tekkura/sr-cad/pcb/robot/usb-pd-module/ALTIUM_EMBEDDED_MODELS/LED 0603 Orange.STEP

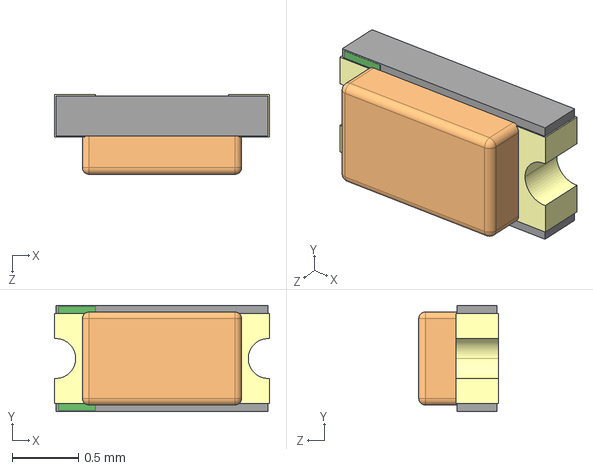
[picture p1: CAD file, 2026-01-23]
pcb/robot/usb-pd-module/ALTIUM_EMBEDDED_MODELS/LED 0603 Orange.STEP
1.62 x 0.8 x 0.6 mm
