tekkura/sr-cad/pcb/robot/usb-pd-module/ALTIUM_EMBEDDED_MODELS/Keystone_5012.stp

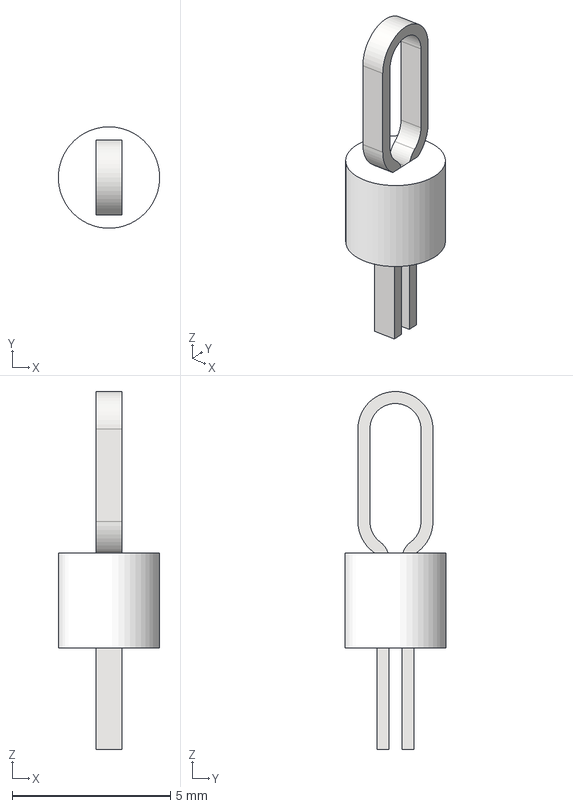
[picture p2: CAD file, 2026-01-23]
pcb/robot/usb-pd-module/ALTIUM_EMBEDDED_MODELS/Keystone_5012.stp
3.20 x 3.20 x 11.3 mm
