tekkura/sr-cad/pcb/robot/usb-pd-module/ALTIUM_EMBEDDED_MODELS/RES_0402.step

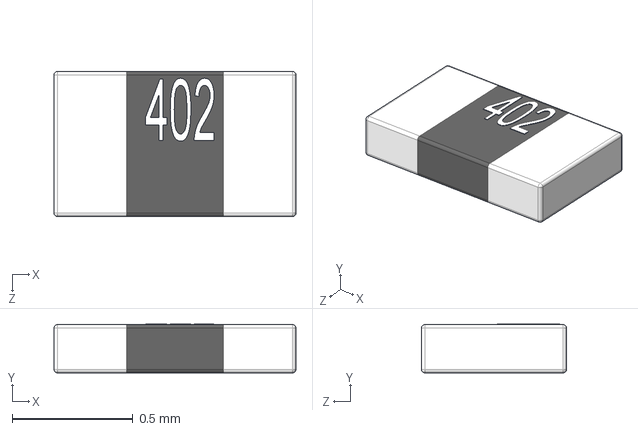
[picture p3: CAD file, 2026-01-23]
pcb/robot/usb-pd-module/ALTIUM_EMBEDDED_MODELS/RES_0402.step
1.00 x 0.202 x 0.6 mm
