tekkura/sr-cad/pcb/robot/usb-pd-module/ALTIUM_EMBEDDED_MODELS/SOIC-8.step

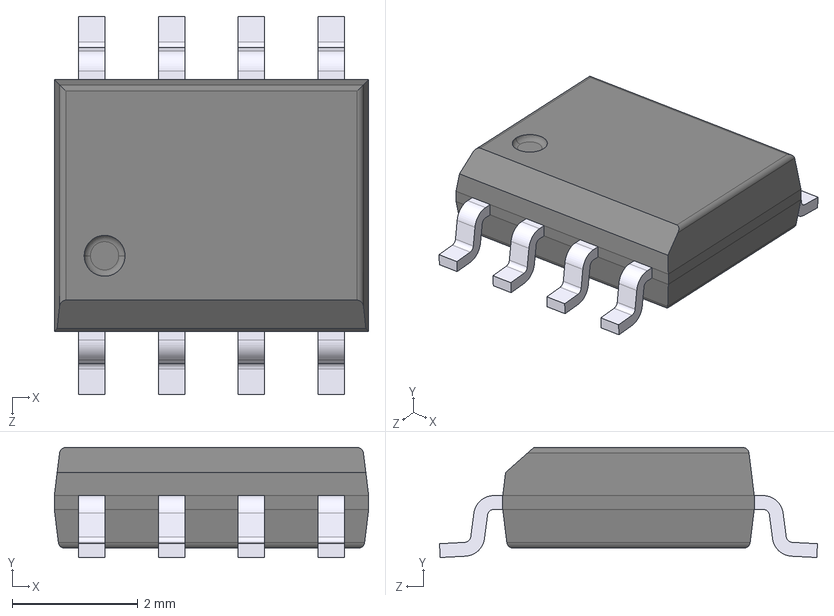
[picture p4: CAD file, 2026-01-23]
pcb/robot/usb-pd-module/ALTIUM_EMBEDDED_MODELS/SOIC-8.step
5.00 x 1.75 x 6.01 mm
User Library-SOIC-8_SOIC-8_Body_1
User Library-SOIC-8_SOIC-8_Pins_1
