tekkura/sr-cad/pcb/robot/usb-pd-module/ALTIUM_EMBEDDED_MODELS/On-Shore_ED555_2DS.stp

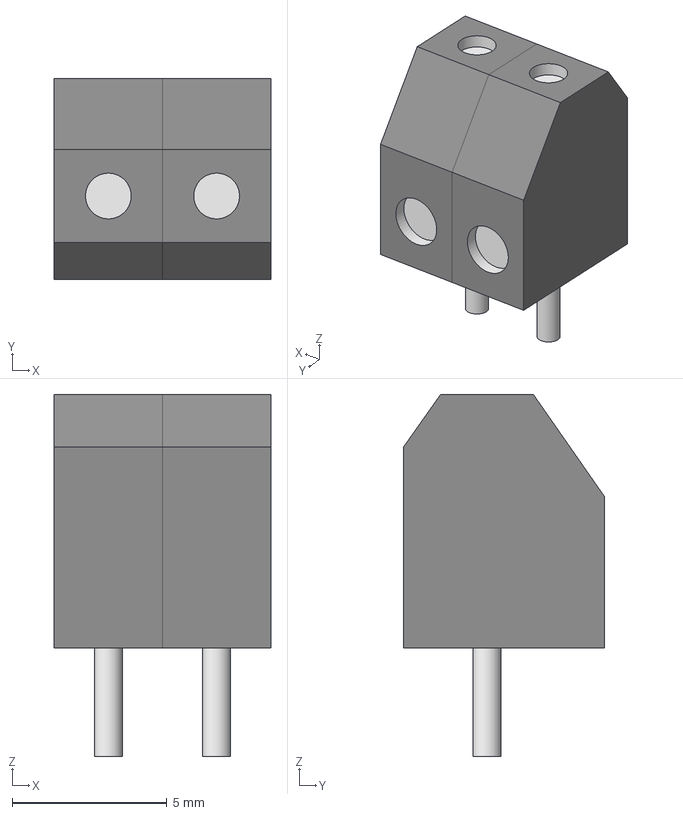
[picture p5: CAD file, 2026-01-23]
pcb/robot/usb-pd-module/ALTIUM_EMBEDDED_MODELS/On-Shore_ED555_2DS.stp
7.00 x 6.50 x 11.7 mm
