tekkura/sr-cad/pcb/robot/usb-pd-module/ALTIUM_EMBEDDED_MODELS/SOD-123.stp

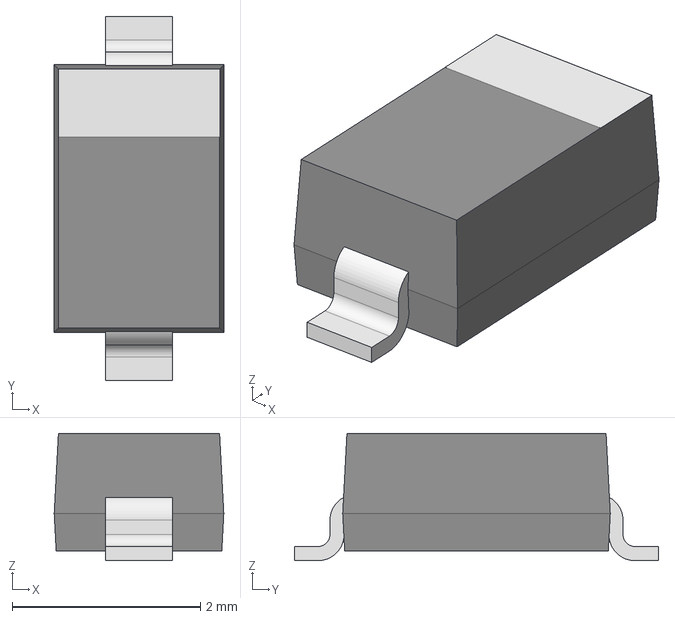
[picture p6: CAD file, 2026-01-23]
pcb/robot/usb-pd-module/ALTIUM_EMBEDDED_MODELS/SOD-123.stp
1.80 x 3.86 x 1.35 mm
