tekkura/sr-cad/pcb/robot/usb-pd-module/ALTIUM_EMBEDDED_MODELS/DQG0008A.stp

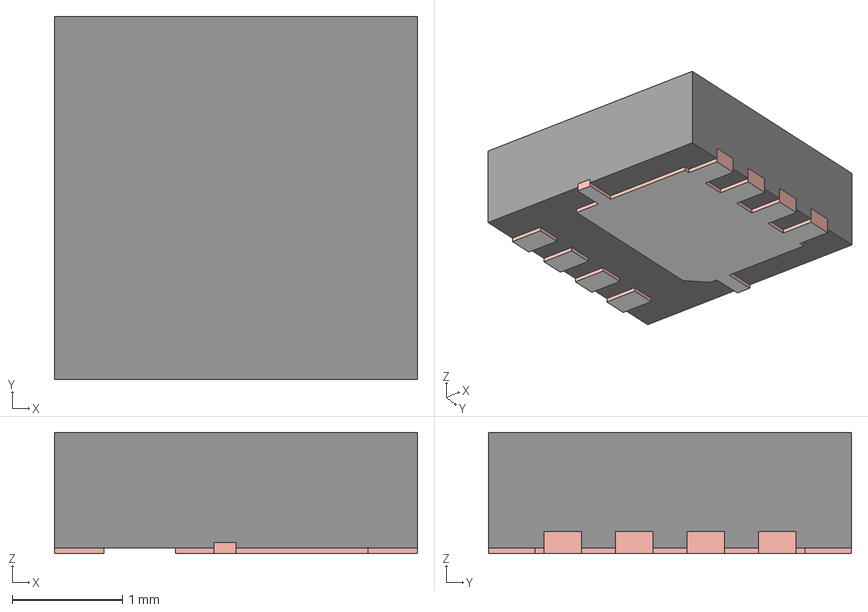
[picture p8: CAD file, 2026-01-23]
pcb/robot/usb-pd-module/ALTIUM_EMBEDDED_MODELS/DQG0008A.stp
3.30 x 3.30 x 1.10 mm
