tekkura/sr-cad/pcb/robot/usb-pd-module/ALTIUM_EMBEDDED_MODELS/SOT-23-5.step

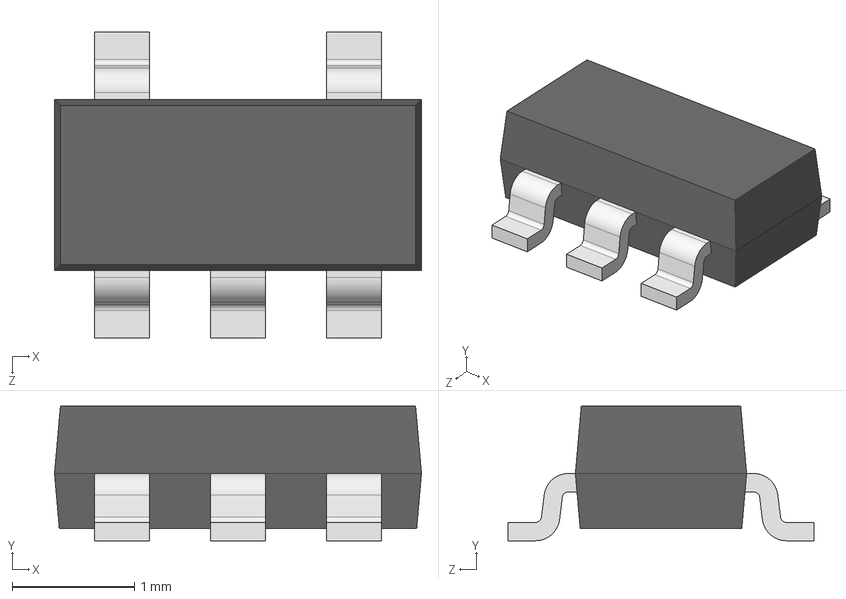
[picture p9: CAD file, 2026-01-23]
pcb/robot/usb-pd-module/ALTIUM_EMBEDDED_MODELS/SOT-23-5.step
3.00 x 1.10 x 2.50 mm
