tekkura/sr-cad/pcb/robot/usb-pd-module/ALTIUM_EMBEDDED_MODELS/CAP_C_0603.step

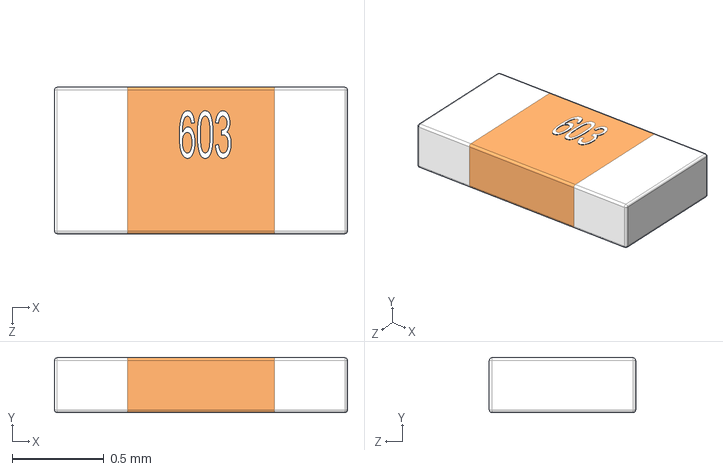
[picture p11: CAD file, 2026-01-23]
pcb/robot/usb-pd-module/ALTIUM_EMBEDDED_MODELS/CAP_C_0603.step
1.60 x 0.302 x 0.8 mm
