tekkura/sr-cad/pcb/robot/usb-pd-module/ALTIUM_EMBEDDED_MODELS/Res_TE_CRGP0402F33R_eec.STEP

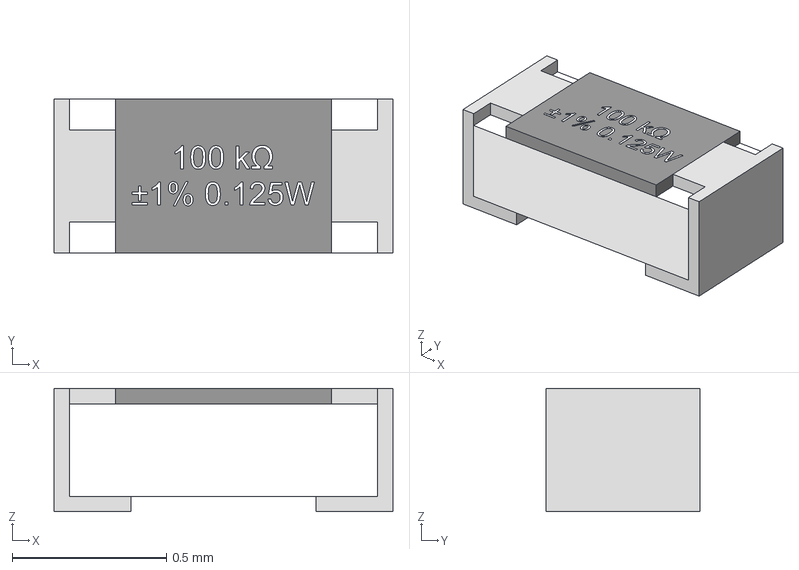
[picture p12: CAD file, 2026-01-23]
pcb/robot/usb-pd-module/ALTIUM_EMBEDDED_MODELS/Res_TE_CRGP0402F33R_eec.STEP
1.10 x 0.5 x 0.4 mm
terminals
top
value
