tekkura/sr-cad/pcb/robot/usb-pd-module/ALTIUM_EMBEDDED_MODELS/3M_2510-6002.stp

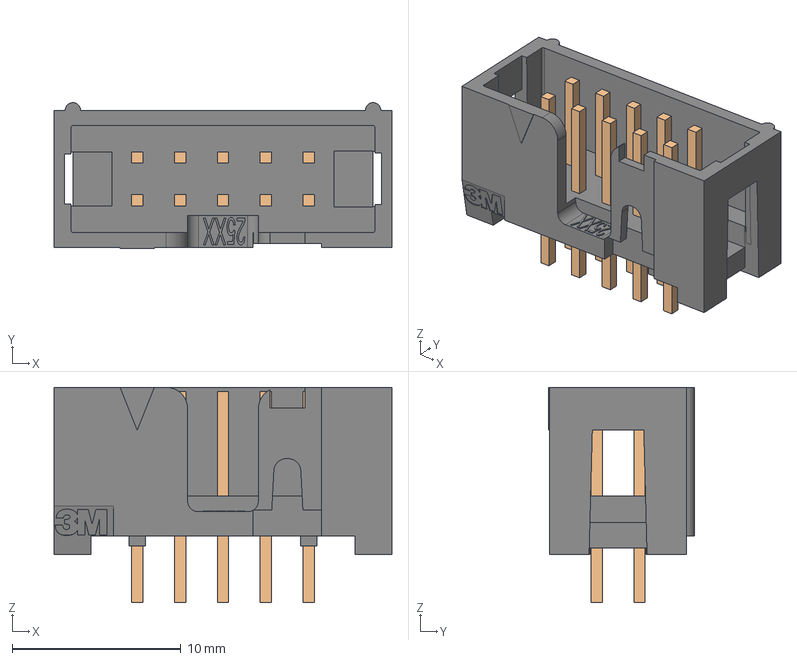
[picture p13: CAD file, 2026-01-23]
pcb/robot/usb-pd-module/ALTIUM_EMBEDDED_MODELS/3M_2510-6002.stp
20.0 x 8.64 x 12.8 mm
