tekkura/sr-cad/pcb/robot/usb-pd-module/ALTIUM_EMBEDDED_MODELS/Lite-On_LTST_C190.stp

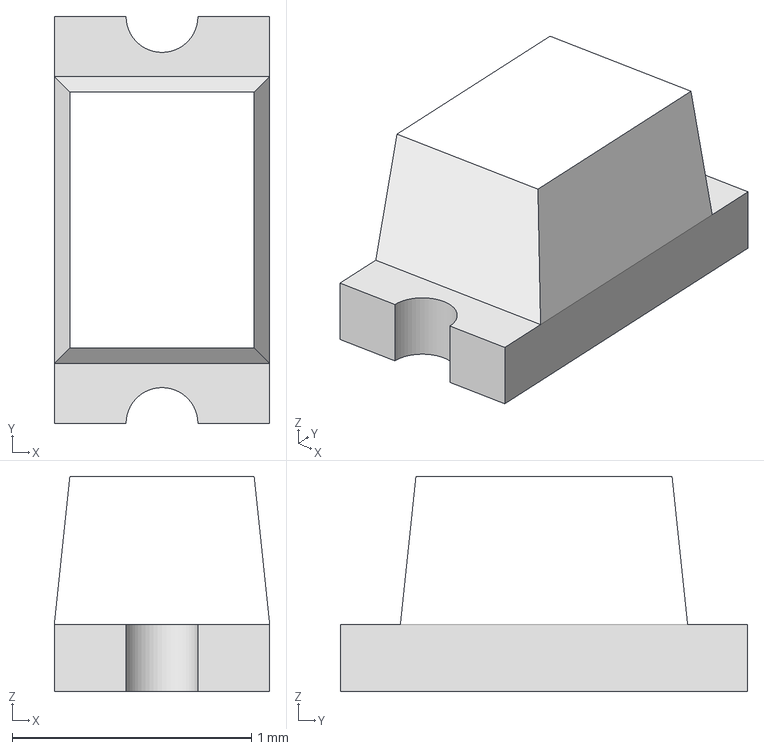
[picture p14: CAD file, 2026-01-23]
pcb/robot/usb-pd-module/ALTIUM_EMBEDDED_MODELS/Lite-On_LTST_C190.stp
0.9 x 1.70 x 0.9 mm
