tekkura/sr-cad/pcb/robot/usb-pd-module/ALTIUM_EMBEDDED_MODELS/Res_Vishay_CRCW06033M90FKEC_eec.STEP

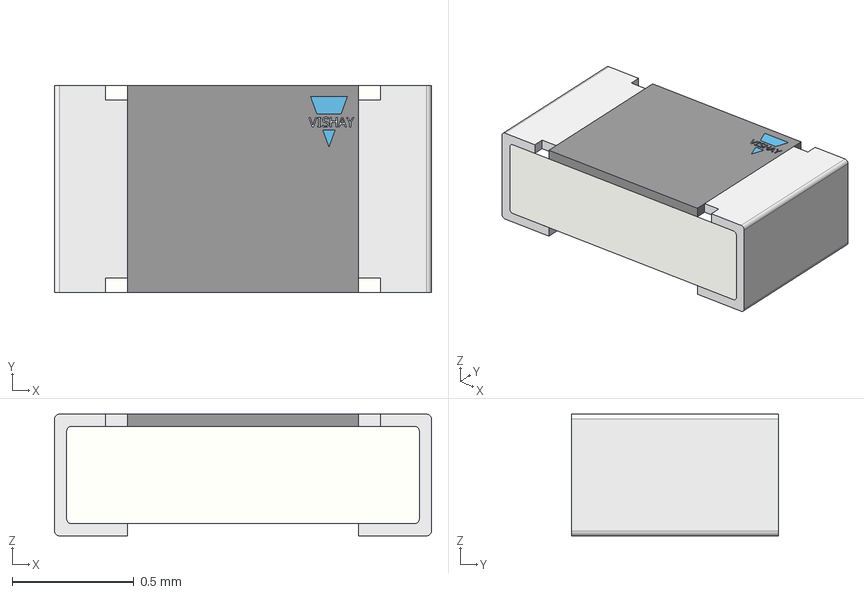
[picture p15: CAD file, 2026-01-23]
pcb/robot/usb-pd-module/ALTIUM_EMBEDDED_MODELS/Res_Vishay_CRCW06033M90FKEC_eec.STEP
1.55 x 0.85 x 0.5 mm
