tekkura/sr-cad/pcb/robot/usb-pd-module/ALTIUM_EMBEDDED_MODELS/Keystone_5000.stp

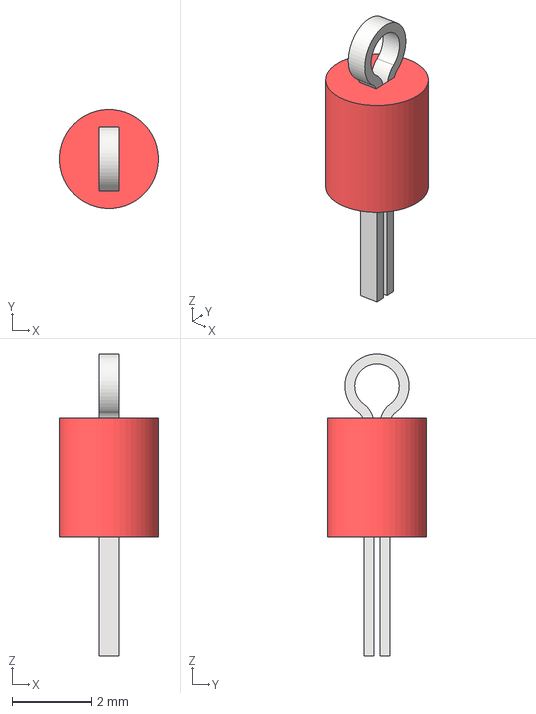
[picture p16: CAD file, 2026-01-23]
pcb/robot/usb-pd-module/ALTIUM_EMBEDDED_MODELS/Keystone_5000.stp
2.50 x 2.50 x 7.62 mm
