tekkura/sr-cad/pcb/robot/usb-pd-module/ALTIUM_EMBEDDED_MODELS/Conn_Harwin_M20-9990246_eec.STEP

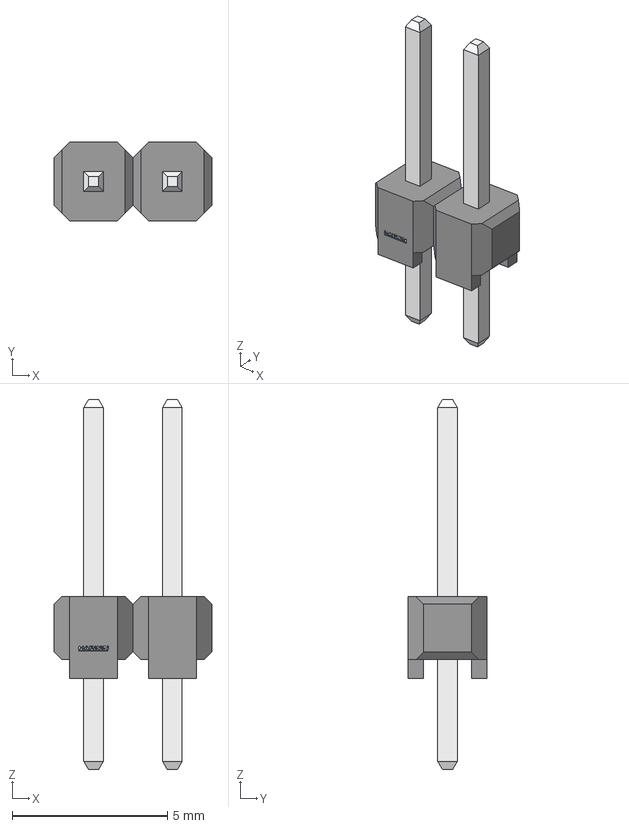
[picture p17: CAD file, 2026-01-23]
pcb/robot/usb-pd-module/ALTIUM_EMBEDDED_MODELS/Conn_Harwin_M20-9990246_eec.STEP
5.08 x 2.54 x 11.9 mm
