tekkura/sr-cad/pcb/robot/usb-pd-module/ALTIUM_EMBEDDED_MODELS/HDR_M_254_1x3.step

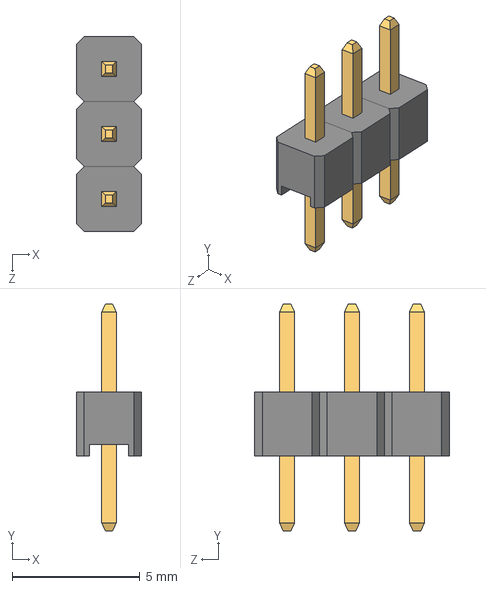
[picture p18: CAD file, 2026-01-23]
pcb/robot/usb-pd-module/ALTIUM_EMBEDDED_MODELS/HDR_M_254_1x3.step
2.54 x 8.88 x 7.62 mm
