tekkura/sr-cad/pcb/robot/usb-pd-module/ALTIUM_EMBEDDED_MODELS/DNH0008A.stp

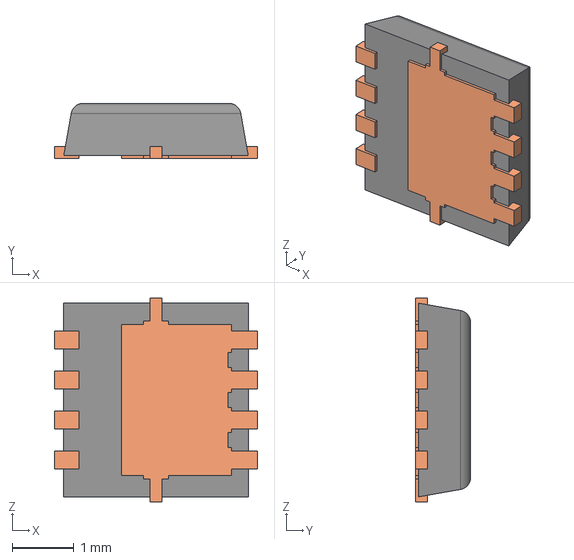
[picture p20: CAD file, 2026-01-23]
pcb/robot/usb-pd-module/ALTIUM_EMBEDDED_MODELS/DNH0008A.stp
3.30 x 0.9 x 3.31 mm
