tekkura/sr-cad/pcb/robot/usb-pd-module/ALTIUM_EMBEDDED_MODELS/ED1204DS.stp

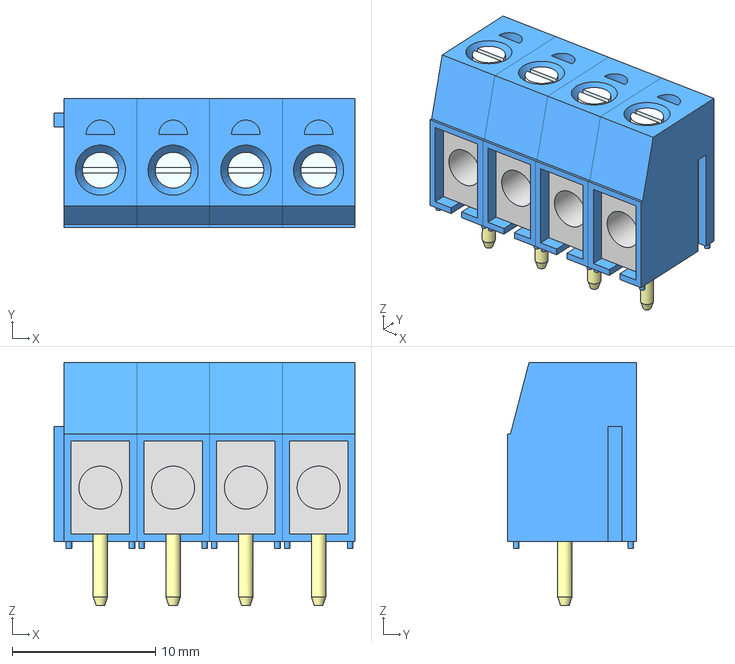
[picture p21: CAD file, 2026-01-23]
pcb/robot/usb-pd-module/ALTIUM_EMBEDDED_MODELS/ED1204DS.stp
21.0 x 9.00 x 17.0 mm
