tekkura/sr-cad/pcb/robot/usb-pd-module/ALTIUM_EMBEDDED_MODELS/3M_SJ5003Transparent.stp

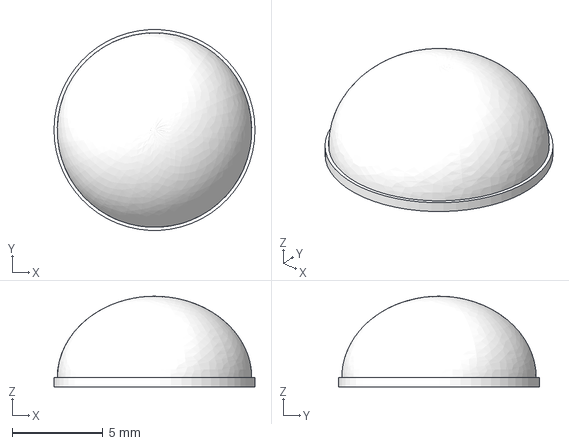
[picture p22: CAD file, 2026-01-23]
pcb/robot/usb-pd-module/ALTIUM_EMBEDDED_MODELS/3M_SJ5003Transparent.stp
11.1 x 11.1 x 5.00 mm
