tekkura/sr-cad/pcb/robot/usb-pd-module/ALTIUM_EMBEDDED_MODELS/SOD-323.stp

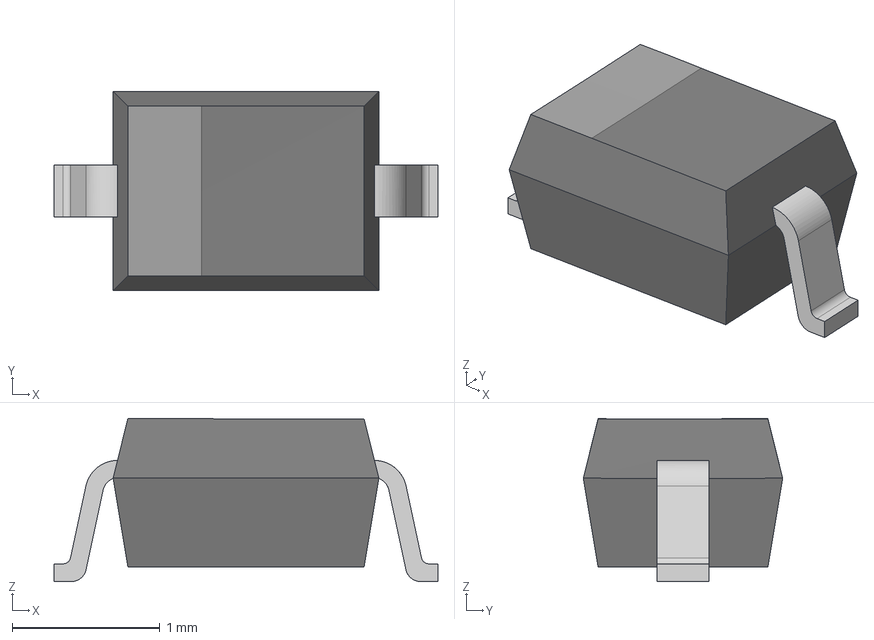
[picture p23: CAD file, 2026-01-23]
pcb/robot/usb-pd-module/ALTIUM_EMBEDDED_MODELS/SOD-323.stp
2.60 x 1.35 x 1.10 mm
