tekkura/sr-cad/pcb/robot/usb-pd-module/ALTIUM_EMBEDDED_MODELS/Conn_Samtec_SNT-100-BK-G_eec.STEP

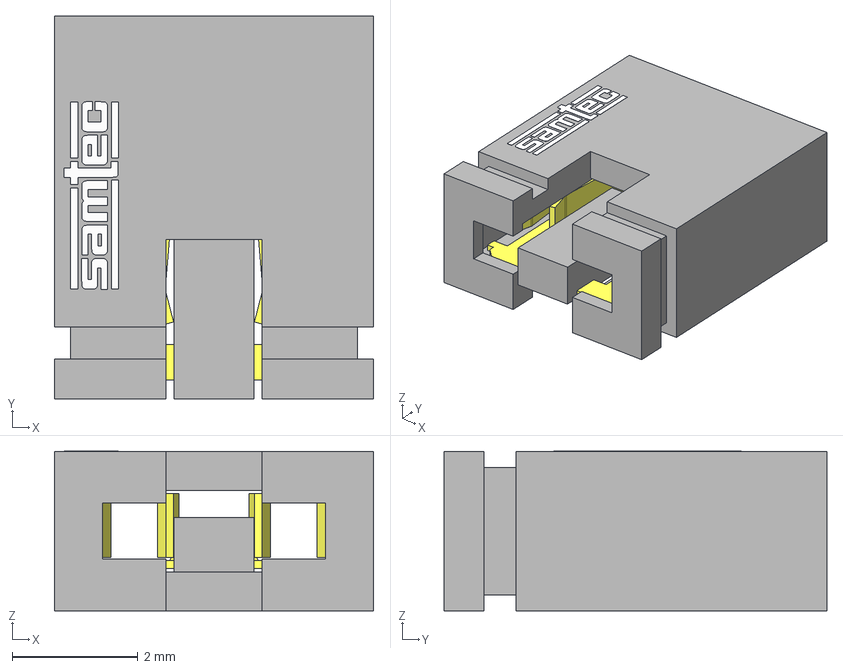
[picture p25: CAD file, 2026-01-23]
pcb/robot/usb-pd-module/ALTIUM_EMBEDDED_MODELS/Conn_Samtec_SNT-100-BK-G_eec.STEP
5.08 x 6.10 x 2.54 mm
SNT-100-BK_body
SNT-100_pins
Samtec
