tekkura/sr-cad/pcb/robot/usb-pd-module/ALTIUM_EMBEDDED_MODELS/Molex_22-05-3041.stp

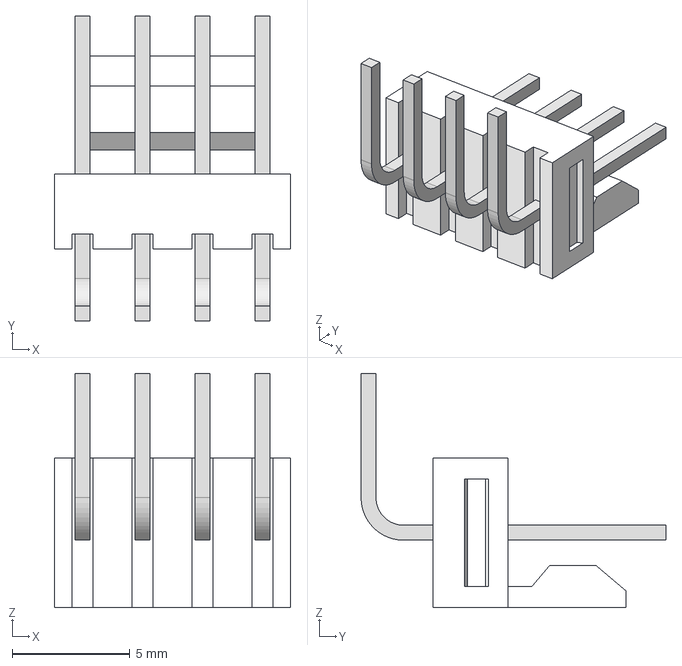
[picture p26: CAD file, 2026-01-23]
pcb/robot/usb-pd-module/ALTIUM_EMBEDDED_MODELS/Molex_22-05-3041.stp
10.0 x 12.9 x 9.93 mm
