tekkura/sr-cad/pcb/robot/usb-pd-module/ALTIUM_EMBEDDED_MODELS/keystone_5016.stp

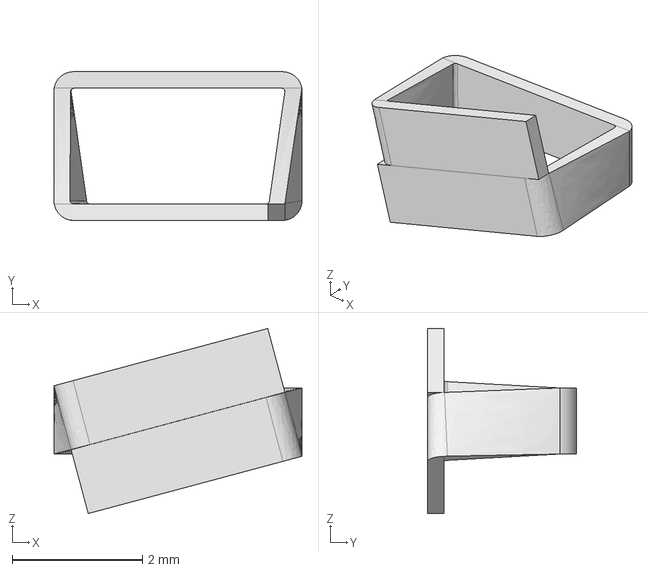
[picture p27: CAD file, 2026-01-23]
pcb/robot/usb-pd-module/ALTIUM_EMBEDDED_MODELS/keystone_5016.stp
3.81 x 2.29 x 2.85 mm
