tekkura/sr-cad/pcb/robot/usb-pd-module/ALTIUM_EMBEDDED_MODELS/ED1202DS.stp

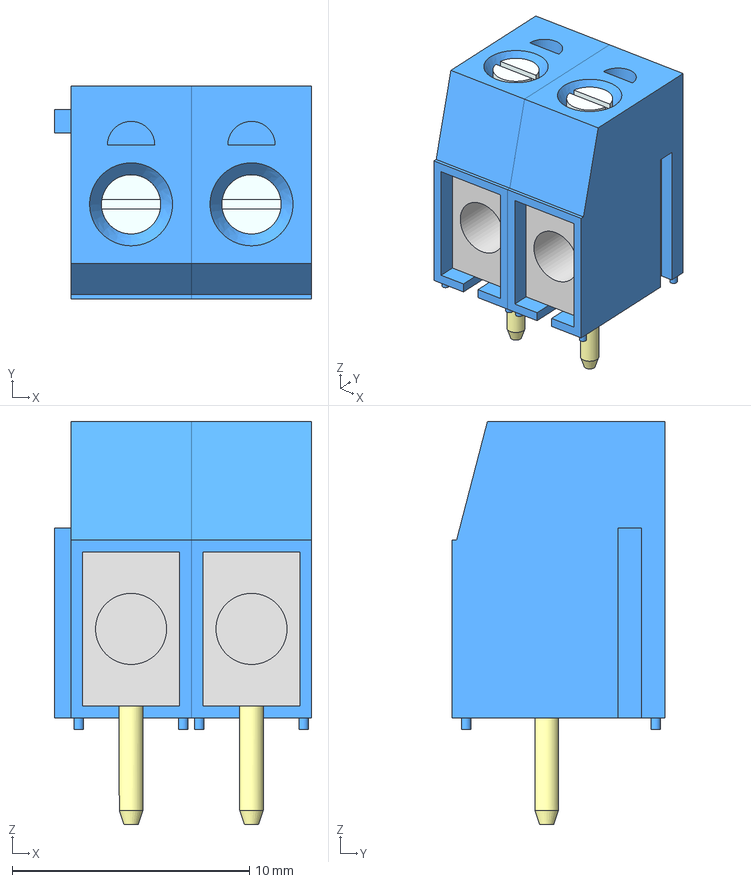
[picture p28: CAD file, 2026-01-23]
pcb/robot/usb-pd-module/ALTIUM_EMBEDDED_MODELS/ED1202DS.stp
10.9 x 9.00 x 17.0 mm
