tekkura/sr-cad/pcb/robot/usb-pd-module/ALTIUM_EMBEDDED_MODELS/DBZ0003A.stp

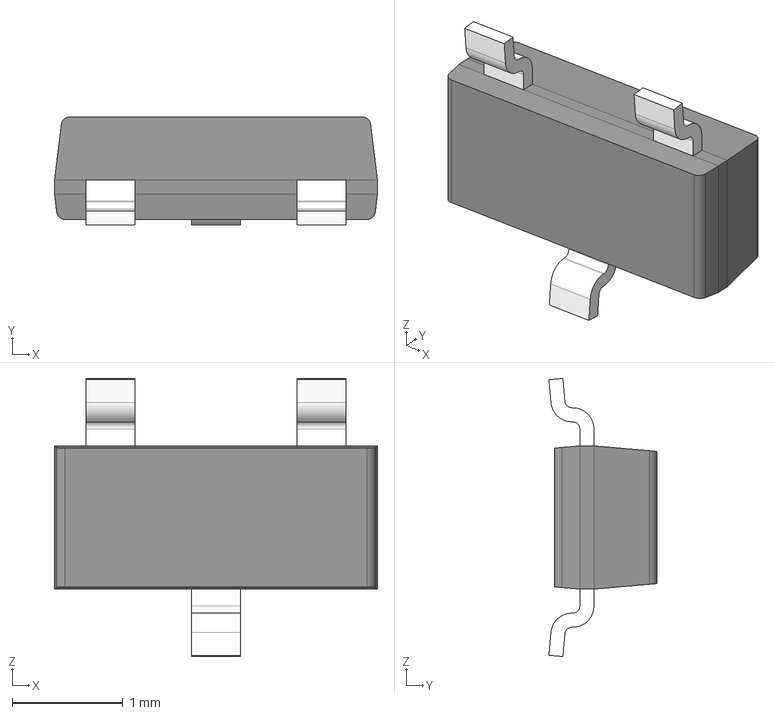
[picture p29: CAD file, 2026-01-23]
pcb/robot/usb-pd-module/ALTIUM_EMBEDDED_MODELS/DBZ0003A.stp
2.92 x 0.978 x 2.51 mm
