tekkura/sr-cad/(list of files, cad)

Other CAD files:
pcb/robot/usb-pd-module/ALTIUM_EMBEDDED_MODELS/LED 0603 Green.STEP
pcb/robot/usb-pd-module/ALTIUM_EMBEDDED_MODELS/Keystone_5002.stp
pcb/robot/usb-pd-module/ALTIUM_EMBEDDED_MODELS/Keystone_5003.stp
pcb/robot/usb-pd-module/ALTIUM_EMBEDDED_MODELS/Keystone_5004.stp
pcb/robot/usb-pd-module/ALTIUM_EMBEDDED_MODELS/CAP_C_0402.step
pcb/robot/usb-pd-module/ALTIUM_EMBEDDED_MODELS/20021111-00010XXLFc.stp
