tekkura/sr-cad/pcb/robot/robot.kicad_pcb

## KiCad design pcb/robot/robot.kicad_pcb (2026-08-28)

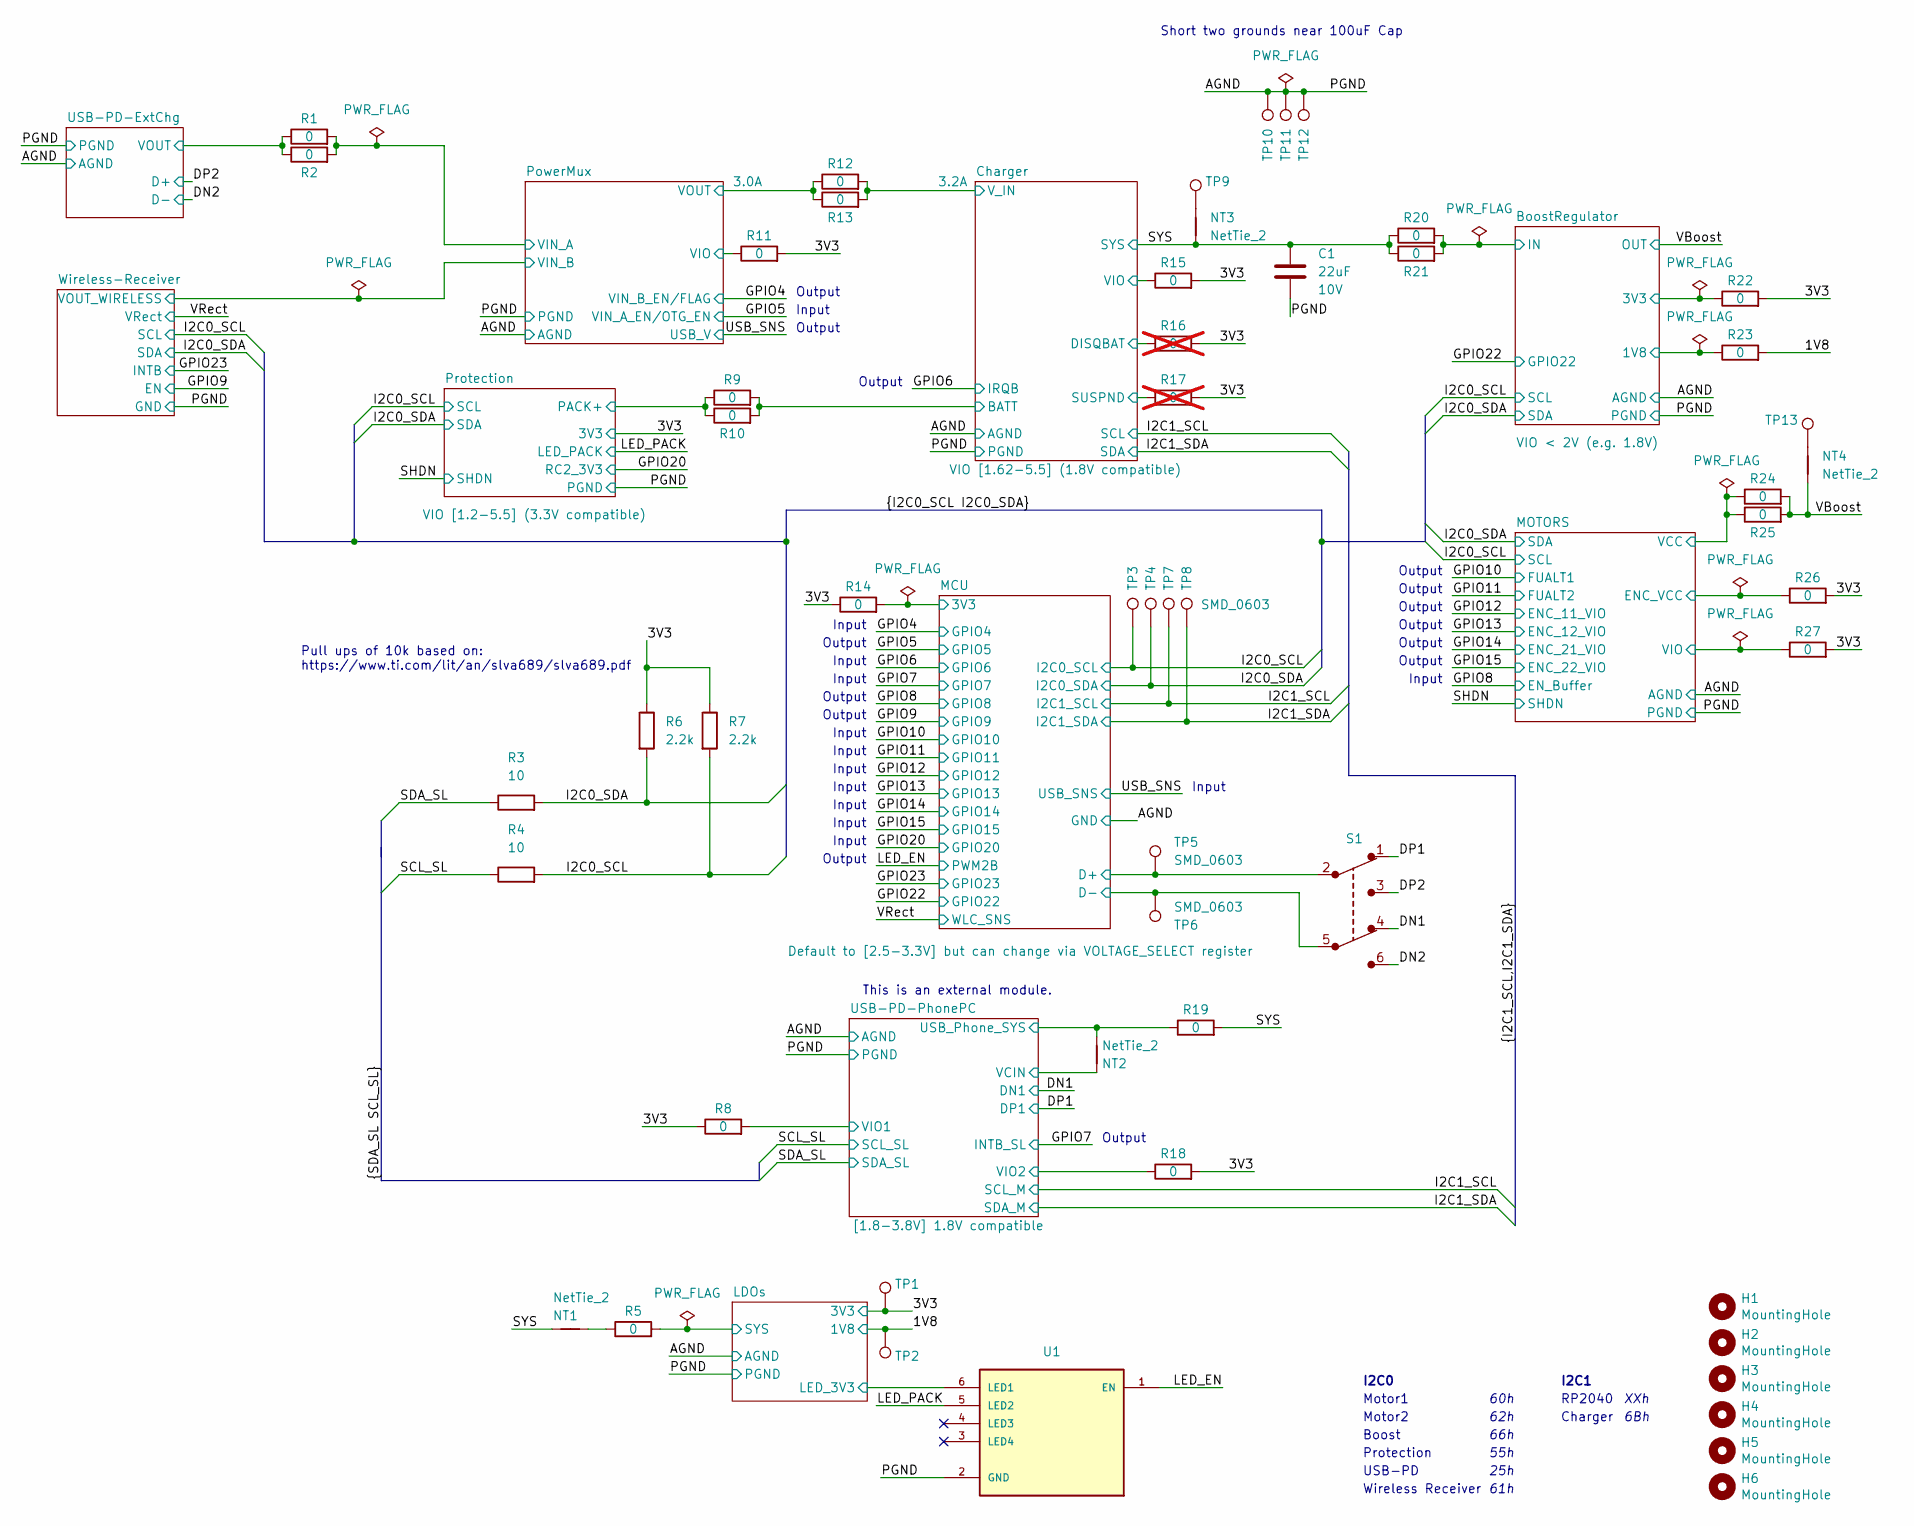
[picture p30: schematic robot.kicad_sch]

Parts:
C1: 22uF; C_0603_1608Metric; Part Number GRM188R61A226ME15D
H1, H2, H5, H6: MountingHole; MountingHole_2.2mm_M2_2mm_clearance; Part Number N/A
H3, H4: MountingHole; MountingHole_2.2mm_M2; Part Number N/A
NT1, NT2, NT3, NT4: NetTie_2; NetTie-_SMD_Pad6mil; Part Number N/A
R1, R2, R9, R10, R12, R13, R19, R20, R21, R24, R25: 0; R_0805_2012Metric; Part Number RMCF0805ZT0R00
R3, R4: 10; R_0402_1005Metric; Part Number RC0402FR-1310RL
R5, R8, R11, R14, R15, R18, R22, R23, R26, R27: 0; R_0603_1608Metric; Part Number RMCF0603ZT0R00
R6, R7: 2.2k; R_0603_1608Metric; Part Number RMCF0603JT2K20
R16, R17: 0; R_0603_1608Metric; Part Number RMCF0603ZT0R00; not fitted
S1: JS202011JCQN; SW_JS202011JCQN; Part Number JS202011JCQN
TP1, TP2, TP9, TP10, TP11, TP12, TP13: TestPoint; KEYSTONE_5002; Part Number 5002
TP3, TP4, TP5, TP6, TP7, TP8: SMD_0603; TestPoint_SMD_0603; Part Number RCUCTE
U1: AP2502KTR-G1; SOT95P280X145-6N; Part Number AP2502KTR-G1

Connections:
/1V8: R23.2, TP2.1; also elsewhere on the board
/3V3: R6.1, R7.1, R8.1, R11.2, R14.1, R15.2, R16.2, R17.2, R18.2, R22.2, R26.2, R27.2, TP1.1; also elsewhere on the board
/BoostRegulator/1V8: R23.1; also elsewhere on the board
/BoostRegulator/3V3: R22.1; also elsewhere on the board
/BoostRegulator/IN: R20.2, R21.2; also elsewhere on the board
/Charger/BATT: R9.2, R10.2; also elsewhere on the board
/Charger/DISQBAT: R16.1; also elsewhere on the board
/Charger/SUSPND: R17.1; also elsewhere on the board
/Charger/VIO: R15.1; also elsewhere on the board
/Charger/V_IN: R12.2, R13.2; also elsewhere on the board
/DN1: S1.4; also elsewhere on the board
/DN2: S1.6; also elsewhere on the board
/DP1: S1.1; also elsewhere on the board
/DP2: S1.3; also elsewhere on the board
/I2C0_SCL: R4.2, R7.2, TP3.1; also elsewhere on the board
/I2C0_SDA: R3.2, R6.2, TP4.1; also elsewhere on the board
/I2C1_SCL: TP7.1; also elsewhere on the board
/I2C1_SDA: TP8.1; also elsewhere on the board
/LDOs/LED_3V3: U1.6 (LED1); also elsewhere on the board
/LDOs/SYS: R5.2; also elsewhere on the board
/LED_EN: U1.1 (EN); also elsewhere on the board
/LED_PACK: U1.5 (LED2); also elsewhere on the board
/MCU/3V3: R14.2; also elsewhere on the board
/MCU/D+: S1.2, TP5.1; also elsewhere on the board
/MCU/D-: S1.5, TP6.1; also elsewhere on the board
/MOTORS/ENC_VCC: R26.1; also elsewhere on the board
/MOTORS/VCC: R24.1, R25.1; also elsewhere on the board
/MOTORS/VIO: R27.1; also elsewhere on the board
/PowerMux/VIN_A: R1.2, R2.2; also elsewhere on the board
/PowerMux/VIO: R11.1; also elsewhere on the board
/PowerMux/VOUT: R12.1, R13.1; also elsewhere on the board
/Protection/PACK+: R9.1, R10.1; also elsewhere on the board
/SCL_SL: R4.1; also elsewhere on the board
/SDA_SL: R3.1; also elsewhere on the board
/SYS: C1.1, NT1.1, NT3.2, R19.2, R20.1, R21.1; also elsewhere on the board
/USB-PD-ExtChg/VOUT: R1.1, R2.1; also elsewhere on the board
/USB-PD-PhonePC/USB_Phone_SYS: NT2.2, R19.1; also elsewhere on the board
/USB-PD-PhonePC/VCIN: NT2.1; also elsewhere on the board
/USB-PD-PhonePC/VIO1: R8.2; also elsewhere on the board
/USB-PD-PhonePC/VIO2: R18.1; also elsewhere on the board
/VBoost: NT4.2, R24.2, R25.2; also elsewhere on the board
GND: C1.2, TP10.1, TP11.1, TP12.1, U1.2 (GND); also elsewhere on the board
unnamed: NT1.2, R5.1
unnamed: NT3.1, TP9.1
unnamed: NT4.1, TP13.1

Notes on the sheet:
55h
Input
66h
Output
Protection
XXh
61h
Boost
I2C1
Wireless Receiver
Motor1
62h
Motor2
25h
Charger
This is an external module.
Pull ups of 10k based on: https://www.ti.com/lit/an/slva689/slva689.pdf
I2C0
USB-PD
RP2040
60h
6Bh
Short two grounds near 100uF Cap

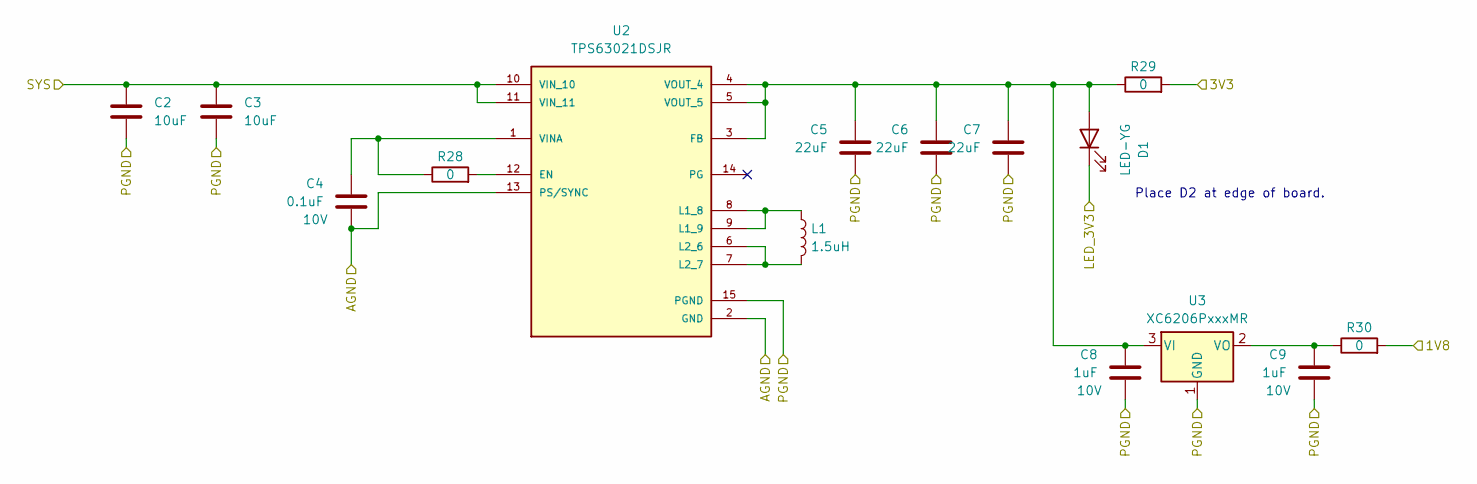
[picture p31: schematic LDO.kicad_sch]

Parts:
C2, C3: 10uF; C_0603_1608Metric; Part Number GRM188R61E106KA73J
C4: 0.1uF; C_0402_1005Metric; Part Number CL05A104KA5NNNC
C5, C6, C7: 22uF; C_0603_1608Metric; Part Number GRM188R61A226ME15D
C8, C9: 1uF; C_0402_1005Metric; Part Number GRM155R61E105KA12D
D1: LED-YG; B12H1UYG-20D000134U1930; Part Number B12H1UYG-20D000134U1930
L1: 1.5uH; NRS6028T1R5NMGJ; Part Number NRS6028T1R5NMGJ
R28, R29, R30: 0; R_0603_1608Metric; Part Number RMCF0603ZT0R00
U2: TPS63021DSJR; IC_TPS63021DSJR; PARTREV I; DigiKey_Part_Number 296-27259-1-ND
U3: XC6206PxxxMR; SOT-23-3; Part Number C49195704

Connections:
/1V8: R30.2; also elsewhere on the board
/3V3: R29.2; also elsewhere on the board
/LDOs/LED_3V3: D1.1 (K); also elsewhere on the board
/LDOs/SYS: C2.2, C3.2, U2.10 (VIN_10), U2.11 (VIN_11); also elsewhere on the board
GND: C2.1, C3.1, C4.2, C5.2, C6.2, C7.2, C8.2, C9.2, U2.2 (GND), U2.13 (PS/SYNC), U2.15 (PGND), U3.1 (GND); also elsewhere on the board
unnamed: C5.1, C6.1, C7.1, C8.1, D1.2 (A), R29.1, U2.3 (FB), U2.4 (VOUT_4), U2.5 (VOUT_5), U3.3 (VI)
unnamed: R28.2, U2.12 (EN)
unnamed: L1.1, U2.8 (L1_8), U2.9 (L1_9)
unnamed: L1.2, U2.6 (L2_6), U2.7 (L2_7)
unnamed: C4.1, R28.1, U2.1 (VINA)
unnamed: C9.1, R30.1, U3.2 (VO)

Notes on the sheet:
Place D2 at edge of board.

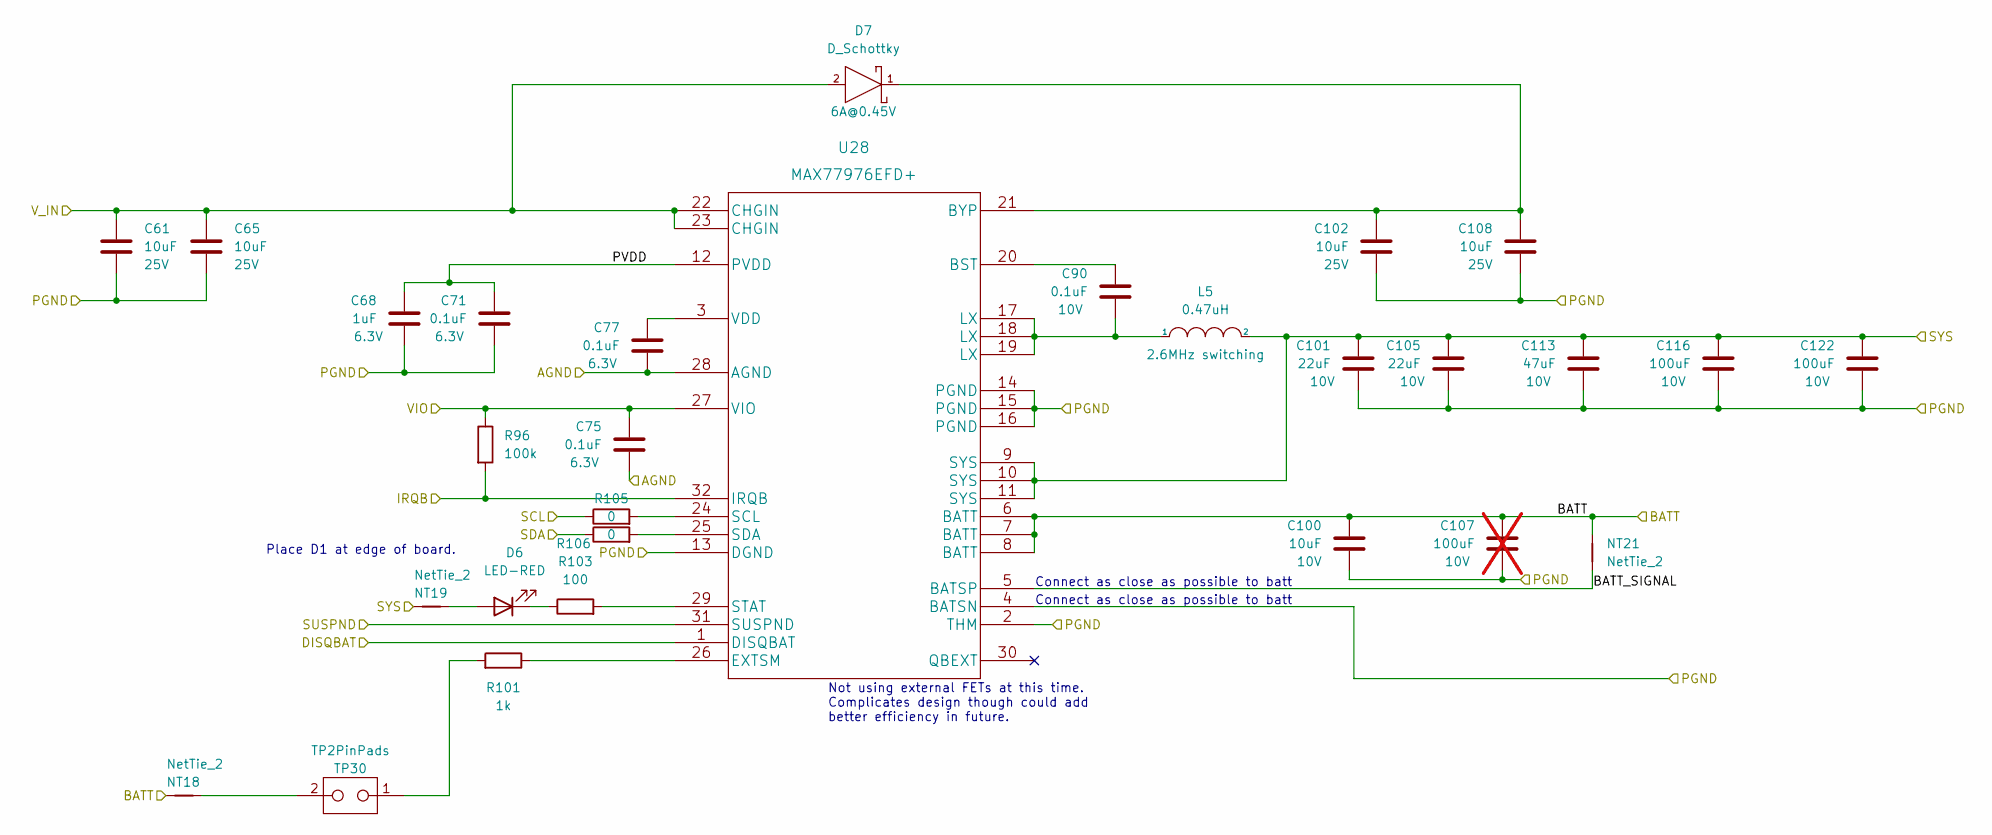
[picture p32: schematic Charger.kicad_sch]

Parts:
C61, C65, C100, C102, C108: 10uF; C_0603_1608Metric; Part Number GRM188R61E106KA73J
C68: 1uF; C_0402_1005Metric; Part Number GRM155R61E105KA12D
C71, C75, C77, C90: 0.1uF; C_0402_1005Metric; Part Number CL05A104KA5NNNC
C101, C105: 22uF; C_0603_1608Metric; Part Number GRM188R61A226ME15D
C107: 100uF; C_1206_3216Metric; Part Number GRM31CD80J107MEA8K; not fitted
C113: 47uF; C_0805_2012Metric; Part Number CL21A476MRYNNNE
C116, C122: 100uF; C_1206_3216Metric; Part Number GRM31CD80J107MEA8K
D6: LED-RED; B12H1UYG-20D000134U1930; Part Number B12H1USD-20D000234U1930
D7: D_Schottky; SD2114S040S8R0; Part Number SD2114S040S8R0
L5: 0.47uH; Vishay-IHLP-2020BZ-FP_1.905x2.79-3D_2.0-0-0-MFG; Part Number IHLP2020BZERR47M01
NT18, NT19, NT21: NetTie_2; NetTie-_SMD_Pad6mil; Part Number N/A
R96: 100k; R_0603_1608Metric; Part Number WR06X1003FTL
R101: 1k; R_0402_1005Metric; Part Number WR04X102 JTL
R103: 100; R_0603_1608Metric; Part Number RMCF0603JT100R
R105, R106: 0; R_0603_1608Metric; Part Number RMCF0603ZT0R00
TP30: TP2PinPads; TestPoint_2Pads_Pitch2mm_SMD; Part Number N/A
U28: MAX77976EFD+; MAX77976; Part Number MAX77976EFD+

Connections:
/Charger/BATT: C100.1, C107.1, NT18.1, NT21.1, U28.6 (BATT), U28.7 (BATT), U28.8 (BATT); also elsewhere on the board
/Charger/BATT_SIGNAL: NT21.2, U28.5 (BATSP)
/Charger/DISQBAT: U28.1 (DISQBAT); also elsewhere on the board
/Charger/PVDD: C68.1, C71.1, U28.12 (PVDD)
/Charger/SUSPND: U28.31 (SUSPND); also elsewhere on the board
/Charger/VIO: C75.1, R96.1, U28.27 (VIO); also elsewhere on the board
/Charger/V_IN: C61.1, C65.1, D7.2 (Anode), U28.22 (CHGIN), U28.23 (CHGIN); also elsewhere on the board
/GPIO6: R96.2, U28.32 (IRQB); also elsewhere on the board
/I2C1_SCL: R105.1; also elsewhere on the board
/I2C1_SDA: R106.1; also elsewhere on the board
/SYS: C101.1, C105.1, C113.1, C116.1, C122.1, L5.2, NT19.1, U28.9 (SYS), U28.10 (SYS), U28.11 (SYS); also elsewhere on the board
GND: C61.2, C65.2, C68.2, C71.2, C75.2, C77.2, C100.2, C101.2, C102.2, C105.2, C107.2, C108.2, C113.2, C116.2, C122.2, U28.2 (THM), U28.4 (BATSN), U28.13 (DGND), U28.14 (PGND), U28.15 (PGND), U28.16 (PGND), U28.28 (AGND); also elsewhere on the board
unnamed: C90.2, L5.1, U28.17 (LX), U28.18 (LX), U28.19 (LX)
unnamed: D6.2 (A), NT19.2
unnamed: D6.1 (K), R103.1
unnamed: C102.1, C108.1, D7.1 (Cathode), U28.21 (BYP)
unnamed: NT18.2, TP30.2
unnamed: R101.2, TP30.1
unnamed: C90.1, U28.20 (BST)
unnamed: R101.1, U28.26 (EXTSM)
unnamed: R105.2, U28.24 (SCL)
unnamed: R106.2, U28.25 (SDA)
unnamed: R103.2, U28.29 (STAT)
unnamed: C77.1, U28.3 (VDD)

Notes on the sheet:
Not using external FETs at this time. Complicates design though could add better efficiency in future.
Connect as close as possible to batt
Place D1 at edge of board.

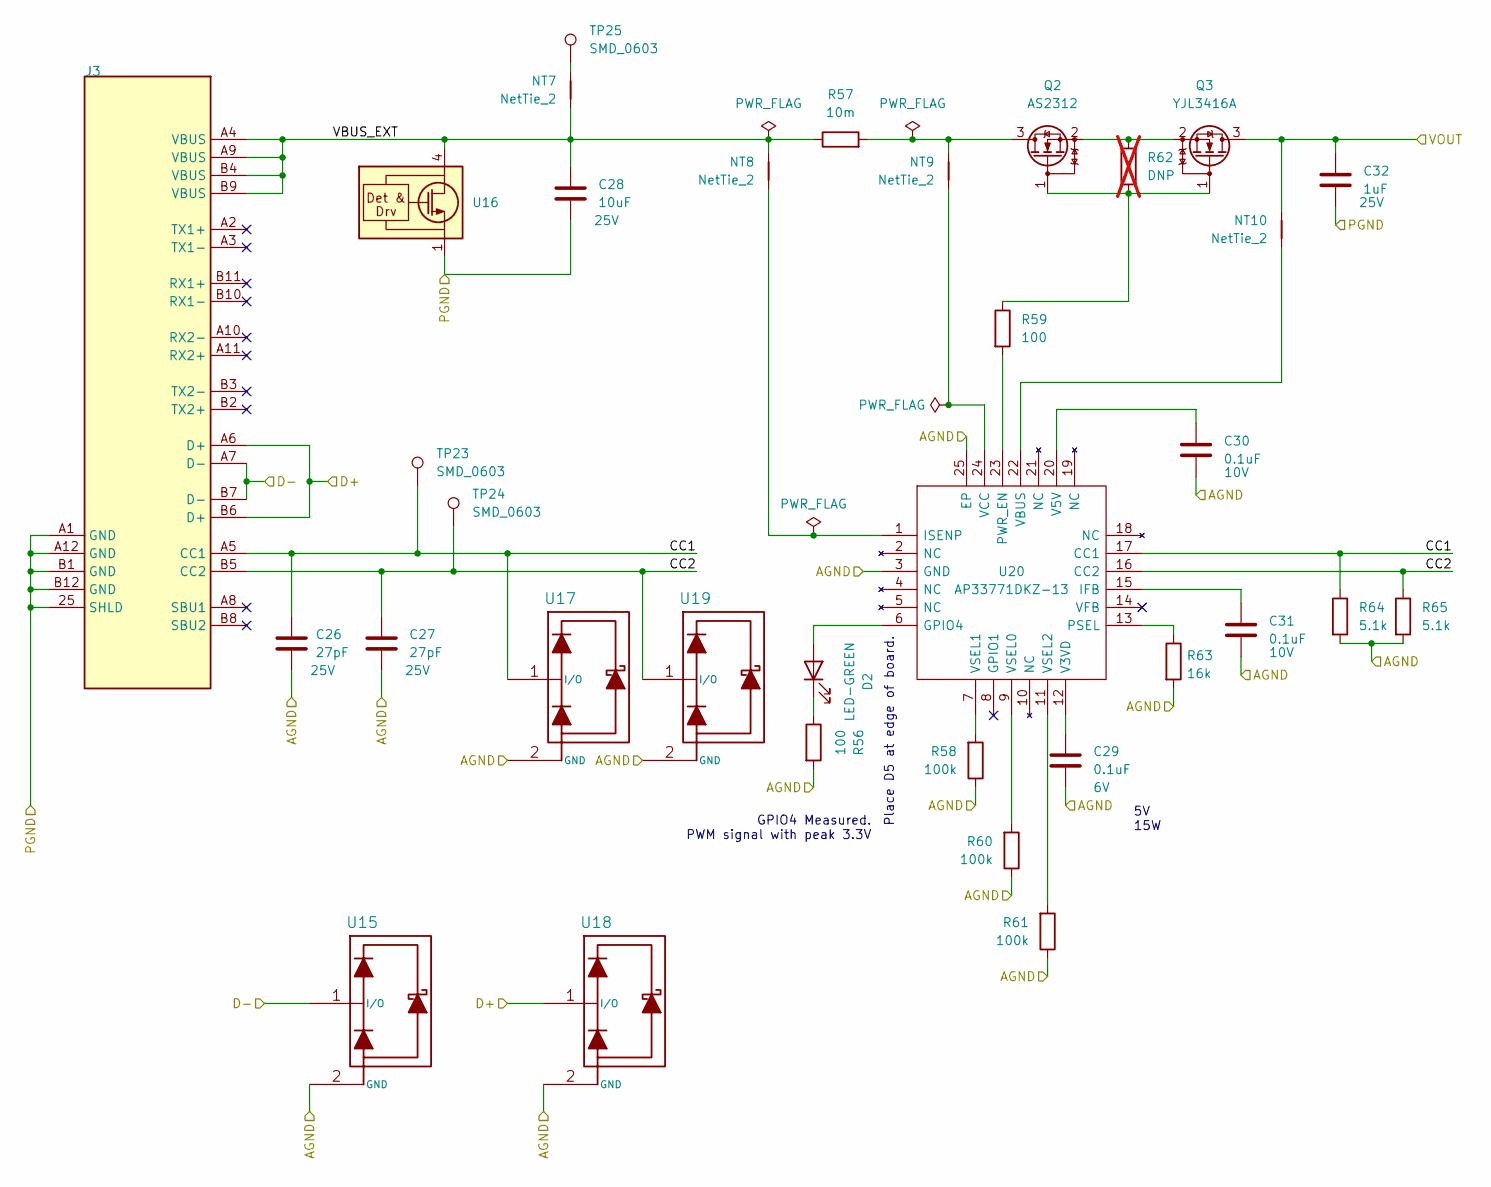
[picture p33: schematic USB-PD-ExtChg.kicad_sch]

Parts:
C26, C27: 27pF; C_0402_1005Metric; Part Number GRM1555C1H270JA01J
C28: 10uF; C_0603_1608Metric; Part Number GRM188R61E106KA73J
C29, C30, C31: 0.1uF; C_0402_1005Metric; Part Number CL05A104KA5NNNC
C32: 1uF; C_0402_1005Metric; Part Number GRM155R61E105KA12D
D2: LED-GREEN; B12H1UYG-20D000134U1930; Part Number B12H1NG--20D000134U1930
J3: USBC_Receptacle_SMD_RA; CON_USB3.1-C_RCPT_SMD_RA_ACP_12401610E4#2A; Part Number 12401610E4#2A
NT7, NT8, NT9, NT10: NetTie_2; NetTie-_SMD_Pad6mil; Part Number N/A
Q2: AS2312; SOT-23; Part Number AS2312
Q3: YJL3416A; SOT-23; Part Number YJL3416A
R56, R59: 100; R_0603_1608Metric; Part Number RMCF0603JT100R
R57: 10m; R_1206_3216Metric; Part Number ERJ-8CWJR010V
R58, R60, R61: 100k; R_0603_1608Metric; Part Number WR06X1003FTL
R62: DNP; R_0603_1608Metric; Part Number DNP; not fitted
R63: 16k; R_0603_1608Metric; Part Number RMCF0603FT16K0
R64, R65: 5.1k; R_0603_1608Metric; Part Number RMCF0603JT5K10
TP23, TP24, TP25: SMD_0603; TestPoint_SMD_0603; Part Number RCUCTE
U15, U17, U18, U19: TPD1E05U06; TPD1E05U06DPYR; Part Number TPD1E05U06DPYR
U16: TVS0500DRV; TVS0500DRVR; Part Number TVS0500DRVR
U20: AP33771DKZ-13; AP33771DKZ13; Part Number AP33771DKZ-13

Connections:
/DN2: J3.A7 (D-), J3.B7 (D-), U15.1 (I/O); also elsewhere on the board
/DP2: J3.A6 (D+), J3.B6 (D+), U18.1 (I/O); also elsewhere on the board
/USB-PD-ExtChg/CC1: C26.1, J3.A5 (CC1), R64.1, TP23.1, U17.1 (I/O), U20.17 (CC1)
/USB-PD-ExtChg/CC2: C27.1, J3.B5 (CC2), R65.1, TP24.1, U19.1 (I/O), U20.16 (CC2)
/USB-PD-ExtChg/VBUS_EXT: C28.1, J3.A4 (VBUS), J3.A9 (VBUS), J3.B4 (VBUS), J3.B9 (VBUS), NT7.2, NT8.1, R57.1, U16.4 (IN), U16.5 (IN), U16.6 (IN)
/USB-PD-ExtChg/VOUT: C32.1, NT10.1, Q3.3 (D); also elsewhere on the board
GND: C26.2, C27.2, C28.2, C29.2, C30.2, C31.2, C32.2, J3.25 (SHLD), J3.A1 (GND), J3.A12 (GND), J3.B1 (GND), J3.B12 (GND), R56.2, R58.1, R60.1, R61.1, R63.2, R64.2, R65.2, U15.2 (GND), U16.1 (GND), U16.2 (GND), U16.3 (GND), U16.7 (GND), U17.2 (GND), U18.2 (GND), U19.2 (GND), U20.3 (GND), U20.25 (EP); also elsewhere on the board
unnamed: D2.2 (A), U20.6 (GPIO4)
unnamed: D2.1 (K), R56.1
unnamed: NT7.1, TP25.1
unnamed: NT9.1, Q2.3 (D), R57.2
unnamed: Q2.1 (G), Q3.1 (G), R59.1, R62.2
unnamed: Q2.2 (S), Q3.2 (S), R62.1
unnamed: C31.1, U20.15 (IFB)
unnamed: NT8.2, U20.1 (ISENP)
unnamed: R63.1, U20.13 (PSEL)
unnamed: R59.2, U20.23 (PWR_EN)
unnamed: C29.1, U20.12 (V3VD)
unnamed: C30.1, U20.20 (V5V)
unnamed: NT10.2, U20.22 (VBUS)
unnamed: NT9.2, U20.24 (VCC)
unnamed: R60.2, U20.9 (VSEL0)
unnamed: R58.2, U20.7 (VSEL1)
unnamed: R61.2, U20.11 (VSEL2)

Notes on the sheet:
5V 15W
Place D5 at edge of board.
GPIO4 Measured. PWM signal with peak 3.3V

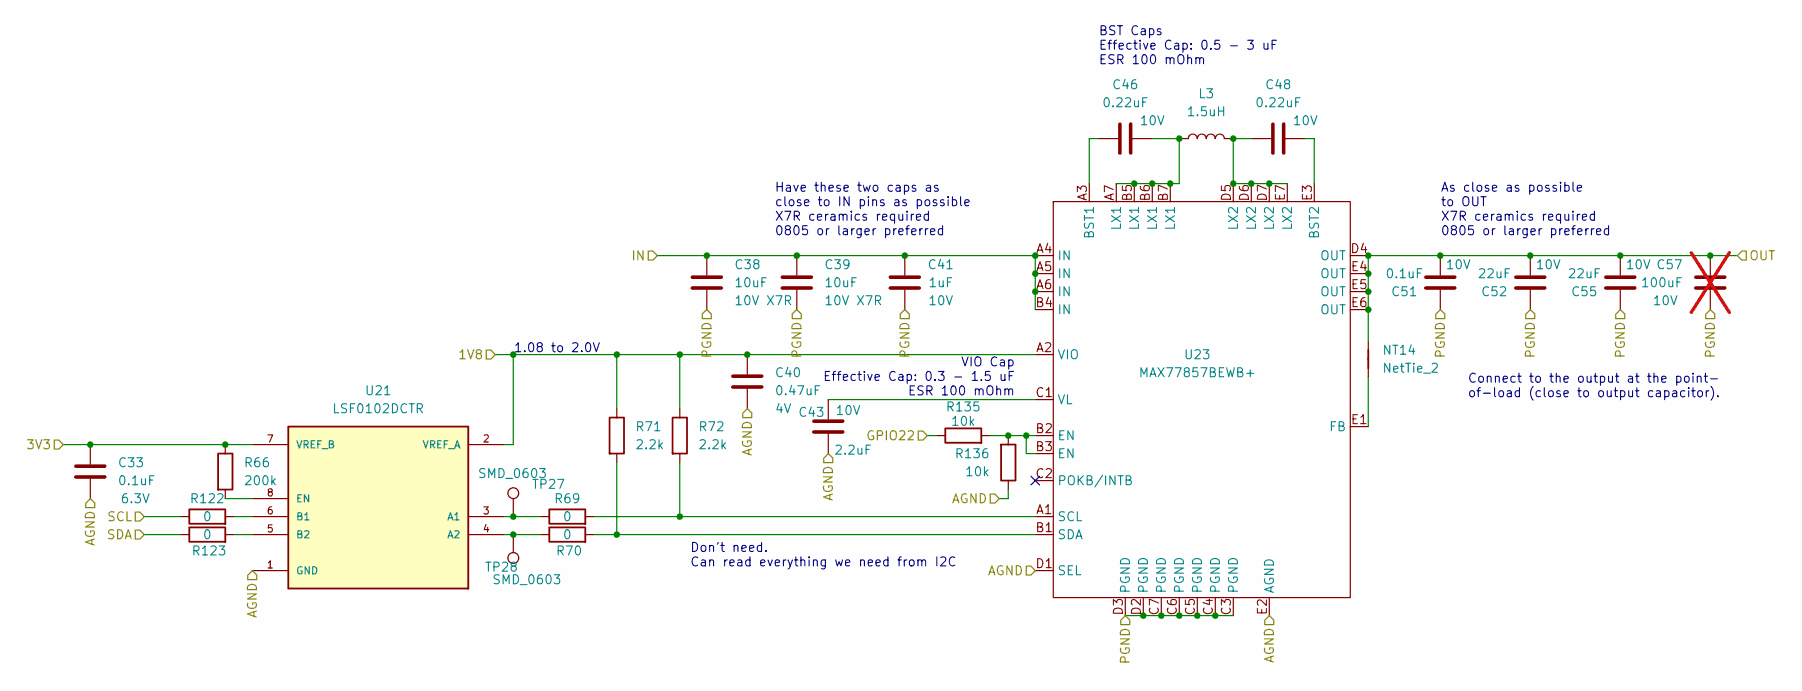
[picture p34: schematic boostRegulator.kicad_sch]

Parts:
C33, C51: 0.1uF; C_0402_1005Metric; Part Number CL05A104KA5NNNC
C38, C39: 10uF; C_0603_1608Metric; Part Number GRM188R61E106KA73J
C40: 0.47uF; C_0603_1608Metric; Part Number CL10B474KO8NNNC
C41: 1uF; C_0402_1005Metric; Part Number GRM155R61E105KA12D
C43: 2.2uF; C_0603_1608Metric; Part Number CL10A225KP8NNNC
C46, C48: 0.22uF; C_0603_1608Metric; Part Number CL10B224KA8NNNC
C52, C55: 22uF; C_0603_1608Metric; Part Number GRM188R61A226ME15D
C57: 100uF; C_1206_3216Metric; Part Number GRM31CD80J107MEA8K; not fitted
L3: 1.5uH; NRS6028T1R5NMGJ; Part Number NRS6028T1R5NMGJ
NT14: NetTie_2; NetTie-_SMD_Pad6mil; Part Number N/A
R66: 200k; R_0603_1608Metric; Part Number RMCF0603JT200K
R69, R70, R122, R123: 0; R_0603_1608Metric; Part Number RMCF0603ZT0R00
R71, R72: 2.2k; R_0603_1608Metric; Part Number RMCF0603JT2K20
R135, R136: 10k; R_0603_1608Metric; Part Number WR06X1002FTL
TP27, TP28: SMD_0603; TestPoint_SMD_0603; Part Number RCUCTE
U21: LSF0102DCTR; SOP65P400X130-8N; Part Number LSF0102DCTR
U23: MAX77857BEWB+; WLP-35_7x5_2.828x2.028mm; Part Number MAX77857BEWB+

Connections:
/BoostRegulator/1V8: C40.1, R71.1, R72.1, U21.2 (VREF_A), U23.A2 (VIO); also elsewhere on the board
/BoostRegulator/3V3: C33.1, R66.1, U21.7 (VREF_B); also elsewhere on the board
/BoostRegulator/IN: C38.1, C39.1, C41.2, U23.A4 (IN), U23.A5 (IN), U23.A6 (IN), U23.B4 (IN); also elsewhere on the board
/GPIO22: R135.1; also elsewhere on the board
/I2C0_SCL: R122.1; also elsewhere on the board
/I2C0_SDA: R123.1; also elsewhere on the board
/VBoost: C51.2, C52.2, C55.2, C57.1, NT14.1, U23.D4 (OUT), U23.E4 (OUT), U23.E5 (OUT), U23.E6 (OUT); also elsewhere on the board
GND: C33.2, C38.2, C39.2, C40.2, C41.1, C43.2, C51.1, C52.1, C55.1, C57.2, R136.1, U21.1 (GND), U23.C3 (PGND), U23.C4 (PGND), U23.C5 (PGND), U23.C6 (PGND), U23.C7 (PGND), U23.D1 (SEL), U23.D2 (PGND), U23.D3 (PGND), U23.E2 (AGND); also elsewhere on the board
unnamed: C46.2, L3.1, U23.A7 (LX1), U23.B5 (LX1), U23.B6 (LX1), U23.B7 (LX1)
unnamed: C48.1, L3.2, U23.D5 (LX2), U23.D6 (LX2), U23.D7 (LX2), U23.E7 (LX2)
unnamed: R135.2, R136.2, U23.B2 (EN), U23.B3 (EN)
unnamed: R69.1, TP27.1, U21.3 (A1)
unnamed: R70.1, TP28.1, U21.4 (A2)
unnamed: R122.2, U21.6 (B1)
unnamed: R123.2, U21.5 (B2)
unnamed: R66.2, U21.8 (EN)
unnamed: C46.1, U23.A3 (BST1)
unnamed: C48.2, U23.E3 (BST2)
unnamed: NT14.2, U23.E1 (FB)
unnamed: R69.2, R72.2, U23.A1 (SCL)
unnamed: R70.2, R71.2, U23.B1 (SDA)
unnamed: C43.1, U23.C1 (VL)

Notes on the sheet:
Have these two caps as close to IN pins as possible X7R ceramics required 0805 or larger preferred
Connect to the output at the point- of-load (close to output capacitor).
Don't need. Can read everything we need from I2C
BST Caps Effective Cap: 0.5 - 3 uF ESR 100 mOhm
1.08 to 2.0V
As close as possible to OUT X7R ceramics required 0805 or larger preferred
VIO Cap Effective Cap: 0.3 - 1.5 uF ESR 100 mOhm

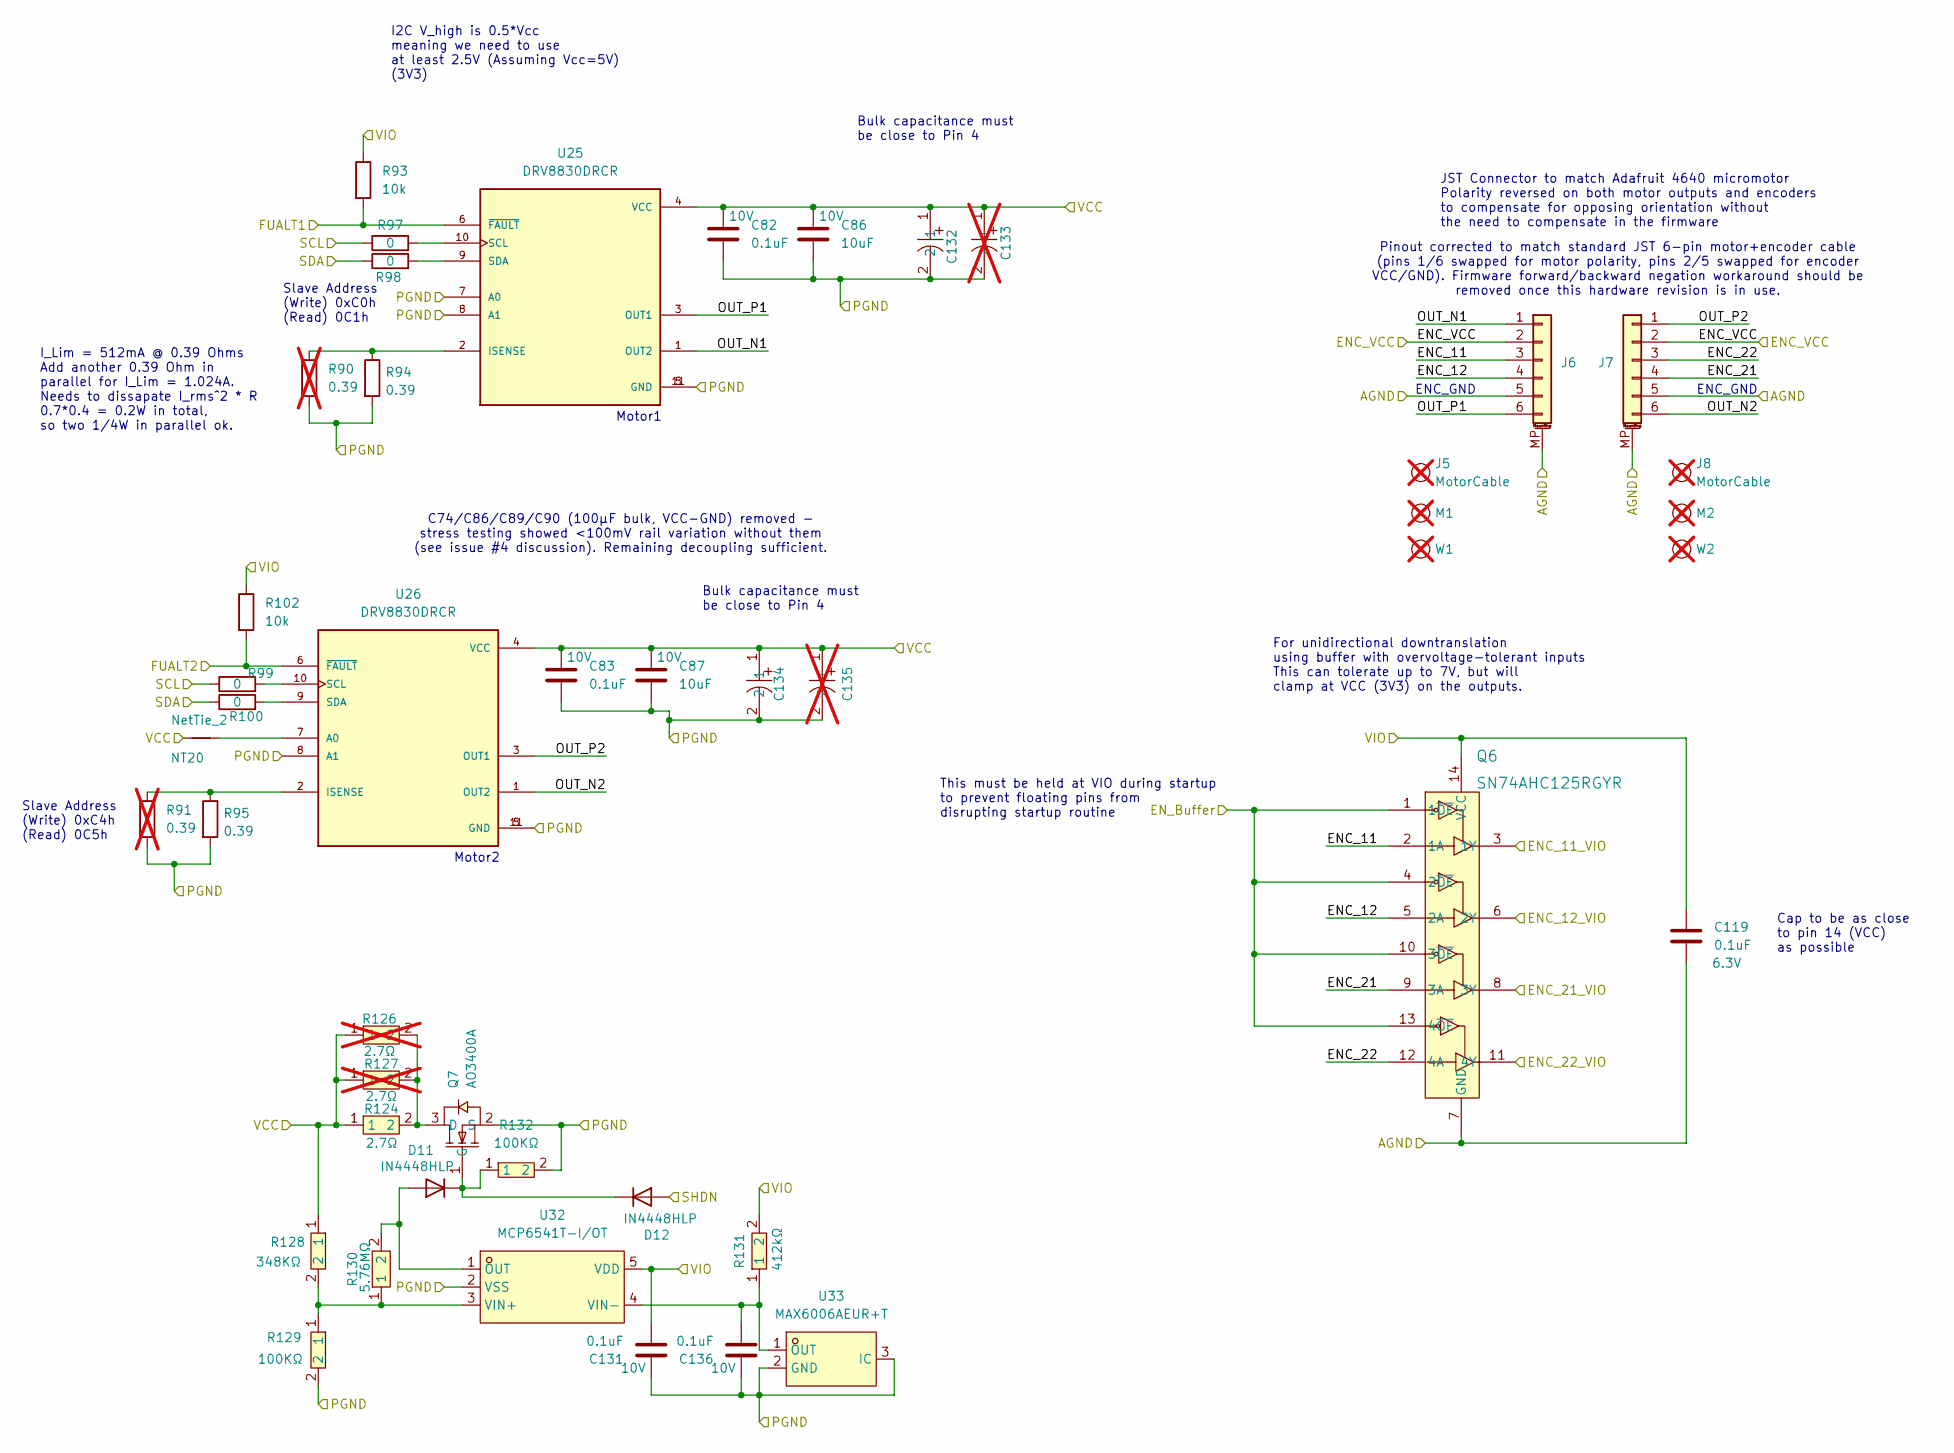
[picture p35: schematic motors.kicad_sch]

Parts:
C82, C83, C119, C131, C136: 0.1uF; C_0402_1005Metric; Part Number CL05A104KA5NNNC
C86, C87: 10uF; C_0603_1608Metric; Part Number GRM188R61E106KA73J
C132: APXK160ARA101MF611; CAP-SMD_BD6.3-L6.6-W6.6-FD; MPN APXK160ARA101MF611; LCSC Part C2162384
C133: APXK160ARA101MF611; CAP-SMD_BD6.3-L6.6-W6.6-FD; MPN APXK160ARA101MF611; LCSC Part C2162384; not fitted
C134: APXK160ARA101MF611; CAP-SMD_BD6.3-L6.6-W6.6-FD; Part Number APXK160ARA101MF611; LCSC Part C2162384
C135: APXK160ARA101MF611; CAP-SMD_BD6.3-L6.6-W6.6-FD; Part Number APXK160ARA101MF611; LCSC Part C2162384; not fitted
D11, D12: IN4448HLP; D_0402_1005Metric; Part Number 1N4448HLP-7
J5, J8: MotorCable; Part Number A06ZR06ZR28H51B; not fitted
J6, J7: Conn_01x06_MountingPin; CONN_B6B-ZR-SM4-TF_JST; Part Number B6B-ZR-SM4-TF
M1, M2: Part Number 4639; not fitted
NT20: NetTie_2; NetTie-_SMD_Pad6mil; Part Number N/A
Q6: SN74AHC125RGYR; Part Number SN74AHC125RGYR
Q7: AO3400A; SOT-23-3_L2.9-W1.3-P1.90-LS2.4-BR; Part Number AO3400A; LCSC Part C20917
R90, R91: 0.39; R_0603_1608Metric; Part Number ERJ-3RQJR39V; not fitted
R93, R102: 10k; R_0603_1608Metric; Part Number WR06X1002FTL
R94, R95: 0.39; R_0603_1608Metric; Part Number ERJ-3RQJR39V
R97, R98, R99, R100: 0; R_0603_1608Metric; Part Number RMCF0603ZT0R00
R124: 2.7Ω; R2512; Part Number FRC2512F2R70TS; LCSC Part C2999529
R126, R127: 2.7Ω; R2512; Part Number FRC2512F2R70TS; LCSC Part C2999529; not fitted
R128: 348KΩ; R0603; Part Number 0603WAF3483T5E; LCSC Part C23006
R129, R132: 100KΩ; R0603; Part Number 0603WAF1003T5E; LCSC Part C25803
R130: 5.76MΩ; R0603; Part Number 0603WAF5904T5E; LCSC Part C422915
R131: 412kΩ; R0402; Part Number 0402WGF4123TCE; LCSC Part C27008
U25, U26: DRV8830DRCR; IC_DRV8830DRCR; Part Number DRV8830DRCR
U32: MCP6541T-I/OT; SOT-23-5_L3.0-W1.7-P0.95-LS2.8-BR; Part Number MCP6541T-I/OT; LCSC Part C80839
U33: MAX6006AEUR+T; SOT-23-3_L2.9-W1.3-P0.95-LS2.4-BR; Part Number MAX6006AEUR+T; LCSC Part C2830546
W1, W2: Part Number 4939; not fitted

Connections:
/GPIO8: Q6.1 (1~OE), Q6.4 (2~OE), Q6.10 (3~OE), Q6.13 (4~OE); also elsewhere on the board
/GPIO10: R93.2, U25.6 (~FAULT); also elsewhere on the board
/GPIO11: R102.2, U26.6 (~FAULT); also elsewhere on the board
/GPIO12: Q6.3 (1Y); also elsewhere on the board
/GPIO13: Q6.6 (2Y); also elsewhere on the board
/GPIO14: Q6.8 (3Y); also elsewhere on the board
/GPIO15: Q6.11 (4Y); also elsewhere on the board
/I2C0_SCL: R97.1, R99.1; also elsewhere on the board
/I2C0_SDA: R98.1, R100.1; also elsewhere on the board
/MOTORS/ENC_11: J6.3, Q6.2 (1A)
/MOTORS/ENC_12: J6.4, Q6.5 (2A)
/MOTORS/ENC_21: J7.4, Q6.9 (3A)
/MOTORS/ENC_22: J7.3, Q6.12 (4A)
/MOTORS/ENC_VCC: J6.2, J7.2; also elsewhere on the board
/MOTORS/OUT_N1: J6.1, U25.1 (OUT2)
/MOTORS/OUT_N2: J7.6, U26.1 (OUT2)
/MOTORS/OUT_P1: J6.6, U25.3 (OUT1)
/MOTORS/OUT_P2: J7.1, U26.3 (OUT1)
/MOTORS/VCC: C82.1, C83.1, C86.1, C87.1, C132.1, C133.1, C134.1, C135.1, NT20.2, R124.1, R126.1, R127.1, R128.1, U25.4 (VCC), U26.4 (VCC); also elsewhere on the board
/MOTORS/VIO: C119.1, C131.2, Q6.14 (VCC), R93.1, R102.1, R131.2, U32.5 (VDD); also elsewhere on the board
/SHDN: D12.2 (A); also elsewhere on the board
GND: C82.2, C83.2, C86.2, C87.2, C119.2, C131.1, C132.2, C133.2, C134.2, C135.2, C136.1, J6.5, J6.MP (MountPin), J7.5, J7.MP (MountPin), Q6.7 (GND), Q6.PAD (GND), Q7.2 (S), R90.2, R91.2, R94.2, R95.2, R129.2, R132.2, U25.5 (GND), U25.7 (A0), U25.8 (A1), U25.11 (GND), U26.5 (GND), U26.8 (A1), U26.11 (GND), U32.2 (VSS), U33.2 (GND), U33.3 (IC); also elsewhere on the board
unnamed: D11.2 (A), R130.2, U32.1 (OUT)
unnamed: D11.1 (K), D12.1 (K), Q7.1 (G), R132.1
unnamed: Q7.3 (D), R124.2, R126.2, R127.2
unnamed: R90.1, R94.1, U25.2 (ISENSE)
unnamed: R97.2, U25.10 (SCL)
unnamed: R98.2, U25.9 (SDA)
unnamed: NT20.1, U26.7 (A0)
unnamed: R91.1, R95.1, U26.2 (ISENSE)
unnamed: R99.2, U26.10 (SCL)
unnamed: R100.2, U26.9 (SDA)
unnamed: R128.2, R129.1, R130.1, U32.3 (VIN+)
unnamed: C136.2, R131.1, U32.4 (VIN-), U33.1 (OUT)

Notes on the sheet:
Motor1
Bulk capacitance must be close to Pin 4
Motor2
Slave Address (Write) 0xC0h (Read) 0C1h
ENC_GND
For unidirectional downtranslation using buffer with overvoltage-tolerant inputs This can tolerate up to 7V, but will clamp at VCC (3V3) on the outputs.
This must be held at VIO during startup to prevent floating pins from disrupting startup routine
C74/C86/C89/C90 (100µF bulk, VCC-GND) removed - stress testing showed <100mV rail variation without them (see issue #4 discussion). Remaining decoupling sufficient.
I2C V_high is 0.5*Vcc meaning we need to use at least 2.5V (Assuming Vcc=5V) (3V3)
JST Connector to match Adafruit 4640 micromotor Polarity reversed on both motor outputs and encoders to compensate for opposing orientation without the need to compensate in the firmware
Cap to be as close to pin 14 (VCC) as possible
Pinout corrected to match standard JST 6-pin motor+encoder cable (pins 1/6 swapped for motor polarity, pins 2/5 swapped for encoder VCC/GND). Firmware forward/backward negation workaround should be removed once this hardware revision is in use.
I_Lim = 512mA @ 0.39 Ohms Add another 0.39 Ohm in parallel for I_Lim = 1.024A. Needs to dissapate I_rms^2 * R 0.7*0.4 = 0.2W in total, so two 1/4W in parallel ok.
Slave Address (Write) 0xC4h (Read) 0C5h
