tekkura/sr-cad/pcb/robot/robot.kicad_pcb

## KiCad design pcb/robot/robot.kicad_pcb (continued)

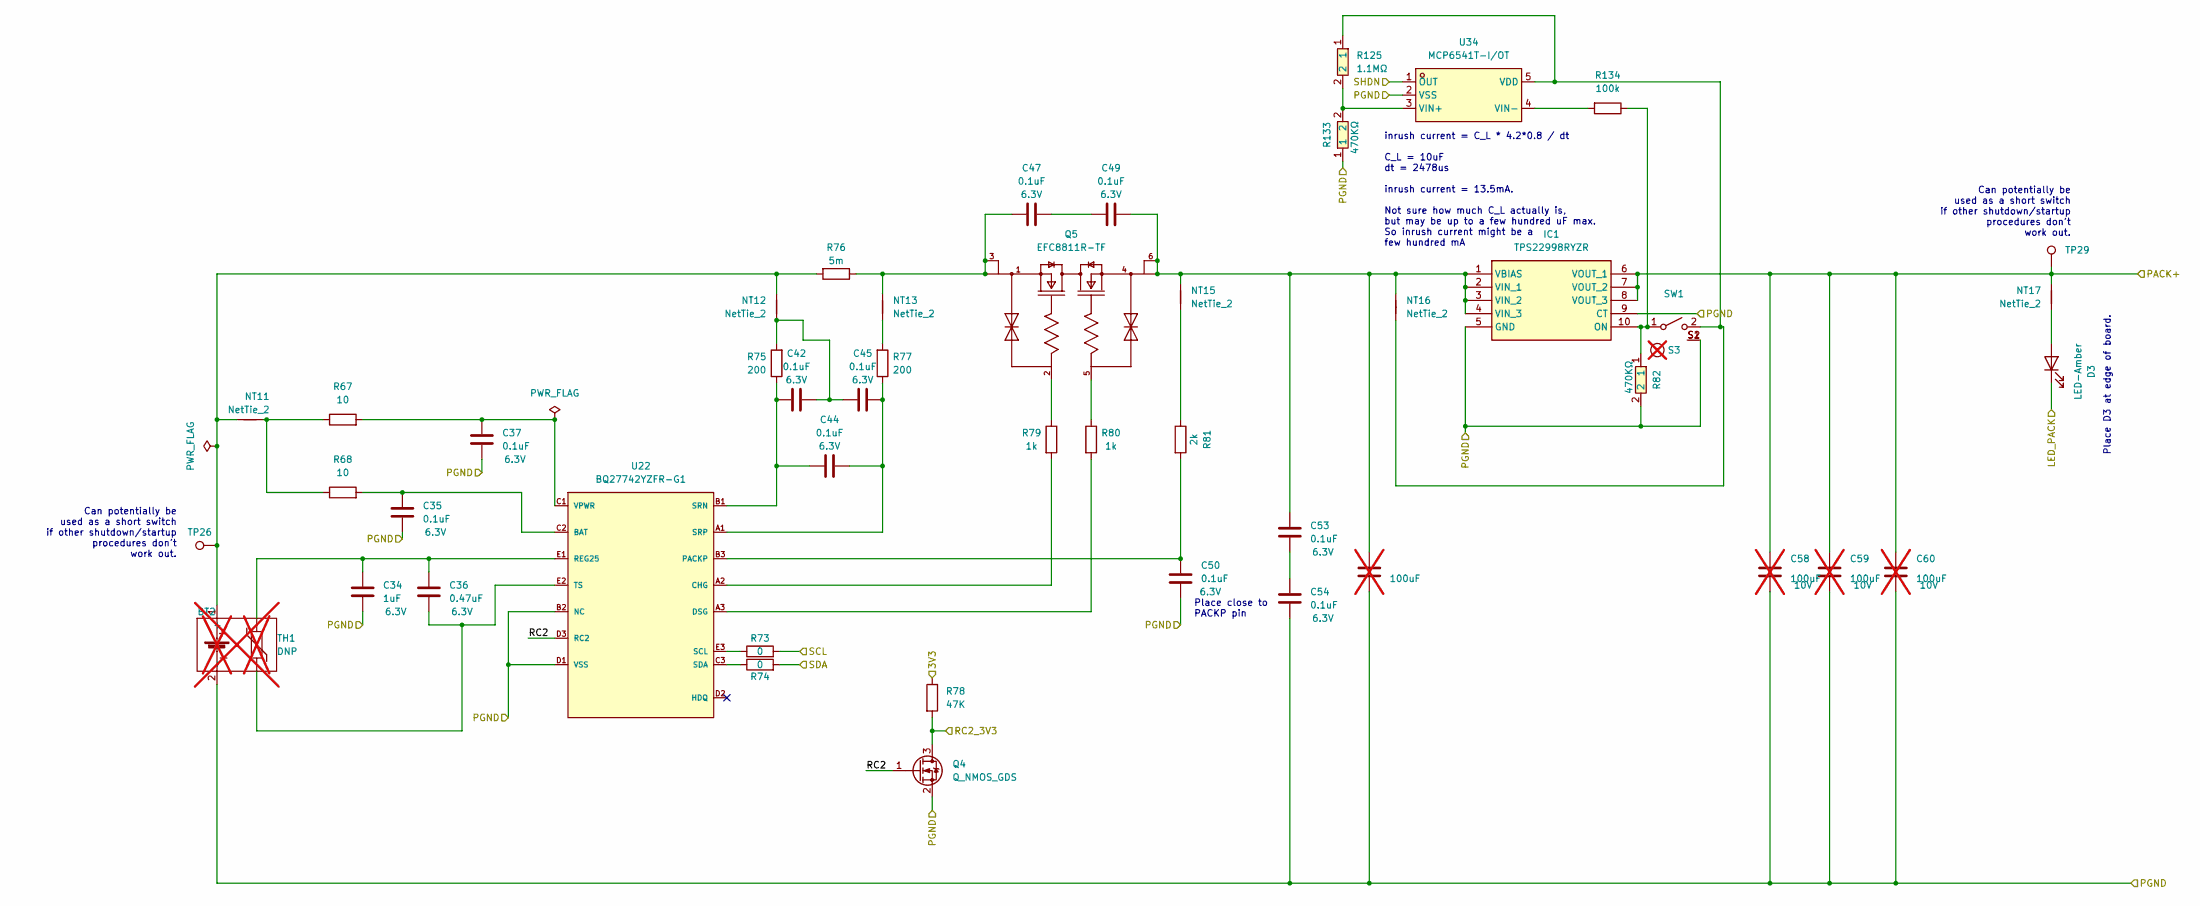
[picture p36: schematic Protection.kicad_sch]

Parts:
BT1: DNP; battery26650; Part Number 26650-5000-1; not fitted
BT2: DNP; battery26650_holderOnly; Part Number a15042300ux0145; not fitted
C34: 1uF; C_0402_1005Metric; Part Number GRM155R61E105KA12D
C35, C37, C42, C44, C45, C47, C49, C50, C53, C54: 0.1uF; C_0402_1005Metric; Part Number CL05A104KA5NNNC
C36: 0.47uF; C_0603_1608Metric; Part Number CL10B474KO8NNNC
C56, C58, C59, C60: 100uF; C_1206_3216Metric; Part Number GRM31CD80J107MEA8K; not fitted
D3: LED-Amber; B12H1UYG-20D000134U1930; Part Number B12H1UY--20D000134U1930
IC1: TPS22998RYZR; Part Number TPS22998RYZR
NT11, NT12, NT13, NT15, NT16, NT17: NetTie_2; NetTie-_SMD_Pad6mil; Part Number N/A
Q4: Q_NMOS_GDS; SOT-23; Part Number BSS138
Q5: EFC8811R-TF; ON_Semiconductor-568AL-10_2013-O-MFG; Part Number EFC8811R-TF
R67, R68: 10; R_0402_1005Metric; Part Number RC0402FR-1310RL
R73, R74: 0; R_0603_1608Metric; Part Number RMCF0603ZT0R00
R75, R77: 200; R_0603_1608Metric; Part Number ERJ-PA3J201V
R76: 5m; R_0805_2012Metric; Part Number PA0805FRF470R005L
R78: 47K; R_0603_1608Metric; Part Number RMCF0603JT47K0
R79, R80: 1k; R_0402_1005Metric; Part Number WR04X102 JTL
R81: 2k; R_0603_1608Metric; Part Number RMCF0603FT2K00
R82, R133: 0402WGJ0474TCE; R0402; MPN 0402WGJ0474TCE; LCSC Part C25562
R125: 1.1MΩ; R0402; Part Number 0402WGF1104TCE; LCSC Part C133039
R134: 100k; R_0402_1005Metric; Part Number 0402WGF1003TCE
S3: Part Number SW-R3-1A-A-1-2; not fitted
SW1: SW_SPST; MOLEX_picoblade_SMT_2pin; Part Number 0533980271
TH1: DNP; battery26650_thermistor; Part Number 103AT-5-1P-FT; not fitted
TP26, TP29: TestPoint; THT_JumperLead; Part Number N/A
U22: BQ27742YZFR-G1; Texas_Instruments-YZF0015-0-0-MFG; Part Number BQ27742YZFR-G1
U34: MCP6541T-I/OT; SOT-23-5_L3.0-W1.7-P0.95-LS2.8-BR; Part Number MCP6541T-I/OT; LCSC Part C80839

Connections:
/3V3: R78.1; also elsewhere on the board
/GPIO20: Q4.3 (D), R78.2; also elsewhere on the board
/I2C0_SCL: R73.2; also elsewhere on the board
/I2C0_SDA: R74.2; also elsewhere on the board
/LED_PACK: D3.1 (K); also elsewhere on the board
/Protection/PACK+: C58.1, C59.1, C60.1, IC1.6 (VOUT_1), IC1.7 (VOUT_2), IC1.8 (VOUT_3), NT17.1, TP29.1; also elsewhere on the board
/Protection/RC2: Q4.1 (G), U22.D3 (RC2)
/SHDN: U34.1 (OUT); also elsewhere on the board
GND: BT2.2 (-), C34.2, C35.2, C37.2, C50.2, C54.2, C56.2, C58.2, C59.2, C60.2, IC1.5 (GND), IC1.9 (CT), Q4.2 (S), R82.2, R133.1, SW1.S1, SW1.S2, U22.B2 (NC), U22.D1 (VSS), U34.2 (VSS); also elsewhere on the board
unnamed: BT2.1 (+), NT11.2, NT12.1, R76.2, TP26.1
unnamed: C42.2, C45.1, NT12.2, R75.2
unnamed: C47.1, NT13.1, Q5.1 (SOURCE1), Q5.3 (SOURCE1), R76.1
unnamed: C47.2, C49.1
unnamed: C53.2, C54.1
unnamed: D3.2 (A), NT17.2
unnamed: IC1.10 (ON), R82.1, R134.1, SW1.1 (A)
unnamed: C49.2, C53.1, C56.1, IC1.1 (VBIAS), IC1.2 (VIN_1), IC1.3 (VIN_2), IC1.4 (VIN_3), NT15.1, NT16.1, Q5.4 (SOURCE2), Q5.6 (SOURCE2)
unnamed: NT11.1, R67.1, R68.1
unnamed: NT13.2, R77.2
unnamed: NT15.2, R81.1
unnamed: Q5.2 (GATE1), R79.1
unnamed: Q5.5 (GATE2), R80.1
unnamed: NT16.2, R125.1, SW1.2 (B), U34.5 (VDD)
unnamed: C35.1, R68.2, U22.C2 (BAT)
unnamed: R79.2, U22.A2 (CHG)
unnamed: R80.2, U22.A3 (DSG)
unnamed: C50.1, R81.2, U22.B3 (PACKP)
unnamed: C34.1, C36.1, TH1.1, U22.E1 (REG25)
unnamed: R73.1, U22.E3 (SCL)
unnamed: R74.1, U22.C3 (SDA)
unnamed: C42.1, C44.1, R75.1, U22.B1 (SRN)
unnamed: C44.2, C45.2, R77.1, U22.A1 (SRP)
unnamed: C36.2, TH1.2, U22.E2 (TS)
unnamed: C37.1, R67.2, U22.C1 (VPWR)
unnamed: R125.2, R133.2, U34.3 (VIN+)
unnamed: R134.2, U34.4 (VIN-)

Notes on the sheet:
Can potentially be used as a short switch if other shutdown/startup procedures don't work out.
inrush current = C_L * 4.2*0.8 / dt C_L = 10uF dt = 2478us inrush current = 13.5mA. Not sure how much C_L actually is, but may be up to a few hundred uF max. So inrush current might be a few hundred mA
Place D3 at edge of board.
Place close to PACKP pin

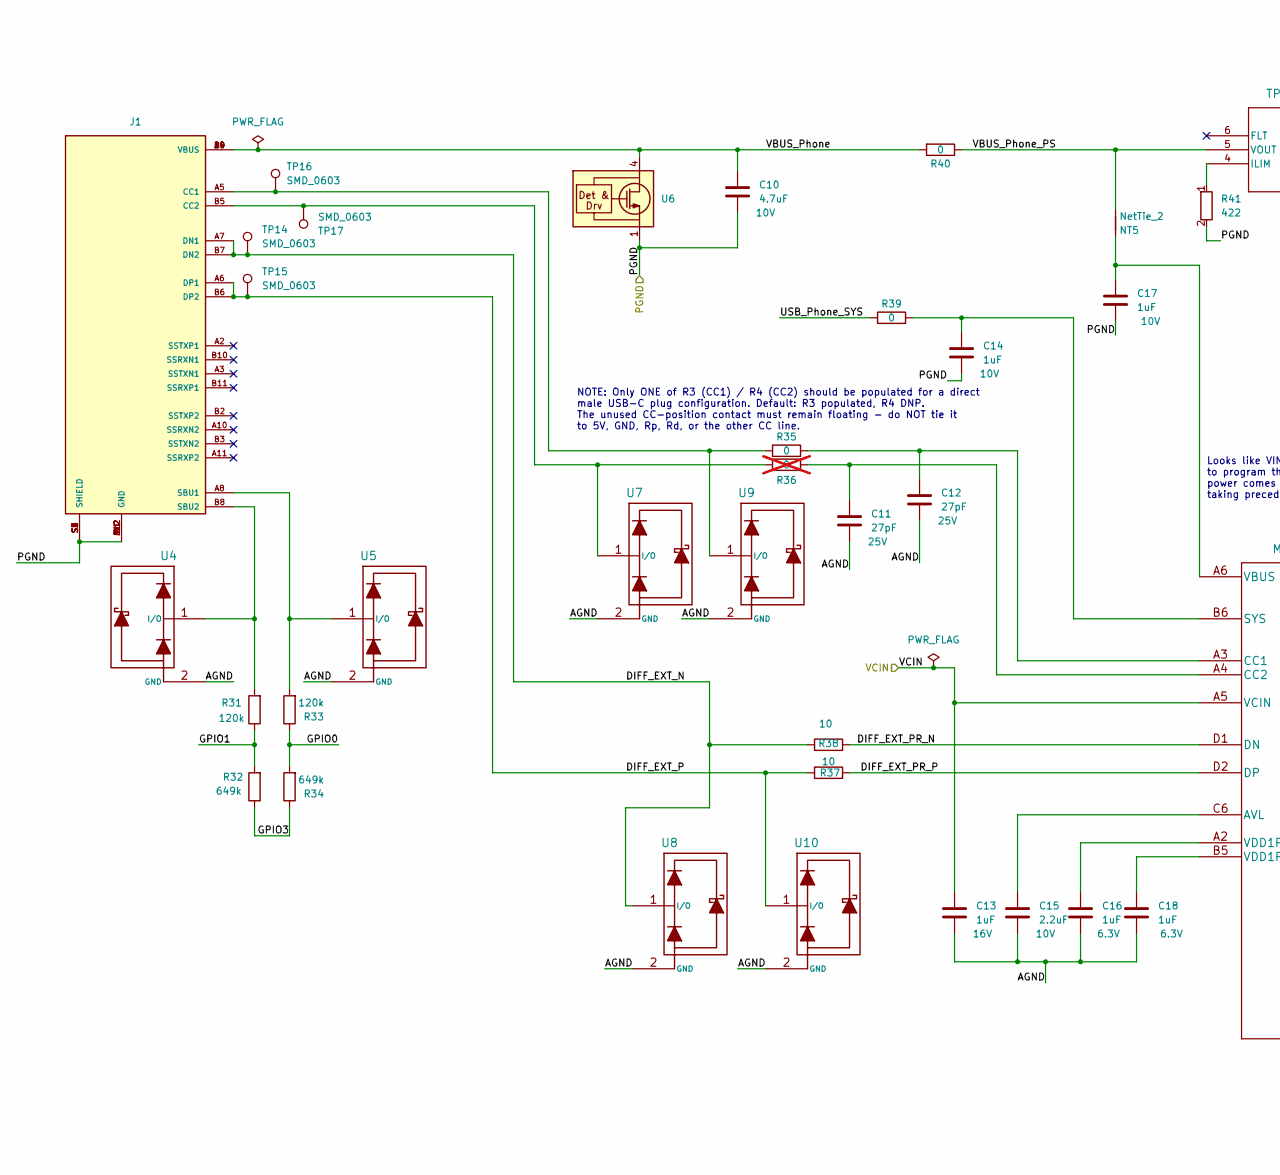
[picture p37: schematic USB-PD-PhonePC.kicad_sch, part in row 1, column 1]

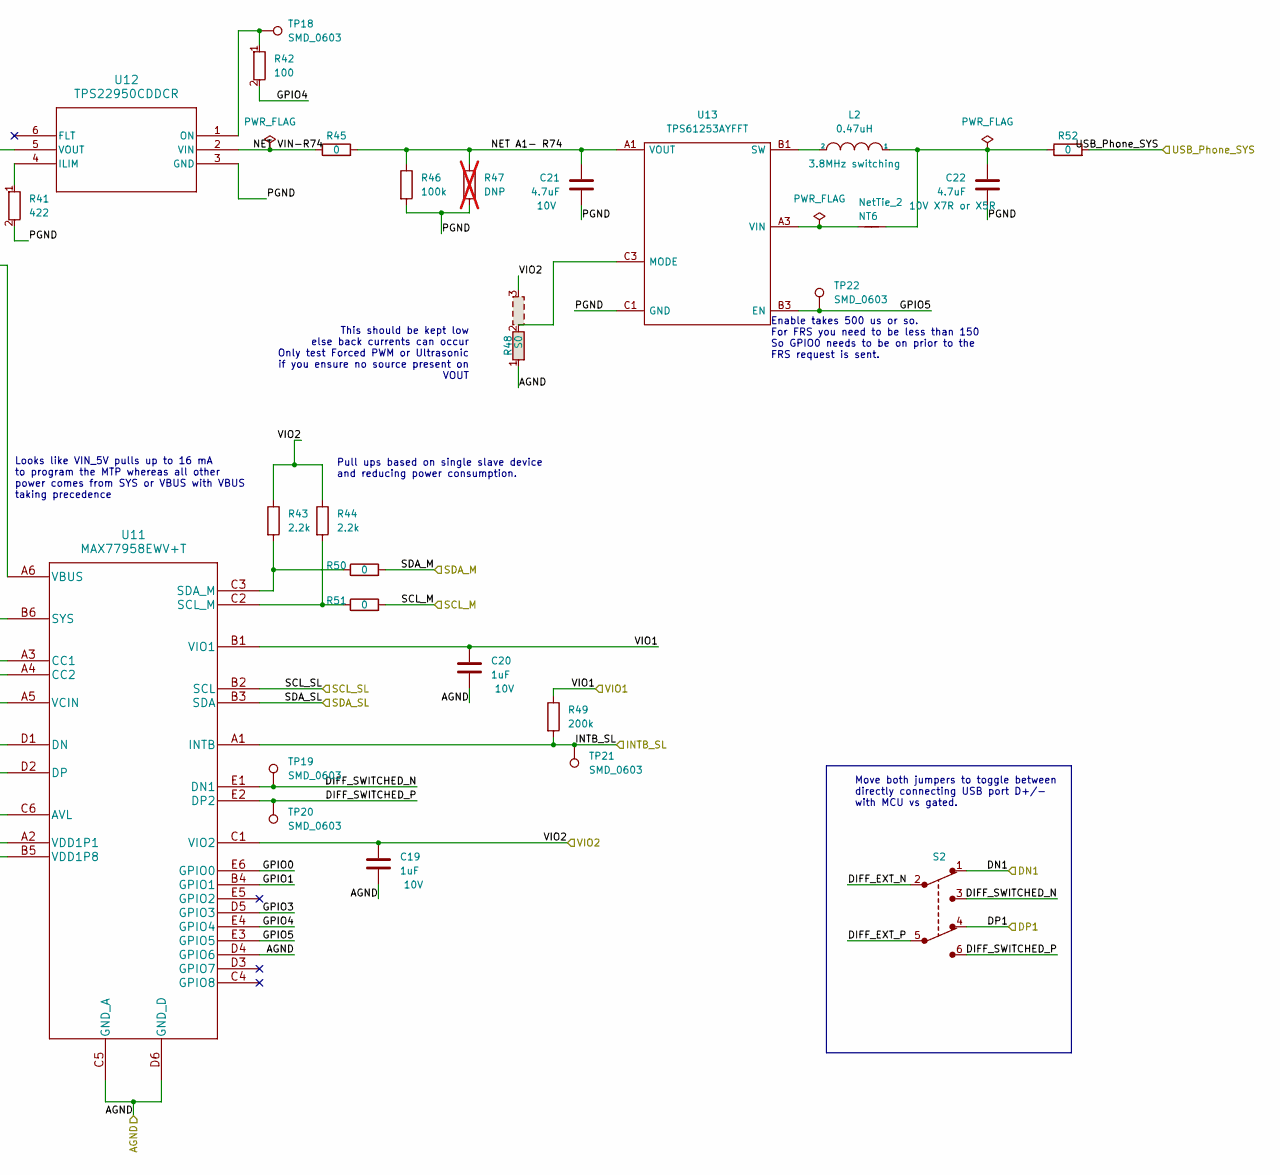
[picture p38: schematic USB-PD-PhonePC.kicad_sch, part in row 1, column 2]

Parts:
C10, C21, C22: 4.7uF; C_0603_1608Metric; Part Number GRM188R61E475KE11D
C11, C12: 27pF; C_0402_1005Metric; Part Number GRM1555C1H270JA01J
C13, C14, C16, C17, C18, C19, C20: 1uF; C_0402_1005Metric; Part Number GRM155R61E105KA12D
C15: 2.2uF; C_0603_1608Metric; Part Number CL10A225KP8NNNC
J1: USB4151-GF-C; GCT_USB4151-GF-C_REVA; Part Number USB4151-GF-C
L2: 0.47uH; Vishay-IHLP-2020BZ-FP_1.905x2.79-3D_2.0-0-0-MFG; Part Number IHLP2020BZERR47M01
NT5, NT6: NetTie_2; NetTie-_SMD_Pad6mil; Part Number N/A
R31, R33: 120k; R_0603_1608Metric; Part Number RMCF0603JT120K
R32, R34: 649k; R_0603_1608Metric; Part Number ERJ-3EKF6493V
R35, R39, R50, R51, R52: 0; R_0603_1608Metric; Part Number RMCF0603ZT0R00
R36: 0; R_0603_1608Metric; Part Number RMCF0603ZT0R00; not fitted
R37, R38: 10; R_0402_1005Metric; Part Number RC0402FR-1310RL
R40, R45: 0; R_0805_2012Metric; Part Number RMCF0805ZT0R00
R41: 422; R_0402_1005Metric; Part Number RC0402FR-07422RL; DigiKey_Part_Number YAG3158CT-ND
R42: 100; R_0402_1005Metric; Part Number RC0402FR-07100RL; DigiKey_Part_Number 311-100LRCT-ND
R43, R44: 2.2k; R_0603_1608Metric; Part Number RMCF0603JT2K20
R46: 100k; R_0603_1608Metric; Part Number WR06X1003FTL
R47: DNP; R_0603_1608Metric; Part Number DNP; not fitted
R48: S0; R_0603_1608Metric_3pin_Switch; Part Number RMCF0603ZT0R00
R49: 200k; R_0603_1608Metric; Part Number RMCF0603JT200K
S2: JS202011JCQN; SW_JS202011JCQN; Part Number JS202011JCQN
TP14, TP15, TP16, TP17, TP18, TP19, TP20, TP21, TP22: SMD_0603; TestPoint_SMD_0603; Part Number RCUCTE
U4, U5, U7, U8, U9, U10: TPD1E05U06; TPD1E05U06DPYR; Part Number TPD1E05U06DPYR
U6: TVS0500DRV; TVS0500DRVR; Part Number TVS0500DRVR
U11: MAX77958EWV+T; MAX77958EWV&plus_T; Part Number MAX77958EWV+T
U12: TPS22950CDDCR; DDC6_TEX; Part Number TPS22950CDDCR
U13: TPS61253AYFFT; Texas_Instruments-YFF0009-BGA9C40P3X3_119X129X62; Part Number TPS61253AYFFT

Connections:
/DN1: S2.1; also elsewhere on the board
/DP1: S2.4; also elsewhere on the board
/GPIO7: R49.2, TP21.1, U11.A1 (INTB); also elsewhere on the board
/I2C1_SCL: R51.2; also elsewhere on the board
/I2C1_SDA: R50.2; also elsewhere on the board
/SCL_SL: U11.B2 (SCL); also elsewhere on the board
/SDA_SL: U11.B3 (SDA); also elsewhere on the board
/USB-PD-PhonePC/DIFF_EXT_N: J1.A7 (DN1), J1.B7 (DN2), R38.1, S2.2, TP14.1, U8.1 (I/O)
/USB-PD-PhonePC/DIFF_EXT_P: J1.A6 (DP1), J1.B6 (DP2), R37.1, S2.5, TP15.1, U10.1 (I/O)
/USB-PD-PhonePC/DIFF_EXT_PR_N: R38.2, U11.D1 (DN)
/USB-PD-PhonePC/DIFF_EXT_PR_P: R37.2, U11.D2 (DP)
/USB-PD-PhonePC/DIFF_SWITCHED_N: S2.3, TP19.1, U11.E1 (DN1)
/USB-PD-PhonePC/DIFF_SWITCHED_P: S2.6, TP20.1, U11.E2 (DP2)
/USB-PD-PhonePC/GPIO0: R33.1, R34.2, U11.E6 (GPIO0)
/USB-PD-PhonePC/GPIO1: R31.1, R32.2, U11.B4 (GPIO1)
/USB-PD-PhonePC/GPIO3: R32.1, R34.1, U11.D5 (GPIO3)
/USB-PD-PhonePC/GPIO4: R42.2, U11.E4 (GPIO4)
/USB-PD-PhonePC/GPIO5: TP22.1, U11.E3 (GPIO5), U13.B3 (EN)
/USB-PD-PhonePC/NET A1- R74: C21.1, R45.2, R46.1, R47.1, U13.A1 (VOUT), U13.A2 (VOUT)
/USB-PD-PhonePC/NET VIN-R74: R45.1, U12.2 (VIN)
/USB-PD-PhonePC/USB_Phone_SYS: R39.1, R52.2; also elsewhere on the board
/USB-PD-PhonePC/VBUS_Phone: C10.1, J1.A4 (VBUS), J1.A9 (VBUS), J1.B4 (VBUS), J1.B9 (VBUS), R40.2, U6.4 (IN), U6.5 (IN), U6.6 (IN)
/USB-PD-PhonePC/VBUS_Phone_PS: NT5.2, R40.1, U12.5 (VOUT)
/USB-PD-PhonePC/VCIN: C13.1, U11.A5 (VCIN); also elsewhere on the board
/USB-PD-PhonePC/VIO1: C20.1, R49.1, U11.B1 (VIO1); also elsewhere on the board
/USB-PD-PhonePC/VIO2: C19.1, R43.1, R44.1, R48.3, U11.C1 (VIO2); also elsewhere on the board
GND: C10.2, C11.2, C12.2, C13.2, C14.2, C15.2, C16.2, C17.2, C18.2, C19.2, C20.2, C21.2, C22.2, J1.A1 (GND), J1.A12 (GND), J1.B1 (GND), J1.B12 (GND), J1.S1 (SHIELD), J1.S2 (SHIELD), J1.S3 (SHIELD), J1.S4 (SHIELD), J1.S5 (SHIELD), R41.2, R46.2, R47.2, R48.1, U4.2 (GND), U5.2 (GND), U6.1 (GND), U6.2 (GND), U6.3 (GND), U6.7 (GND), U7.2 (GND), U8.2 (GND), U9.2 (GND), U10.2 (GND), U11.C5 (GND_A), U11.D4 (GPIO6), U11.D6 (GND_D), U12.3 (GND), U13.C1 (GND), U13.C2 (GND); also elsewhere on the board
unnamed: C22.1, L2.1, NT6.2, R52.1
unnamed: J1.A5 (CC1), R35.1, TP16.1, U9.1 (I/O)
unnamed: J1.B5 (CC2), R36.1, TP17.1, U7.1 (I/O)
unnamed: J1.A8 (SBU1), R33.2, U5.1 (I/O)
unnamed: J1.B8 (SBU2), R31.2, U4.1 (I/O)
unnamed: L2.2, U13.B1 (SW), U13.B2 (SW)
unnamed: C15.1, U11.C6 (AVL)
unnamed: C12.1, R35.2, U11.A3 (CC1)
unnamed: C11.1, R36.2, U11.A4 (CC2)
unnamed: R44.2, R51.1, U11.C2 (SCL_M)
unnamed: R43.2, R50.1, U11.C3 (SDA_M)
unnamed: C14.1, R39.2, U11.B6 (SYS)
unnamed: C17.1, NT5.1, U11.A6 (VBUS)
unnamed: C16.1, U11.A2 (VDD1P1)
unnamed: C18.1, U11.B5 (VDD1P8)
unnamed: R41.1, U12.4 (ILIM)
unnamed: R42.1, TP18.1, U12.1 (ON)
unnamed: R48.2, U13.C3 (MODE)
unnamed: NT6.1, U13.A3 (VIN)

Notes on the sheet:
Pull ups based on single slave device and reducing power consumption.
Looks like VIN_5V pulls up to 16 mA to program the MTP whereas all other power comes from SYS or VBUS with VBUS taking precedence
This should be kept low else back currents can occur Only test Forced PWM or Ultrasonic if you ensure no source present on VOUT
Move both jumpers to toggle between directly connecting USB port D+/- with MCU vs gated.
NOTE: Only ONE of R3 (CC1) / R4 (CC2) should be populated for a direct male USB-C plug configuration. Default: R3 populated, R4 DNP. The unused CC-position contact must remain floating - do NOT tie it to 5V, GND, Rp, Rd, or the other CC line.
Enable takes 500 us or so. For FRS you need to be less than 150 So GPIO0 needs to be on prior to the FRS request is sent.

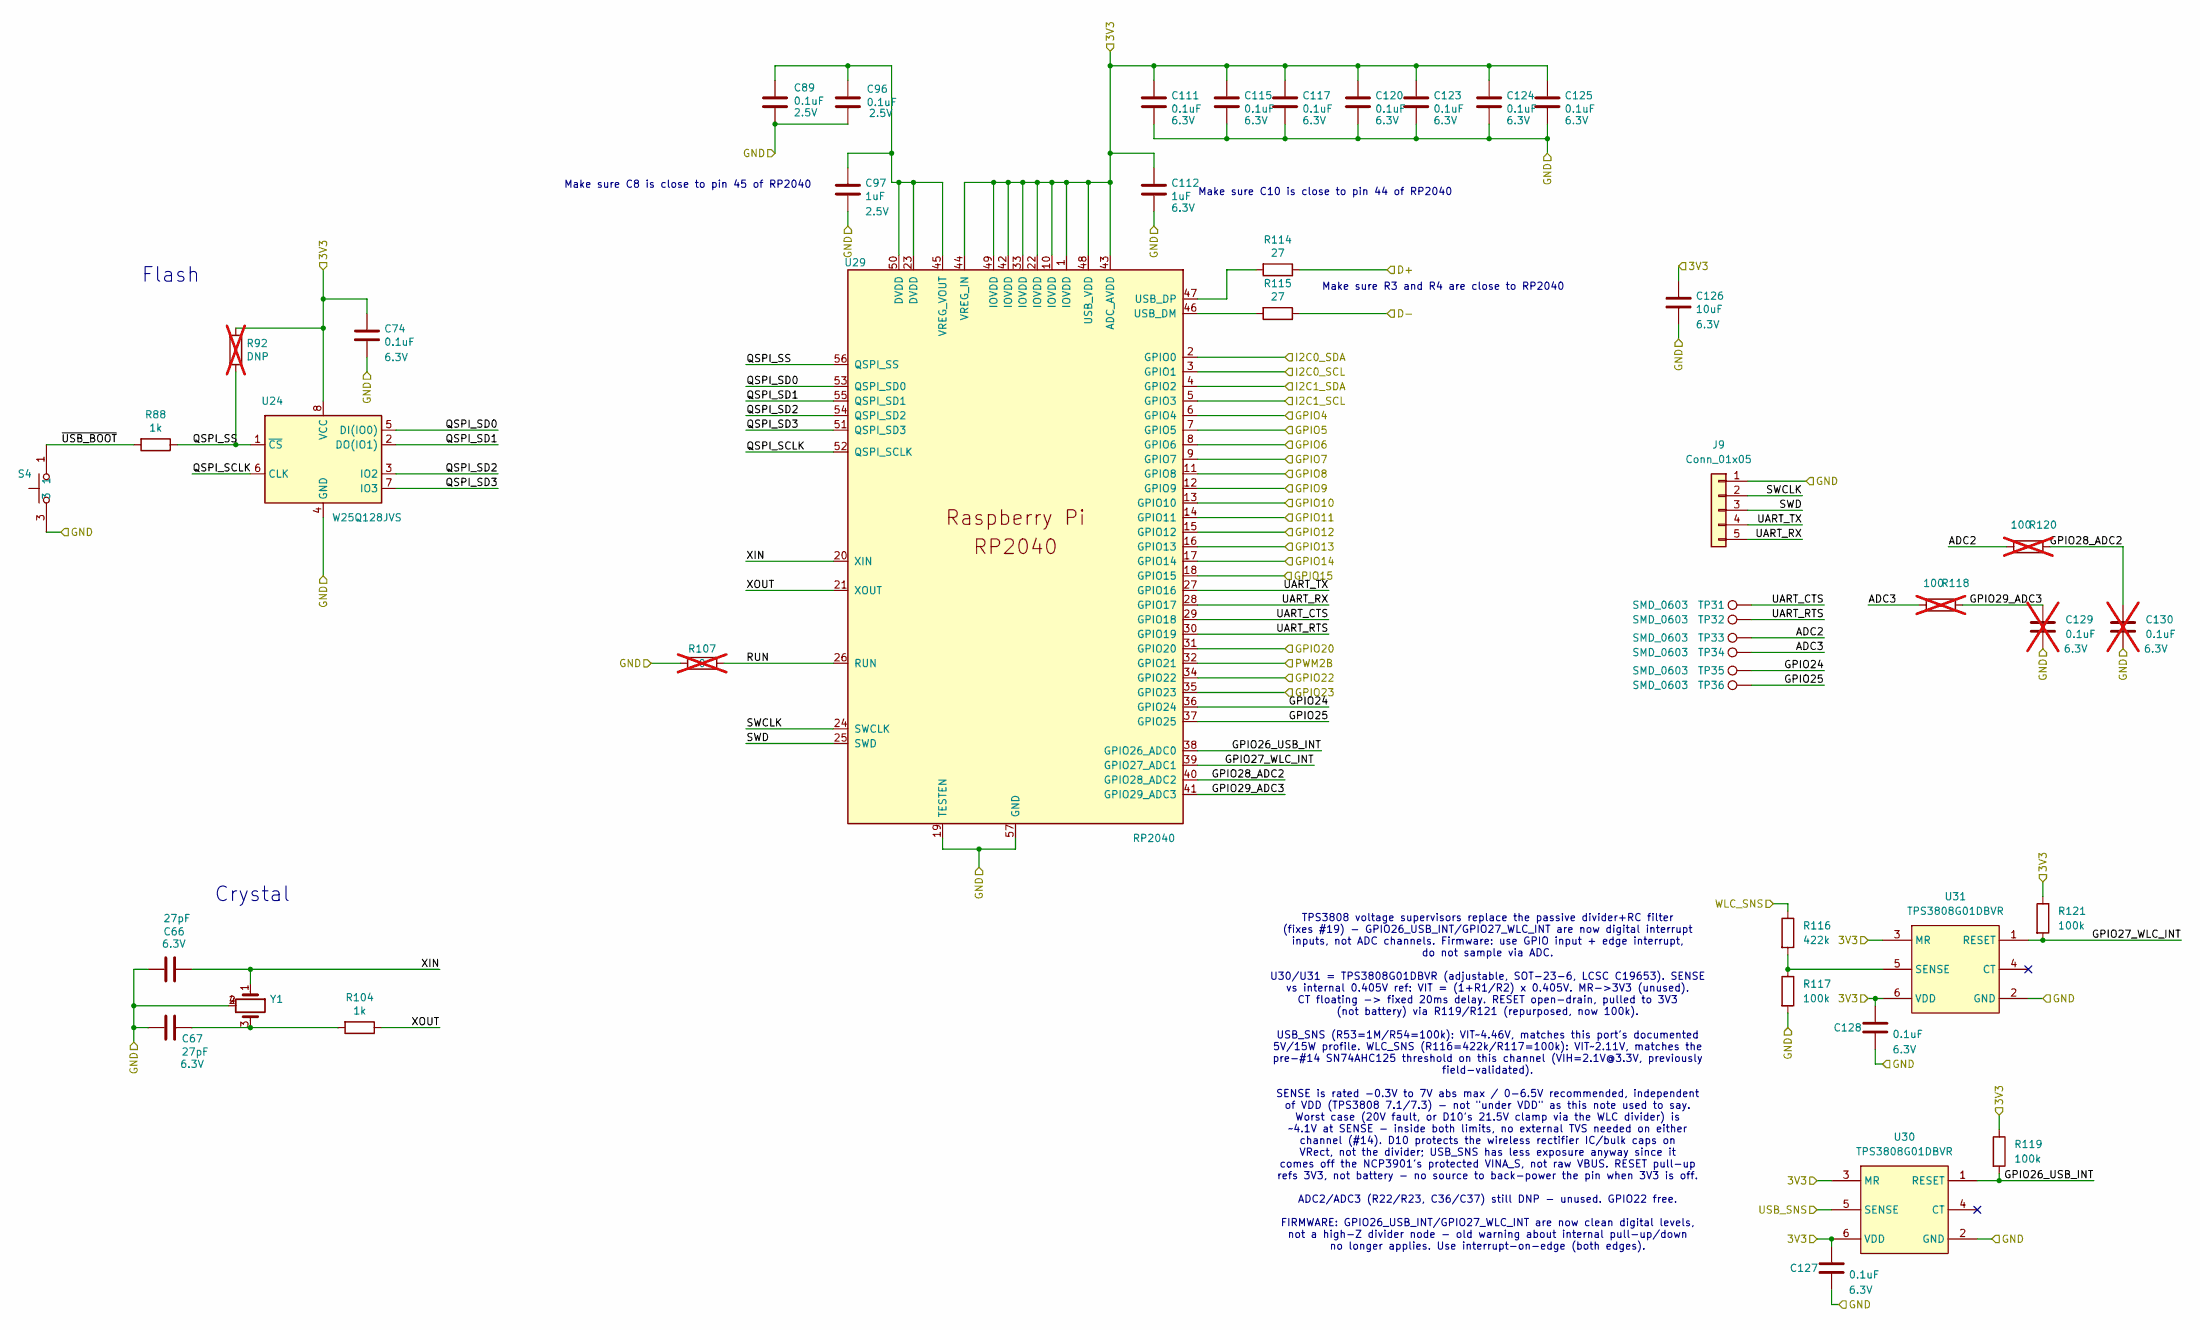
[picture p39: schematic RP2040_minimal.kicad_sch, RP2040 Minimal Design Example]

Parts:
C66, C67: 27pF; C_0402_1005Metric; Part Number GRM1555C1H270JA01J
C74, C89, C96, C111, C115, C117, C120, C123, C124, C125, C127, C128: 0.1uF; C_0402_1005Metric; Part Number CL05A104KA5NNNC
C97, C112: 1uF; C_0402_1005Metric; Part Number GRM155R61E105KA12D
C126: 10uF; C_0603_1608Metric; Part Number GRM188R61E106KA73J
C129, C130: 0.1uF; C_0402_1005Metric; Part Number CL05A104KA5NNNC; not fitted
J9: Conn_01x05; PinSocket_1x05_P2.54mm_Vertical; Part Number PH1-05-UA
R88, R104: 1k; R_0402_1005Metric; Part Number WR04X102 JTL
R92: DNP; R_0402_1005Metric; Part Number DNP; not fitted
R107: 0; R_0603_1608Metric; Part Number RMCF0603ZT0R00; not fitted
R114, R115: 27; R_0402_1005Metric; Part Number RMCF0402JT27R0
R116: 422k; R_0603_1608Metric; Part Number RT0603BRD07422KL
R117: 100k; R_0603_1608Metric; Part Number WR06X1003FTL
R118, R120: 100; R_0603_1608Metric; Part Number RMCF0603JT100R; not fitted
R119, R121: 100k; R_0402_1005Metric; Part Number 0402WGF1003TCE
S4: PTS815 SJM 250 SMTR LFS; SW4_PTS815 SJM 250 SMTR LFS_CNK; Part Number PTS815 SJM 250 SMTR LFS
TP31, TP32, TP33, TP34, TP35, TP36: SMD_0603; TestPoint_SMD_0603; Part Number RCUCTE
U24: W25Q128JVS; SOIC-8_5.23x5.23mm_P1.27mm; Part Number W25Q128JVSIQ
U29: RP2040; RP2040-QFN-56; Part Number SC0914(13)
U30, U31: TPS3808G01DBVR; SOT-23-6_L2.9-W1.6-P0.95-LS2.8-BR; Part Number TPS3808G01DBVR; LCSC Part C19653
Y1: ECS-120-8-36-CKM-TR3; XTAL_ECS-120-8-36-CKM-TR3; Part Number ECS-120-8-36-CKM-TR3

Connections:
/GPIO4: U29.6 (GPIO4); also elsewhere on the board
/GPIO5: U29.7 (GPIO5); also elsewhere on the board
/GPIO6: U29.8 (GPIO6); also elsewhere on the board
/GPIO7: U29.9 (GPIO7); also elsewhere on the board
/GPIO8: U29.11 (GPIO8); also elsewhere on the board
/GPIO9: U29.12 (GPIO9); also elsewhere on the board
/GPIO10: U29.13 (GPIO10); also elsewhere on the board
/GPIO11: U29.14 (GPIO11); also elsewhere on the board
/GPIO12: U29.15 (GPIO12); also elsewhere on the board
/GPIO13: U29.16 (GPIO13); also elsewhere on the board
/GPIO14: U29.17 (GPIO14); also elsewhere on the board
/GPIO15: U29.18 (GPIO15); also elsewhere on the board
/GPIO20: U29.31 (GPIO20); also elsewhere on the board
/GPIO22: U29.34 (GPIO22); also elsewhere on the board
/GPIO23: U29.35 (GPIO23); also elsewhere on the board
/I2C0_SCL: U29.3 (GPIO1); also elsewhere on the board
/I2C0_SDA: U29.2 (GPIO0); also elsewhere on the board
/I2C1_SCL: U29.5 (GPIO3); also elsewhere on the board
/I2C1_SDA: U29.4 (GPIO2); also elsewhere on the board
/LED_EN: U29.32 (GPIO21); also elsewhere on the board
/MCU/3V3: C74.1, C111.1, C112.1, C115.1, C117.1, C120.1, C123.1, C124.1, C125.1, C126.1, C127.1, C128.1, R92.1, R119.1, R121.1, U24.8 (VCC), U29.1 (IOVDD), U29.10 (IOVDD), U29.22 (IOVDD), U29.33 (IOVDD), U29.42 (IOVDD), U29.43 (ADC_AVDD), U29.44 (VREG_IN), U29.48 (USB_VDD), U29.49 (IOVDD), U30.3 (MR), U30.6 (VDD), U31.3 (MR), U31.6 (VDD); also elsewhere on the board
/MCU/ADC2: R120.2, TP33.1
/MCU/ADC3: R118.2, TP34.1
/MCU/D+: R114.1; also elsewhere on the board
/MCU/D-: R115.1; also elsewhere on the board
/MCU/GPIO24: TP35.1, U29.36 (GPIO24)
/MCU/GPIO25: TP36.1, U29.37 (GPIO25)
/MCU/GPIO26_USB_INT: R119.2, U29.38 (GPIO26_ADC0), U30.1 (RESET)
/MCU/GPIO27_WLC_INT: R121.2, U29.39 (GPIO27_ADC1), U31.1 (RESET)
/MCU/GPIO28_ADC2: C130.1, R120.1, U29.40 (GPIO28_ADC2)
/MCU/GPIO29_ADC3: C129.1, R118.1, U29.41 (GPIO29_ADC3)
/MCU/QSPI_SCLK: U24.6 (CLK), U29.52 (QSPI_SCLK)
/MCU/QSPI_SD0: U24.5 (DI(IO0)), U29.53 (QSPI_SD0)
/MCU/QSPI_SD1: U24.2 (DO(IO1)), U29.55 (QSPI_SD1)
/MCU/QSPI_SD2: U24.3 (IO2), U29.54 (QSPI_SD2)
/MCU/QSPI_SD3: U24.7 (IO3), U29.51 (QSPI_SD3)
/MCU/QSPI_SS: R88.1, R92.2, U24.1 (~CS), U29.56 (QSPI_SS)
/MCU/RUN: R107.2, U29.26 (RUN)
/MCU/SWCLK: J9.2, U29.24 (SWCLK)
/MCU/SWD: J9.3, U29.25 (SWD)
/MCU/UART_CTS: TP31.1, U29.29 (GPIO18)
/MCU/UART_RTS: TP32.1, U29.30 (GPIO19)
/MCU/UART_RX: J9.5, U29.28 (GPIO17)
/MCU/UART_TX: J9.4, U29.27 (GPIO16)
/MCU/XIN: C66.1, U29.20 (XIN), Y1.1
/MCU/XOUT: R104.1, U29.21 (XOUT)
/MCU/~USB_BOOT: R88.2, S4.1, S4.2
/USB_SNS: U30.5 (SENSE); also elsewhere on the board
/VRect: R116.1; also elsewhere on the board
GND: C66.2, C67.2, C74.2, C89.2, C96.2, C97.2, C111.2, C112.2, C115.2, C117.2, C120.2, C123.2, C124.2, C125.2, C126.2, C127.2, C128.2, C129.2, C130.2, J9.1, R107.1, R117.2, S4.3, S4.4, U24.4 (GND), U29.19 (TESTEN), U29.57 (GND), U30.2 (GND), U31.2 (GND), Y1.2 (GND), Y1.4 (GND); also elsewhere on the board
unnamed: C67.1, R104.2, Y1.3
unnamed: R115.2, U29.46 (USB_DM)
unnamed: R114.2, U29.47 (USB_DP)
unnamed: C89.1, C96.1, C97.1, U29.23 (DVDD), U29.45 (VREG_VOUT), U29.50 (DVDD)
unnamed: R116.2, R117.1, U31.5 (SENSE)

Notes on the sheet:
Make sure C8 is close to pin 45 of RP2040
TPS3808 voltage supervisors replace the passive divider+RC filter (fixes #19) - GPIO26_USB_INT/GPIO27_WLC_INT are now digital interrupt inputs, not ADC channels. Firmware: use GPIO input + edge interrupt, do not sample via ADC. U30/U31 = TPS3808G01DBVR (adjustable, SOT-23-6, LCSC C19653). SENSE vs 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
Make sure C10 is close to pin 44 of RP2040
Flash
Crystal
Make sure R3 and R4 are close to RP2040

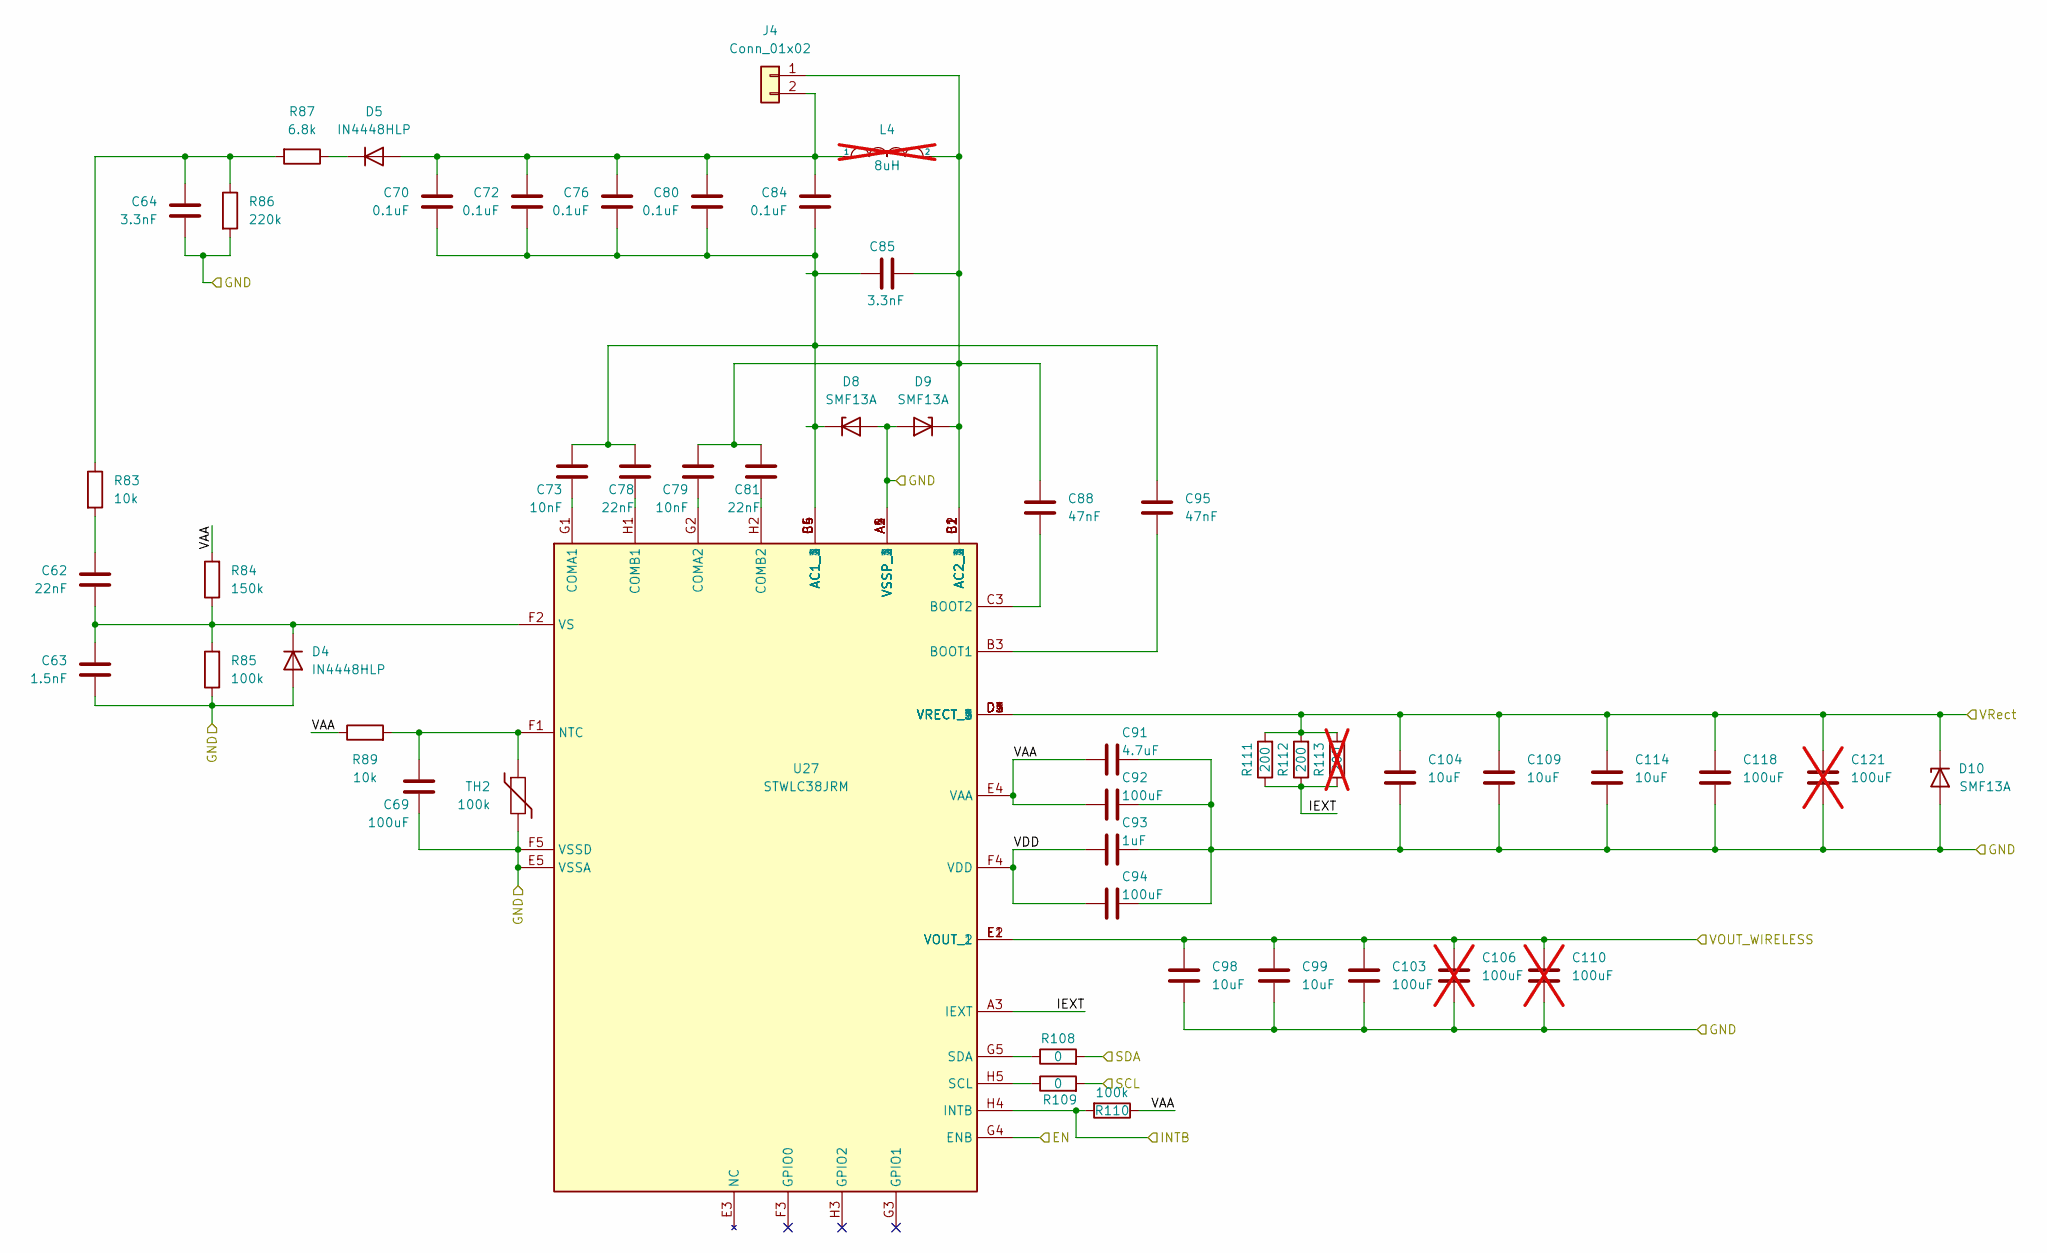
[picture p40: schematic Wireless-Receiver.kicad_sch]

Parts:
C62, C78, C81: 22nF; C_0402_1005Metric; Part Number GRM155R71H223KA12J
C63: 1.5nF; C_0402_1005Metric; Part Number GCM155R71H152KA37D
C64, C85: 3.3nF; C_0402_1005Metric; Part Number GCM155R71H332KA37J
C69, C92, C94: 100uF; C_1206_3216Metric; Part Number GRM31CD80J107MEA8K
C70, C72, C76, C80, C84: 0.1uF; C_0402_1005Metric; Part Number GRM155R62A104KE14D
C73, C79: 10nF; C_0402_1005Metric; Part Number 885012205067
C88, C95: 47nF; C_0402_1005Metric; Part Number GRM155R71H473KE14D
C91: 4.7uF; C_0603_1608Metric; Part Number GRM188R61E475KE11D
C93: 1uF; C_0402_1005Metric; Part Number GRM155R61E105KA12D
C98, C99, C104, C109, C114: 10uF; C_0603_1608Metric; Part Number GRM188R61E106KA73J
C103: 100uF; C_1210_3225Metric; Part Number GRM31CD80J107MEA8K
C106, C110, C121: 100uF; C_1210_3225Metric; Part Number GMC32X5R107M16NT; not fitted
C118: 100uF; C_1210_3225Metric; Part Number GMC32X5R107M16NT
D4, D5: IN4448HLP; D_0402_1005Metric; Part Number 1N4448HLP-7
D8, D9, D10: SMF13A; D_SOD-123F; Part Number SMF13A
J4: Conn_01x02; THT_Pitch5mm_Drill1.2mm; Part Number N/A
L4: 8uH; Part Number 760308102207; not fitted
R83, R89: 10k; R_0603_1608Metric; Part Number WR06X1002FTL
R84: 150k; R_0402_1005Metric; Part Number RC0402FR-13150KL
R85, R110: 100k; R_0603_1608Metric; Part Number WR06X1003FTL
R86: 220k; R_0402_1005Metric; Part Number RC0402FR-07220KL
R87: 6.8k; R_0402_1005Metric; Part Number RC0402FR-136K8L
R108, R109: 0; R_0603_1608Metric; Part Number RMCF0603ZT0R00
R111, R112: 200; R_0603_1608Metric; Part Number ERJ-PA3J201V
R113: 200; R_0603_1608Metric; Part Number ERJ-PA3J201V; not fitted
TH2: 100k; R_0402_1005Metric; Part Number NCU15WF104J6SRC
U27: STWLC38JRM; BGA40C40P5X8_213X333X57; Part Number STWLC38JRM

Connections:
/GPIO9: U27.G4 (ENB); also elsewhere on the board
/GPIO23: R110.2, U27.H4 (INTB); also elsewhere on the board
/I2C0_SCL: R109.2; also elsewhere on the board
/I2C0_SDA: R108.2; also elsewhere on the board
/PowerMux/VIN_B: C98.2, C99.2, C103.2, C106.2, C110.2, U27.E1 (VOUT_1), U27.E2 (VOUT_2); also elsewhere on the board
/VRect: C104.2, C109.2, C114.2, C118.2, C121.2, D10.1 (K), R111.2, R112.2, R113.2, U27.D1 (VRECT_1), U27.D2 (VRECT_2), U27.D3 (VRECT_3), U27.D4 (VRECT_4), U27.D5 (VRECT_5); also elsewhere on the board
/Wireless-Receiver/IEXT: R111.1, R112.1, R113.1, U27.A3 (IEXT)
/Wireless-Receiver/VAA: C91.2, C92.2, R84.2, R89.1, R110.1, U27.E4 (VAA)
/Wireless-Receiver/VDD: C93.2, C94.2, U27.F4 (VDD)
GND: C63.1, C64.1, C69.2, C91.1, C92.1, C93.1, C94.1, C98.1, C99.1, C103.1, C104.1, C106.1, C109.1, C110.1, C114.1, C118.1, C121.1, D4.2 (A), D8.2 (A), D9.2 (A), D10.2 (A), R85.1, R86.2, TH2.2, U27.A1 (VSSP_1), U27.A2 (VSSP_2), U27.A4 (VSSP_3), U27.A5 (VSSP_4), U27.E5 (VSSA), U27.F5 (VSSD); also elsewhere on the board
unnamed: C62.2, R83.2
unnamed: C64.2, R83.1, R86.1, R87.2
unnamed: C62.1, C63.2, D4.1 (K), R84.1, R85.2, U27.F2 (VS)
unnamed: C70.1, C72.1, C76.1, C80.1, C84.1, D5.2 (A), J4.2, L4.1
unnamed: D5.1 (K), R87.1
unnamed: C70.2, C72.2, C73.2, C76.2, C78.2, C80.2, C84.2, C85.1, C95.2, D8.1 (K), U27.B4 (AC1_1), U27.B5 (AC1_2), U27.C4 (AC1_3), U27.C5 (AC1_4)
unnamed: C79.2, C81.2, C85.2, C88.2, D9.1 (K), J4.1, L4.2, U27.B1 (AC2_1), U27.B2 (AC2_2), U27.C1 (AC2_3), U27.C2 (AC2_4)
unnamed: C95.1, U27.B3 (BOOT1)
unnamed: C88.1, U27.C3 (BOOT2)
unnamed: C73.1, U27.G1 (COMA1)
unnamed: C79.1, U27.G2 (COMA2)
unnamed: C78.1, U27.H1 (COMB1)
unnamed: C81.1, U27.H2 (COMB2)
unnamed: C69.1, R89.2, TH2.1, U27.F1 (NTC)
unnamed: R109.1, U27.H5 (SCL)
unnamed: R108.1, U27.G5 (SDA)
