tekkura/sr-cad/pcb/robot/robot.kicad_pcb

## KiCad design pcb/robot/robot.kicad_pcb (continued)

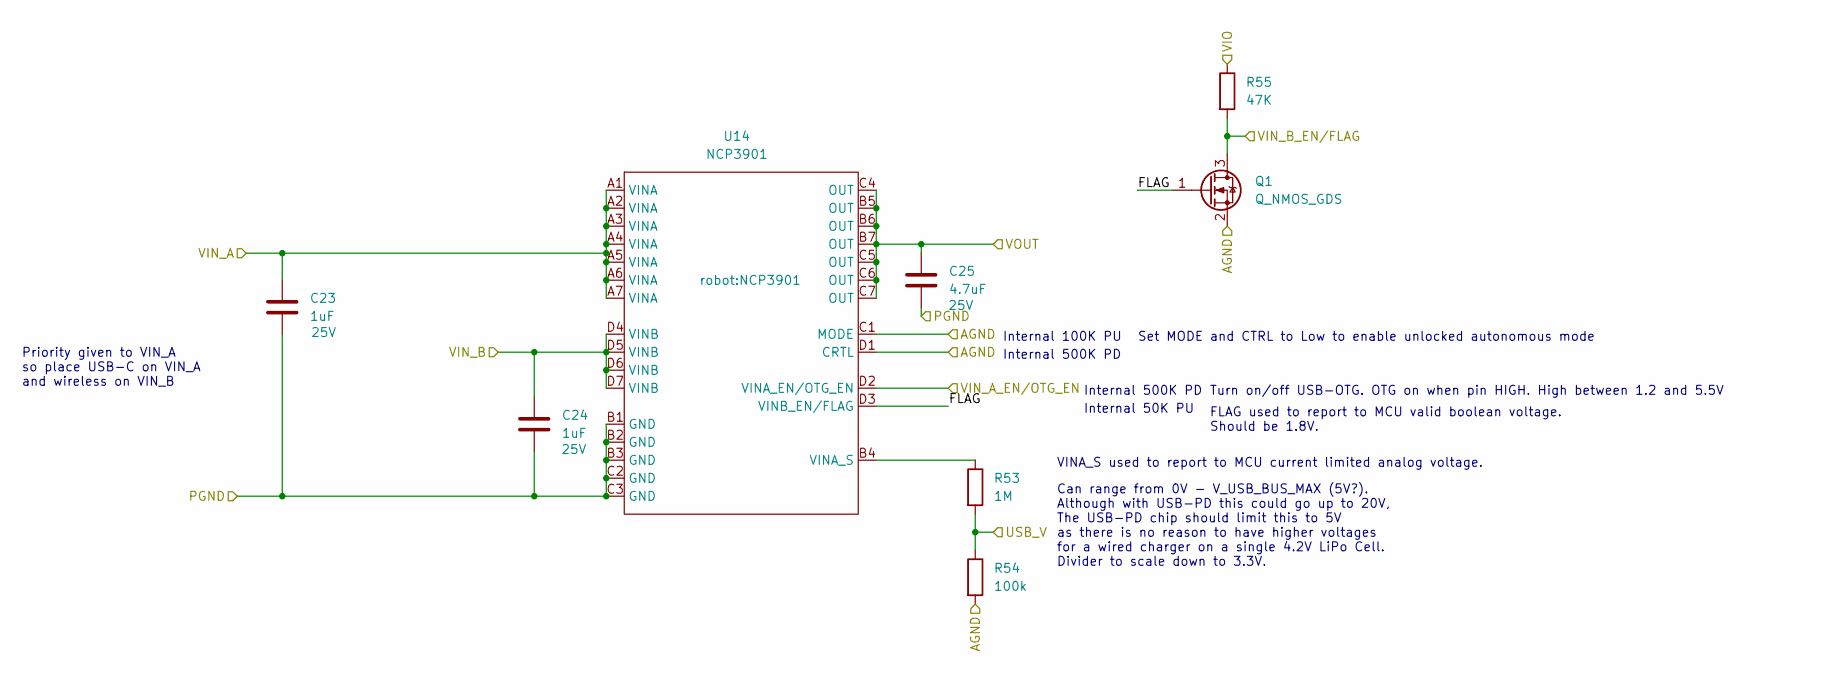
[picture p41: schematic powerMux.kicad_sch]

Parts:
C23, C24: 1uF; C_0402_1005Metric; Part Number GRM155R61E105KA12D
C25: 4.7uF; C_0603_1608Metric; Part Number GRM188R61E475KE11D
Q1: Q_NMOS_GDS; SOT-23; Part Number BSS138
R53: 1M; R_0603_1608Metric; Part Number FRC0603F1004TS
R54: 100k; R_0603_1608Metric; Part Number WR06X1003FTL
R55: 47K; R_0603_1608Metric; Part Number RMCF0603JT47K0
U14: NCP3901; Part Number NCP3901FCCT1G

Connections:
/GPIO4: Q1.3 (D), R55.2; also elsewhere on the board
/GPIO5: U14.D2 (VINA_EN/OTG_EN); also elsewhere on the board
/PowerMux/FLAG: Q1.1 (G), U14.D3 (VINB_EN/FLAG)
/PowerMux/VIN_A: C23.1, U14.A1 (VINA), U14.A2 (VINA), U14.A3 (VINA), U14.A4 (VINA), U14.A5 (VINA), U14.A6 (VINA), U14.A7 (VINA); also elsewhere on the board
/PowerMux/VIN_B: C24.1, U14.D4 (VINB), U14.D5 (VINB), U14.D6 (VINB), U14.D7 (VINB); also elsewhere on the board
/PowerMux/VIO: R55.1; also elsewhere on the board
/PowerMux/VOUT: C25.1, U14.B5 (OUT), U14.B6 (OUT), U14.B7 (OUT), U14.C4 (OUT), U14.C5 (OUT), U14.C6 (OUT), U14.C7 (OUT); also elsewhere on the board
/USB_SNS: R53.2, R54.1; also elsewhere on the board
GND: C23.2, C24.2, C25.2, Q1.2 (S), R54.2, U14.B1 (GND), U14.B2 (GND), U14.B3 (GND), U14.C1 (MODE), U14.C2 (GND), U14.C3 (GND), U14.D1 (CRTL); also elsewhere on the board
unnamed: R53.1, U14.B4 (VINA_S)

Notes on the sheet:
Internal 500K PD
VINA_S used to report to MCU current limited analog voltage.
Internal 100K PU
Internal 50K PU
Can range from 0V - V_USB_BUS_MAX (5V?). Although with USB-PD this could go up to 20V, The USB-PD chip should limit this to 5V as there is no reason to have higher voltages for a wired charger on a single 4.2V LiPo Cell. Divider to scale down to 3.3V.
Priority given to VIN_A so place USB-C on VIN_A and wireless on VIN_B
Turn on/off USB-OTG. OTG on when pin HIGH. High between 1.2 and 5.5V
FLAG used to report to MCU valid boolean voltage. Should be 1.8V.
Set MODE and CTRL to Low to enable unlocked autonomous mode

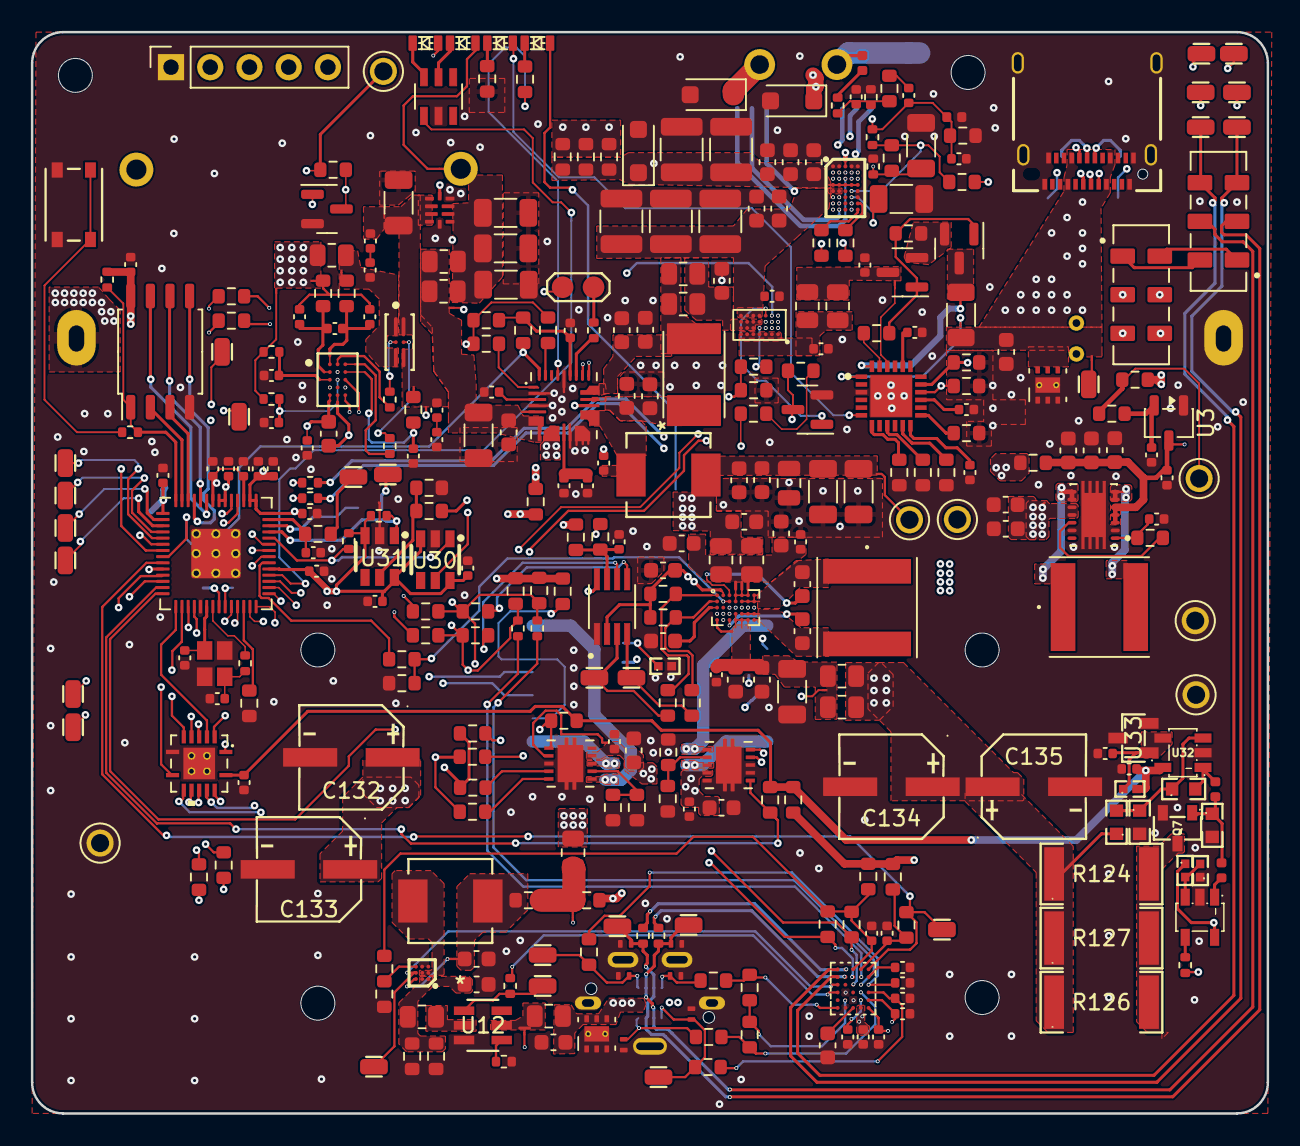
[picture p42: board robot.kicad_pcb from above]

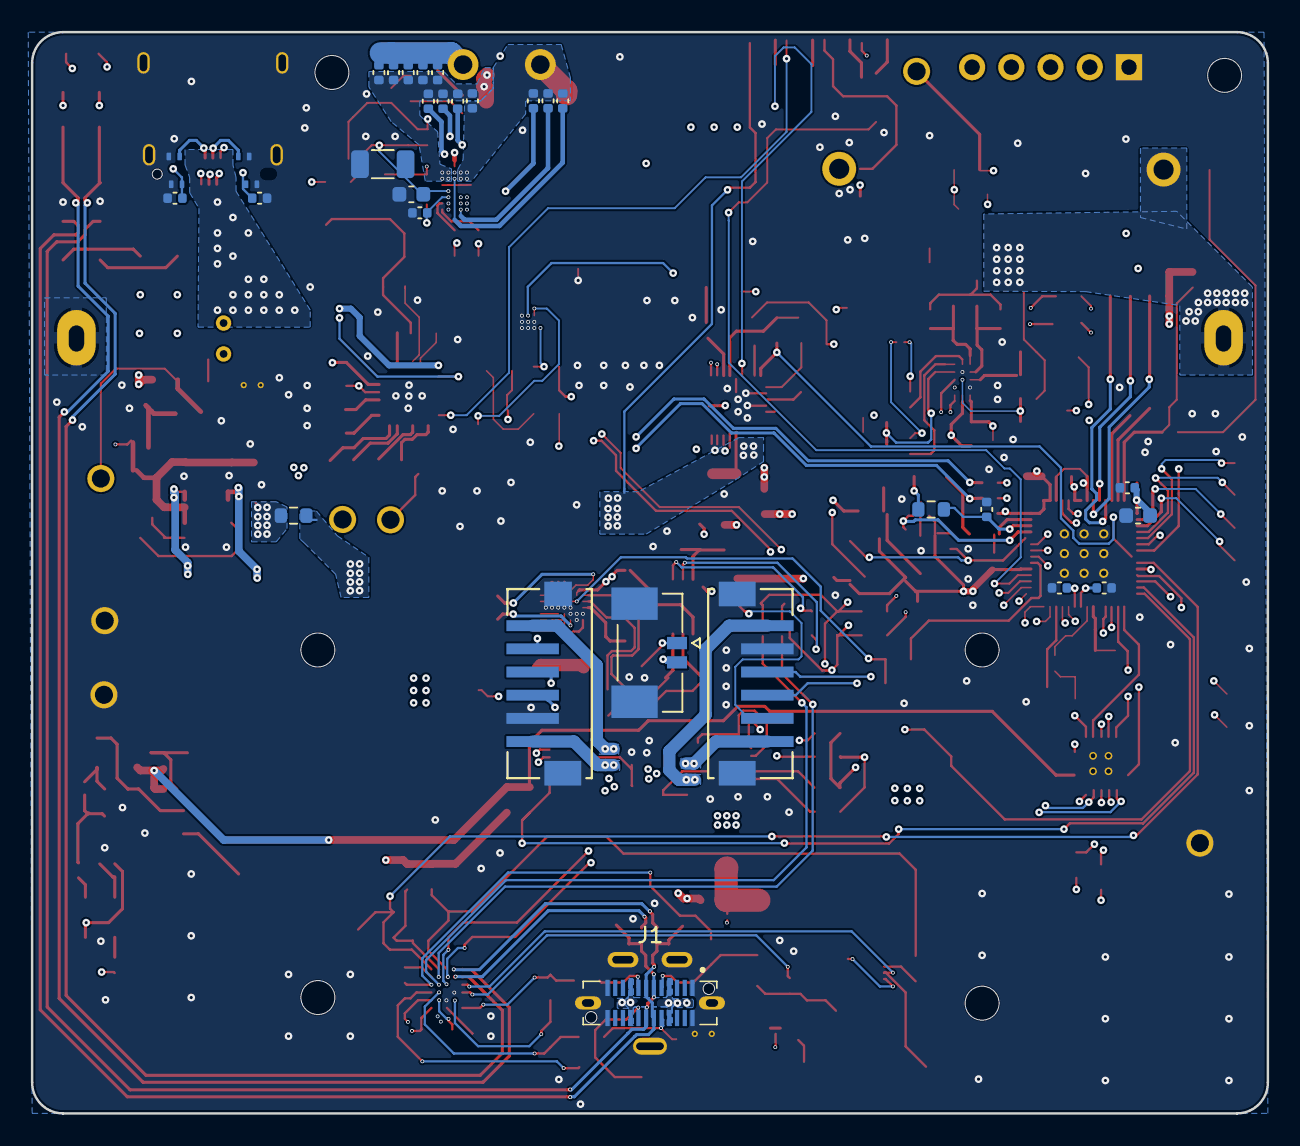
[picture p43: board robot.kicad_pcb from below]

Board: 4 copper layers, 80.0 x 70.0 mm, 408 parts (37 on the bottom side), 250 nets.
