tekkura/sr-cad/pcb/robot/usb-pd-module/USB_PD_Module.kicad_pcb

## KiCad design pcb/robot/usb-pd-module/USB_PD_Module.kicad_pcb (2026-07-28)

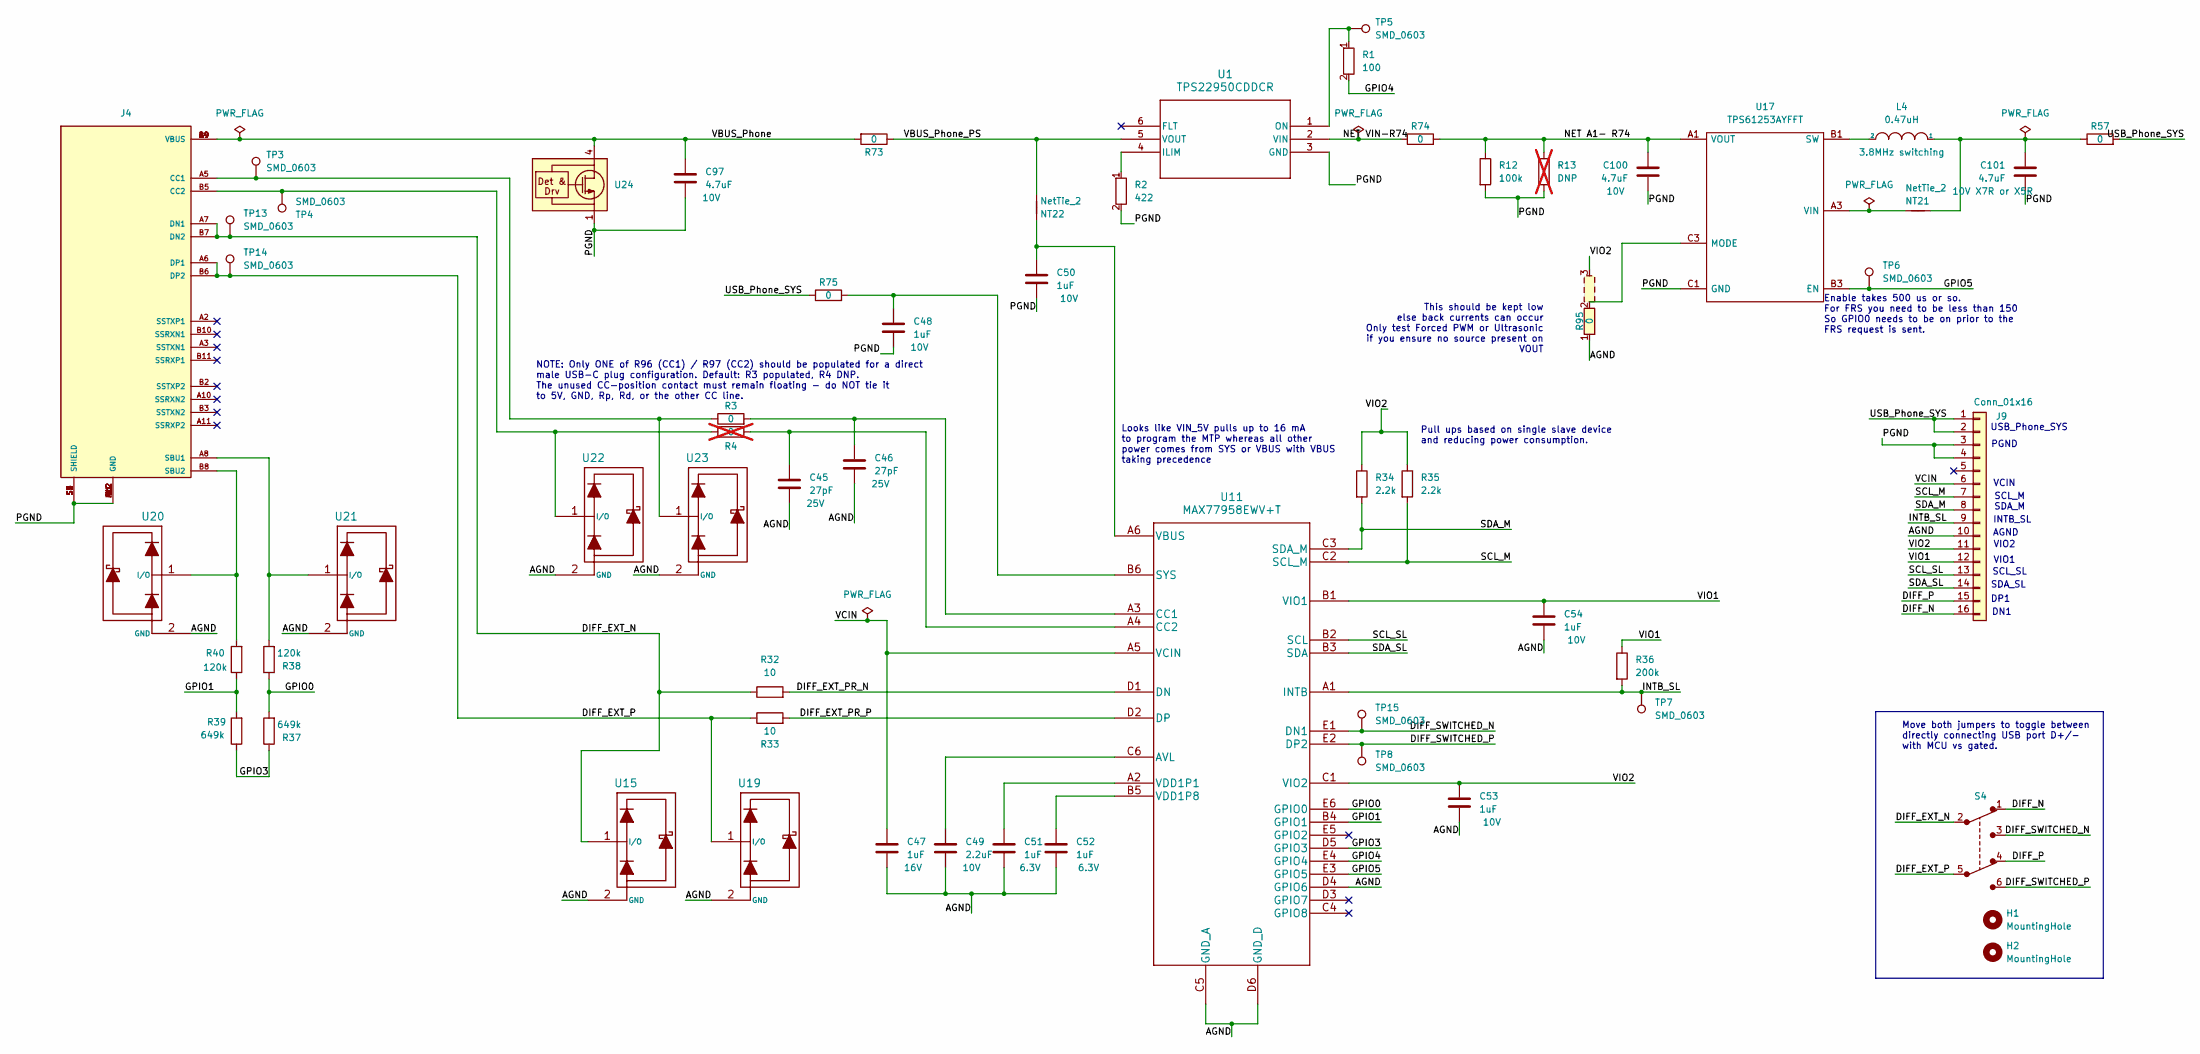
[picture p44: schematic USB_PD_Module.kicad_sch]

Parts:
C45, C46: 27pF; C_0402_1005Metric; Part Number GRM1555C1H270JA01J
C47, C48, C50, C51, C52, C53, C54: 1uF; C_0402_1005Metric; Part Number GRM155R61E105KA12D
C49: 2.2uF; C_0603_1608Metric; Part Number CL10A225KP8NNNC
C97, C100, C101: 4.7uF; C_0603_1608Metric; Part Number GRM188R61E475KE11D
H1, H2: MountingHole; MountingHole_2.2mm_M2_2mm_clearance
J4: USB4151-GF-C; GCT_USB4151-GF-C_REVA; Part Number USB4151-GF-C
J9: Conn_01x16; Castellated 1x16 2.54mm
L4: 0.47uH; Vishay-IHLP-2020BZ-FP_1.905x2.79-3D_2.0-0-0-MFG; Part Number IHLP2020BZERR47M01
NT21, NT22: NetTie_2; NetTie-_SMD_Pad6mil; Part Number N/A
R1: 100; R_0402_1005Metric; DigiKey_Part_Number 311-100LRCT-ND
R2: 422; R_0402_1005Metric; DigiKey_Part_Number YAG3158CT-ND
R3, R57, R75: 0; R_0603_1608Metric; Part Number RMCF0603ZT0R00
R4: 0; R_0603_1608Metric; Part Number RMCF0603ZT0R00; not fitted
R12: 100k; R_0603_1608Metric; Part Number WR06X1003FTL
R13: DNP; R_0603_1608Metric; Part Number DNP; not fitted
R32, R33: 10; R_0402_1005Metric; Part Number RC0402FR-1310RL
R34, R35: 2.2k; R_0603_1608Metric; Part Number RMCF0603JT2K20
R36: 200k; R_0603_1608Metric; Part Number RMCF0603JT200K
R37, R39: 649k; R_0603_1608Metric; Part Number ERJ-3EKF6493V
R38, R40: 120k; R_0603_1608Metric; Part Number RMCF0603JT120K
R73, R74: 0; R_0805_2012Metric; Part Number RMCF0805ZT0R00
R95: 0; R_0603_1608Metric_3pin_Switch; Part Number RMCF0603ZT0R00
S4: JS202011JCQN; SW_JS202011JCQN; Part Number JS202011JCQN
TP3, TP4, TP5, TP6, TP7, TP8, TP13, TP14, TP15: SMD_0603; TestPoint_SMD_0603; Part Number RCUCTE
U1: TPS22950CDDCR; DDC6_TEX
U11: MAX77958EWV+T; MAX77958EWV&plus_T; Part Number MAX77958EWV+T
U15, U19, U20, U21, U22, U23: TPD1E05U06; TPD1E05U06DPYR; Part Number TPD1E05U06DPYR
U17: TPS61253AYFFT; Texas_Instruments-YFF0009-BGA9C40P3X3_119X129X62; Part Number TPS61253AYFFT
U24: TVS0500DRV; TVS0500DRVR; Part Number TVS0500DRVR

Connections:
/AGND: C45.2, C46.2, C47.2, C49.2, C51.2, C52.2, C53.2, C54.2, J9.10, R95.1, U11.C5 (GND_A), U11.D4 (GPIO6), U11.D6 (GND_D), U15.2 (GND), U19.2 (GND), U20.2 (GND), U21.2 (GND), U22.2 (GND), U23.2 (GND)
/DIFF_EXT_N: J4.A7 (DN1), J4.B7 (DN2), R32.1, S4.2, TP13.1, U15.1 (I/O)
/DIFF_EXT_P: J4.A6 (DP1), J4.B6 (DP2), R33.1, S4.5, TP14.1, U19.1 (I/O)
/DIFF_EXT_PR_N: R32.2, U11.D1 (DN)
/DIFF_EXT_PR_P: R33.2, U11.D2 (DP)
/DIFF_N: J9.16, S4.1
/DIFF_P: J9.15, S4.4
/DIFF_SWITCHED_N: S4.3, TP15.1, U11.E1 (DN1)
/DIFF_SWITCHED_P: S4.6, TP8.1, U11.E2 (DP2)
/GPIO0: R37.2, R38.1, U11.E6 (GPIO0)
/GPIO1: R39.2, R40.1, U11.B4 (GPIO1)
/GPIO3: R37.1, R39.1, U11.D5 (GPIO3)
/GPIO4: R1.2, U11.E4 (GPIO4)
/GPIO5: TP6.1, U11.E3 (GPIO5), U17.B3 (EN)
/INTB_SL: J9.9, R36.2, TP7.1, U11.A1 (INTB)
/NET A1- R74: C100.1, R12.1, R13.1, R74.2, U17.A1 (VOUT), U17.A2 (VOUT)
/NET VIN-R74: R74.1, U1.2 (VIN)
/SCL_M: J9.7, R35.2, U11.C2 (SCL_M)
/SCL_SL: J9.13, U11.B2 (SCL)
/SDA_M: J9.8, R34.2, U11.C3 (SDA_M)
/SDA_SL: J9.14, U11.B3 (SDA)
/USB_Phone_SYS: J9.1, J9.2, R57.2, R75.1
/VBUS_Phone: C97.1, J4.A4 (VBUS), J4.A9 (VBUS), J4.B4 (VBUS), J4.B9 (VBUS), R73.2, U24.4 (IN), U24.5 (IN), U24.6 (IN)
/VBUS_Phone_PS: NT22.2, R73.1, U1.5 (VOUT)
/VCIN: C47.1, J9.6, U11.A5 (VCIN)
/VIO1: C54.1, J9.12, R36.1, U11.B1 (VIO1)
/VIO2: C53.1, J9.11, R34.1, R35.1, R95.3, U11.C1 (VIO2)
GND: C48.2, C50.2, C97.2, C100.2, C101.2, J4.A1 (GND), J4.A12 (GND), J4.B1 (GND), J4.B12 (GND), J4.S1 (SHIELD), J4.S2 (SHIELD), J4.S3 (SHIELD), J4.S4 (SHIELD), J4.S5 (SHIELD), J9.3, J9.4, R2.2, R12.2, R13.2, U1.3 (GND), U17.C1 (GND), U17.C2 (GND), U24.1 (GND), U24.2 (GND), U24.3 (GND), U24.7 (GND)
unnamed: C101.1, L4.1, NT21.2, R57.1
unnamed: J4.A5 (CC1), R3.1, TP3.1, U23.1 (I/O)
unnamed: J4.B5 (CC2), R4.1, TP4.1, U22.1 (I/O)
unnamed: J4.A8 (SBU1), R38.2, U21.1 (I/O)
unnamed: J4.B8 (SBU2), R40.2, U20.1 (I/O)
unnamed: L4.2, U17.B1 (SW), U17.B2 (SW)
unnamed: R2.1, U1.4 (ILIM)
unnamed: R1.1, TP5.1, U1.1 (ON)
unnamed: C49.1, U11.C6 (AVL)
unnamed: C46.1, R3.2, U11.A3 (CC1)
unnamed: C45.1, R4.2, U11.A4 (CC2)
unnamed: C48.1, R75.2, U11.B6 (SYS)
unnamed: C50.1, NT22.1, U11.A6 (VBUS)
unnamed: C51.1, U11.A2 (VDD1P1)
unnamed: C52.1, U11.B5 (VDD1P8)
unnamed: R95.2, U17.C3 (MODE)
unnamed: NT21.1, U17.A3 (VIN)

Notes on the sheet:
This should be kept low else back currents can occur Only test Forced PWM or Ultrasonic if you ensure no source present on VOUT
SCL_M
SCL_SL
SDA_M
AGND
VIO2
PGND
USB_Phone_SYS
DP1
INTB_SL
Enable takes 500 us or so. For FRS you need to be less than 150 So GPIO0 needs to be on prior to the FRS request is sent.
VCIN
NOTE: Only ONE of R96 (CC1) / R97 (CC2) should be populated for a direct male USB-C plug configuration. Default: R3 populated, R4 DNP. The unused CC-position contact must remain floating - do NOT tie it to 5V, GND, Rp, Rd, or the other CC line.
Pull ups based on single slave device and reducing power consumption.
DN1
SDA_SL
VIO1
Looks like VIN_5V pulls up to 16 mA to program the MTP whereas all other power comes from SYS or VBUS with VBUS taking precedence
Move both jumpers to toggle between directly connecting USB port D+/- with MCU vs gated.

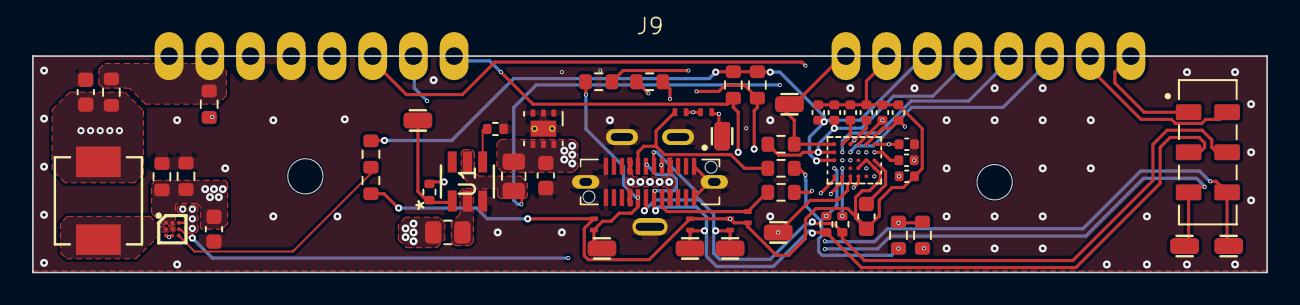
[picture p45: board USB_PD_Module.kicad_pcb from above]

Board: 4 copper layers, 77.0 x 13.5 mm, 60 parts (0 on the bottom side), 45 nets.
