tekkura/sr-cad/(commit log)

2026-01-23 Modularized usb-pd board and main board split
    [20021111-00010XXLFc.stp, 3M_2510-6002.stp, 3M_SJ5003Transparent.stp, CAP_C_0402.step, CAP_C_0603.step, Charger.kicad_sch, Conn_Harwin_M20-9990246_eec.STEP, Conn_Samtec_SNT-100-BK-G_eec.STEP]
2026-01-28 Adding USB_PD_Module 3d model for visualization in main board
2026-01-28 Adding usb holes footprint for main board
2026-01-28 Updating main pcb with usb hole and 3d model for module
    [USB-PD-PhonePC.kicad_sch, robot.kicad_pcb, robot.kicad_sch]
2026-01-28 Update: Refreshed Gerbers and generated raw BOMs
    I regenerated the motherboard gerbers, saved the modified footprints, and associated them with the schematic.
    [BOM_robot.csv, USB_PD_Module.kicad_sch, USB_PD_Module_BOM.csv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]
2026-03-03 Added the TPS22950CDDCR
    Generation, upgrade, and replacement of devices in BOM for manufacturing at JLCPCB.
    [BOM_robot.csv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]
2026-03-03 Add Octopart list
    BOM generate
    Order and check for BOM availability
    [BOM_list_Digikey.xlsx, BOM_robot.csv, BOM_robot_module.csv, BOM_robot_module_Octopart.xlsx, BOM_robot_module_clean.csv, USB_PD_Module_BOM.csv]
2026-03-19 Price update and final BOM
    The actual prices were added as an image of the order placed, and the BOM downloaded directly from the order was added.
    [BOM_JLCPCB.xls, USB_PD_Module_BOM.xlsx]
2026-03-22 JLCPCB Update and Verification
    The Gerber files were updated, DNP and exclude were removed, Gerber files were uploaded and configured to JLCPCB, Pick and Place and BOM were added, devices were replaced, and factory stock was verified. The price and estimated manufacturing time were obtained.
    [BOM_JLCPCB.xlsx, BOM_robot.csv, DNPtoBuy.csv, InventorySent.xlsx, NextPCBDFAReportTE56182AA5.xlsx, POS_JLCPCB.xlsx, Protection.kicad_sch, USB-PD-PhonePC.kicad_sch]
2026-03-23 update led
    [BOM_JLCPCB.xlsx]
2026-03-30 Modification and replacement of MAX77642ANA
    The MAX77642ANA was replaced with the LDO XC6206 and the TPS63021DSJR. Rerouting and Gerber updates were performed.
    [LDO.kicad_sch, USB-PD-PhonePC.kicad_sch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]
2026-04-01 BOM and pricing update.
    [BOM_JLCPCB.xlsx, POS_JLCPCB.xlsx, robot_bom.csv, robot_bom_JLCPCB.xlsx, robot_modified_bom.csv]
2026-07-28 Add selectable 0-ohm CC jumpers on USB-PD module (addresses #3)
    Insert R3 (CC1, populated) and R4 (CC2, DNP) in series between J4 and
    the MAX77958 CC1/CC2 pins, so only one CC path is active for a direct
    male USB-C plug configuration. Both jumpers placed in a separate area
    with clear access for rework/probing.
    Also cleaned up ERC findings found while editing: no-connect markers
    on unused TPS22950CDDCR pin 6 and Conn_01x16 pin 5, and reorganized
    power netclasses (Power_Module -> power_1A / Default).
    [USB_PD_Module.kicad_pcb, USB_PD_Module.kicad_sch]
2026-07-28 Fix reversed motor connector pins on J3/J5 (fixes #15)
    Swap pins 1/6 (motor phase polarity) and 2/5 (encoder VCC/GND) on
    both motor JST connectors (J3, J5), so standard JST cables work
    without custom re-pinning and without needing a software-side
    forward/backward negation workaround. Pins 3/4 (encoder A/B) left
    untouched. PCB copper re-routed to match; verified 0 unconnected
    items via DRC and no new ERC violations on J3/J5.
    Firmware's negation workaround should be removed once this hardware
    revision is in use, or the two corrections will cancel out.
    Fix leftover note typo and grid nudge (follow-up to #3)
    Correct CC jumper note in USB_PD_Module.kicad_sch to reference the
    actual R3/R4 desig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
    [Protection.kicad_sch, USB_PD_Module.kicad_sch, motors.kicad_sch, robot.kicad_pcb]
2026-07-28 Remove unnecessary bulk caps C74/C86/C89/C90 (fixes #16)
    Delete the 4 redundant 100uF bulk caps (VCC-GND, motor driver rail)
    from both schematic and PCB to reclaim board space. Stress testing
    (see #4 discussion) showed rail variation stays under 100mV even
    without them, so the extra bulk capacitance added after the earlier
    UVLO investigation is no longer needed.
    Verified via ERC/DRC: same violation counts as before (314/7),
    0 unconnected items - no regressions from the removal.
    [motors.kicad_sch, robot.kicad_pcb]
2026-07-28 Replace SN74AHC125 ADC buffer with passive protection (fixes #14)
    The SN74AHC125 is a digital logic buffer, not an analog pass-through
    - its push-pull output snaps to a rail based on VIH/VIL threshold
    instead of reproducing the sensed voltage, so the ADC0/ADC1 channels
    were not measuring anything meaningful through it. Removed Q5
    entirely rather than substituting another buffer/analog-switch IC,
    since any replacement still needs external current limiting and the
    RP2040's own internal clamp diodes already provide that once fault
    current is bounded by a high-impedance divider (verified against the
    RP2040 datasheet: VPIN abs max = IOVDD+0.5V, 1uA leakage, fault
    current ~33uA at 20V via the 510k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
    [RP2040_minimal.kicad_sch, robot.kicad_pcb]
2026-08-09 Add 470k pull-down on IC1.ON to fix floating pin when off (fixes #6)
    Replace DNP C99 (1uF cap) with populated R13 (470kOhm, LCSC C25562) from IC1.ON to GND - was floating when SW1 is open. Sized per TPS22998 worst-case (falling threshold min 0.595V, leakage max 1uA). Verified via ERC/DRC against baseline: no regressions, 0 unconnected items before/after.
    [Protection.kicad_sch, RP2040_minimal.kicad_sch, robot.kicad_pcb]
2026-08-10 Replace ADC charger-sense front-end with GPIO interrupts (fixes #19)
    Add 2x TPS3808G01DBVR voltage supervisors on USB_V and VRect
    charger-sense paths, replacing the ADC divider+RC filter. GPIO26_ADC0/
    GPIO27_ADC1 are now digital interrupt inputs (VIT~4.46V USB_V,
    ~2.11V VRect) instead of ADC channels.
    Renamed net labels to reflect the digital nature of these signals:
    ADC0 -> USB_SNS, ADC1 -> WLC_SNS (both hierarchical, crossing into
    the MCU sheet), GPIO26_ADC0 -> GPIO26_USB_INT, GPIO27_ADC1 ->
    GPIO27_WLC_INT (local labels). Documented the new circuit, threshold
    derivation, and firmware implications in a schematic note replacing
    the old #14-era one.
    Verified via ERC/DRC against the pre-#19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
    [RP2040_minimal.kicad_sch, powerMux.kicad_sch, robot.kicad_pcb, robot.kicad_sch]
2026-08-10 Add removable I2C isolation jumpers on i2c0 and i2c1 (fixes #18)
    Add a 0-ohm series resistor on both SDA and SCL for each slave on the
    shared I2C buses, so a specific device can be isolated during
    debugging (bus lockup / SDA-held-low) by pulling one resistor instead
    of physical rework.
    i2c0: R32/R33 (U1, STWLC38), R34/R35 (U12, fuel gauge), R36/R37 (U8,
    motor driver), R38/R39 (U9, motor driver), R40/R53 (U6, MAX77857 -
    placed between the level-shifter U5 and U6 so it isolates only that
    branch). J9's existing link to the USB-PD module (R6/R7) was already
    covered, no new jumper needed there.
    i2c1: R55/R57 (U13, MAX77976 charger) and R65/R73 (J9's other I2C
    link to the USB-PD module) - extend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
    [Charger.kicad_sch, Protection.kicad_sch, USB-PD-PhonePC.kicad_sch, Wireless-Receiver.kicad_sch, boostRegulator.kicad_sch, motors.kicad_sch, robot.kicad_pcb]
2026-08-12 Re-unify USB-PD module into main board (single-PCB architecture) (#17)
    Merges the USB-PD module circuitry back into the main robot board as
    a single PCB, reversing the earlier main-board/USB-PD-daughter-board
    split. Full re-route and re-placement of the combined design:
    - Consolidated low-profile parts toward the board center, using the
    space freed up by relocated capacitors, for better overall use of
    the available area.
    - Kept all 0-ohm test/isolation jumpers in accessible locations for
    bench testing.
    - Added/corrected footprints for several parts that had broken or
    incorrect footprints (DDC6_TEX variants, SOT-23-6, SOT-23-3,
    R0402).
    Carries forward every closed correction issue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
    [Charger.kicad_sch, LDO.kicad_sch, Protection.kicad_sch, RP2040_minimal.kicad_sch, USB-PD-ExtChg.kicad_sch, USB-PD-PhonePC.kicad_sch, Wireless-Receiver.kicad_sch, boostRegulator.kicad_sch]
2026-08-15 Move S2 back to its original position (fixes #20)
    S2 (the USB data switch, JS202011JCQN) ended up on the wrong side of
    the board when the USB-PD module got merged back in - fine
    electrically, but the 3D-printed bodies have the access hole cut for
    where it used to sit, so it would've been covered by the case.
    Moved it back, along with TP19/TP20 since those are the test points
    sitting right on its switched USB lines (DIFF_SWITCHED_N/P) - no
    reason to leave them stranded away from what they're probing.
    Checked against the original pre-split design: S2 lands back on the
    exact same coordinates it had there. Nets are unchanged on all three
    parts, 0 unconnected items, no new DRC issues around thi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
    [robot.kicad_pcb]
2026-08-15 Remove leftover Conn_01x16, tidy up hierarchical labels (fixes #21)
    Deleted J2, the old castellated-edge connector placeholder left over from when USB-PD was a separate board - it's been DNP/off-board since the reunification and wasn't even in the netlist, so nothing to reroute. Reconnected the signals that used to fan into it (USB_Phone_SYS, PGND, VCIN, SCL_M/SDA_M, INTB_SL, AGND, VIO1/VIO2, SCL_SL/SDA_SL, DP1/DN1) with proper hierarchical labels instead. Checked ERC/DRC before and after: same connectivity, 0 unconnected items, no new violations - the only thing that dropped off was the "footprint not in library" warning J2 itself used to trigger.
    [USB-PD-PhonePC.kicad_sch, robot.kicad_pcb]
2026-08-15 Add isolation jumper for U21 (fixes #18)
    Added R122/R123, same 0-ohm/0603 pattern as the other 10 jumpers - one on I2C0_SCL, one on I2C0_SDA, right at U21's pins, so it can be pulled off the bus during debugging like the rest of the slaves. ERC/DRC clean.
    [boostRegulator.kicad_sch, robot.kicad_pcb]
2026-08-15 Fix stale refdes and overvoltage claim in TPS3808 schematic note (fixes #14)
    Note still had the pre-reunification refdes (U14/U15, R16/R17, R9/R12, R24/R25) instead of today's U30/U31, R53/R54, R116/R117, R119/R121. Also fixed the overvoltage line Christopher flagged in #19 - SENSE isn't limited to VDD, it's rated independently up to 6.5V recommended / 7V abs max per the TPS3808 datasheet, so the existing divider plus D10's clamp stay well inside spec on both channels with no external TVS needed. Text only, no electrical change.
    [RP2040_minimal.kicad_sch]
2026-08-19 Add active shunt clamp and restore bulk-cap footprints for motor VCC (#22)
    Comparator-based shunt (U32/U33/Q7/R124) clamps /MOTORS/VCC around
    5.6V/5.4V hysteresis, dumping regen energy through R124 to PGND.
    Three more 2.7ohm positions (R125-127) left DNP for thermal tuning
    after bench testing.
    Also restores C132-135 (100uF, DNP) bulk-cap footprints on the same
    rail, removed in #16 - footprint only, final value still pending
    Christopher's testing.
    Verified with kicad-cli: ERC clean, DRC shows zero schematic/PCB
    parity mismatches and zero unconnected items.
    [motors.kicad_sch, robot.kicad_pcb]
2026-08-21 Add switch-open discharge detector and low-power OV reference (#22, #23)
    U34 (new, MCP6541 on IC1-VBIAS) senses the power switch via
    Net-(IC1-ON) and forces Q7/R124 (#22's shunt) to discharge
    /MOTORS/VCC when the switch opens, independent of the 3V3 rail.
    OR'd into Q7's gate through D11/D12 alongside U32's existing
    overvoltage trip - discharges in ~2.2ms vs. the ~500-600ms the
    MAX77857 was timing out at.
    Also swaps U33 (TLVH431) for a MAX6006A micropower reference and
    bumps R131 to 412k, per Christopher's request on #22 - cuts the
    clamp's standing current from ~218uA to ~18uA with the same
    5.6V/5.4V thresholds.
    Verified with kicad-cli: ERC clean, 0 unconnected items, schematic
    parity clean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
    [Protection.kicad_sch, motors.kicad_sch, robot.kicad_pcb, robot.kicad_sch]
2026-08-27 Add OUT bypass cap on U33, move #23 divider away from L1 (#24)
    C136 (220pF NP0, 0402) added across U33's OUT to speed up its
    turn-on settling to ~200us - well ahead of the ~300us before
    MAX77857 starts ramping VCC, per both real datasheets. EN stays
    tied to 1V8, no gating circuit needed.
    Also relocated U34/R125/R133 away from L1 (switching inductor,
    different rail) - were under 1mm apart, now ~21mm.
    Verified via kicad-cli: ERC unchanged (333/333), DRC 0 unconnected,
    same pre-existing U12 parity warning only, no new electrical issues.
    [motors.kicad_sch, robot.kicad_pcb]
2026-08-27 Populate 2 of 4 motor-VCC bulk caps with real 100uF/16V parts (#25)
    C132 and C134 (nearest each DRV8830) now use the real
    APXK160ARA101MF611 (NCC, 100uF/16V/24mOhm ESR/2.49A ripple) instead
    of a mismatched BOM entry that pointed to an unrelated 1206 ceramic
    part. C133/C135 stay DNP for bring-up tuning, same part assigned to
    keep BOM data consistent across all four positions.
    Verified via kicad-cli: ERC +4 (cosmetic lib-symbol-mismatch warnings,
    same class as the pre-existing U12 issue), DRC 0 unconnected, same
    single pre-existing parity warning, net -7 DRC warnings overall.
    [motors.kicad_sch, robot.kicad_pcb]
2026-08-28 Gate MAX77857 EN via GPIO22 divider, bump C136 to 100nF (#24)
    R135/R136 (10k/10k) now gate U23.EN from GPIO22 instead of tying it
    straight to 1.8V. GPIO22 low or floating (RP2040 reset/boot default)
    holds EN at 0V, no firmware dependency for the off-state. VIO stays
    on 1.8V, untouched. C136 220pF -> 100nF (CL05A104KA5NNNC) to meet
    the MAX6006's real >=10nF minimum.
    Verified against baseline: ERC 337/337 (no new violations), DRC 0
    unconnected items, no violations tied to the new parts.
    [RP2040_minimal.kicad_sch, boostRegulator.kicad_sch, motors.kicad_sch, robot.kicad_pcb, robot.kicad_sch]
2026-08-28 Clean up BOM fields, regenerate gerbers/BOM/CPL for fab order (#17)
    MPN -> Part Number field rename on a few parts in Protection.kicad_sch
    and USB-PD-PhonePC.kicad_sch for consistent BOM output. R48 value
    0 -> S0 (it's the 3-pin switch footprint, not a real resistor value).
    Re-exported gerbers, drill files, BOM and CPL for the JLCPCB
    fab+assembly order just placed.
    [POS_JLCPCB.xlsx, Protection.kicad_sch, USB-PD-PhonePC.kicad_sch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]
2026-08-28 Vendor missing 3D models, repoint to project-relative paths (#26)
    21 footprints from #22/#23/#25 pointed at ${EASYEDA2KICAD}, a
    per-machine env var outside the repo. 6 older ones (C56-C60, C107)
    had a contributor's local absolute path hardcoded (/home/bo/...).
    Copied the 7 distinct .wrl files into packages3D/ and repointed all
    27 to ${KIPRJMOD}/packages3D/..., same pattern the other 339
    footprints already use. Path-only change, no design edits -- ERC/DRC
    unaffected (337/337, 40/40).
    [robot.kicad_pcb]
